MS71/ROS2Mower/README.md

# ROS2Mower
autonomous ROS2 lawn mower

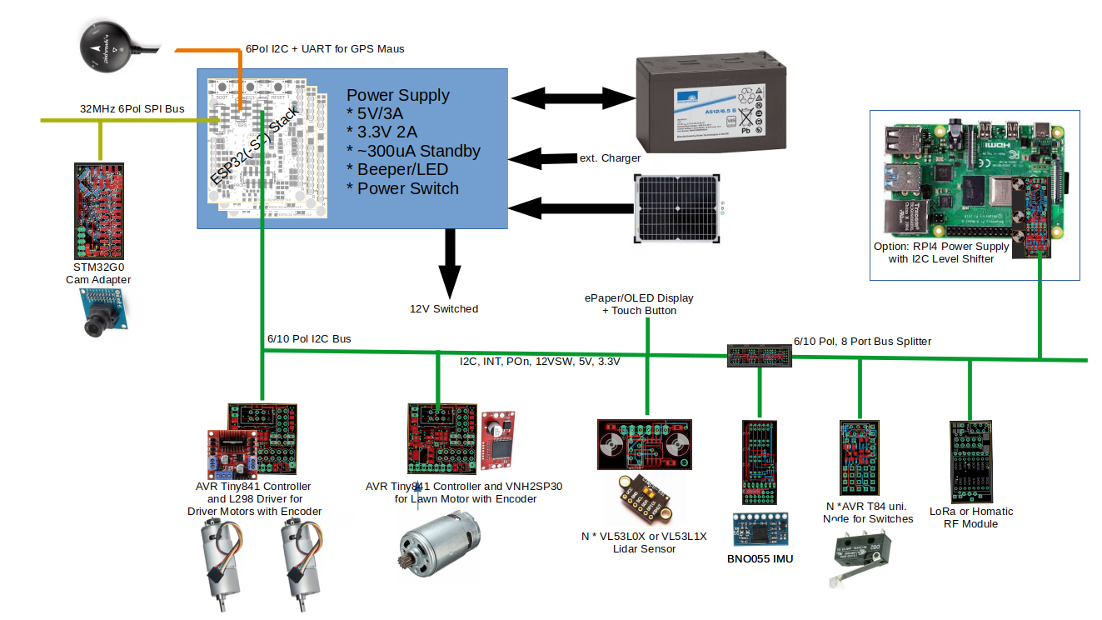
[picture p1: images/architecture_01.png]


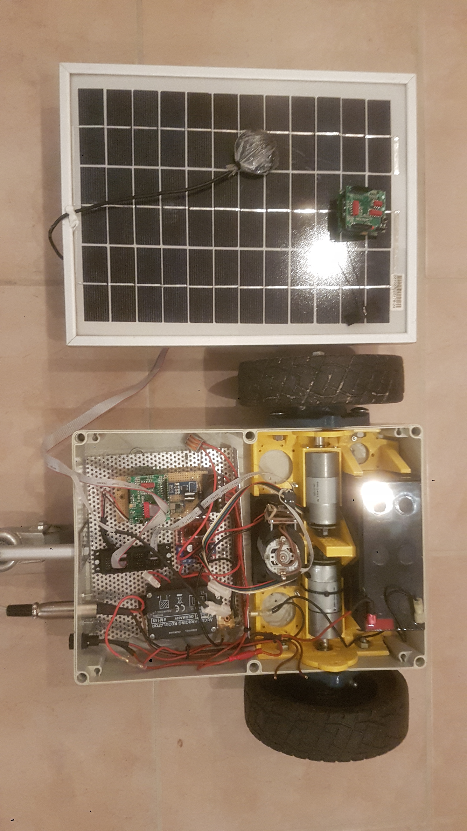
[picture p2: images/ros2mower_01.jpg]
