MS71/ROS2Mower/images/architecture_01.odp

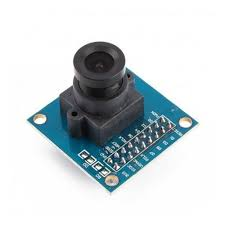
[picture p3: figure]
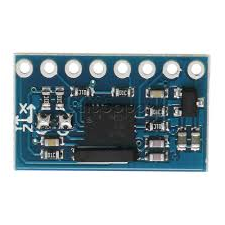
[picture p4: figure]
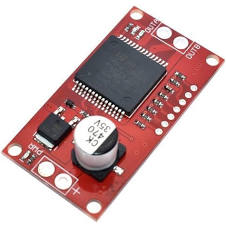
[picture p5: figure]

ESP32(-S2) Stack

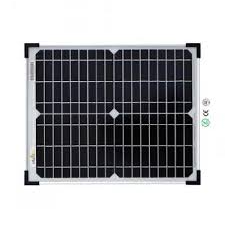
[picture p6: figure]
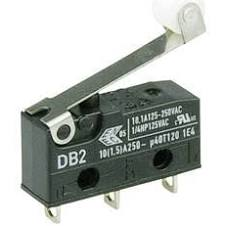
[picture p7: figure]
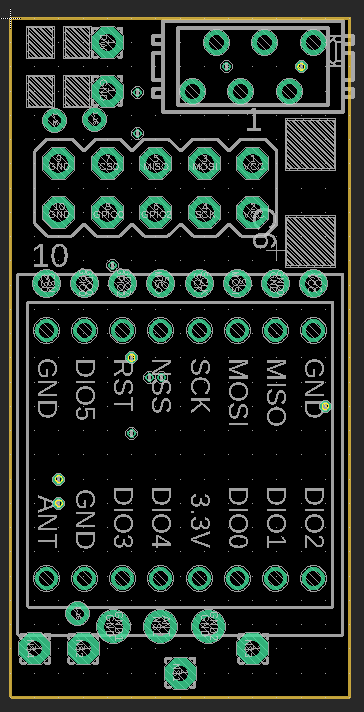
[picture p8: figure]
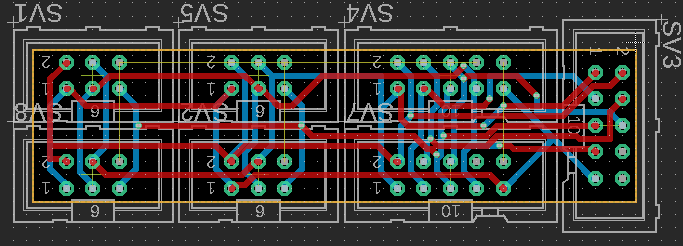
[picture p9: figure]
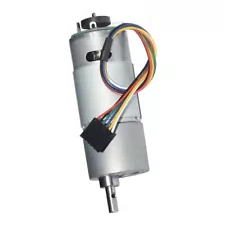
[picture p10: figure]
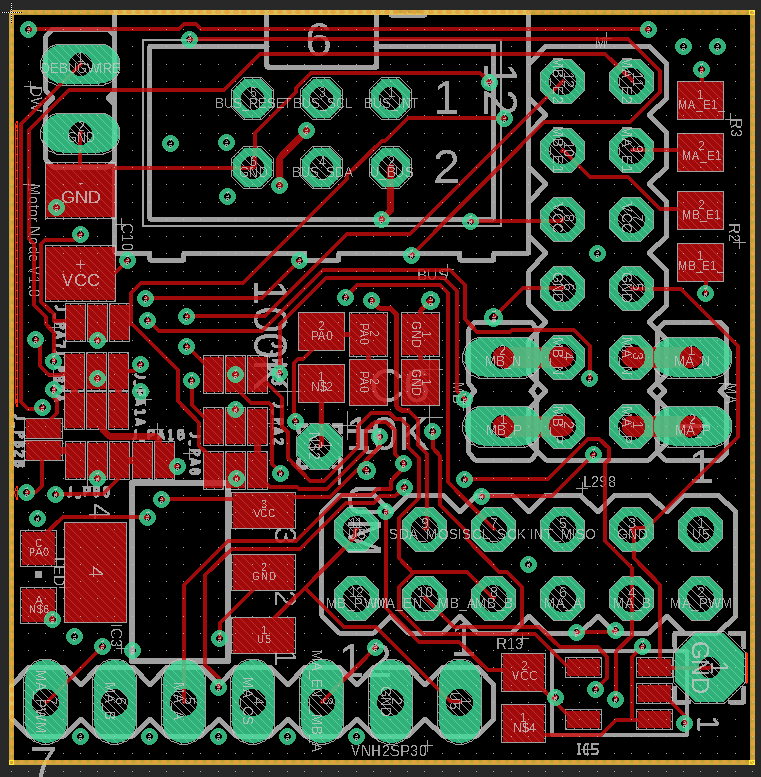
[picture p11: figure]
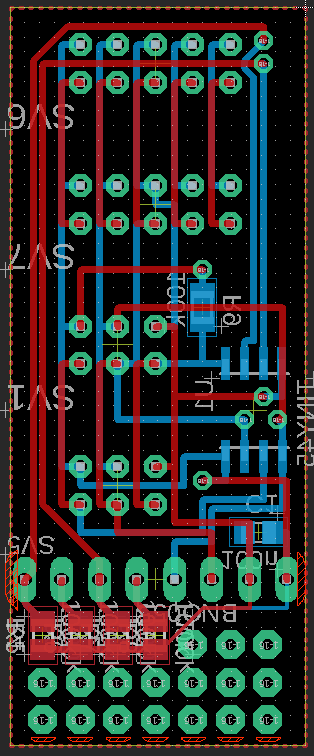
[picture p12: figure]
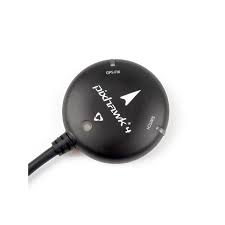
[picture p13: figure]
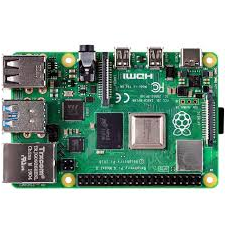
[picture p14: figure]

32MHz 6Pol SPI Bus

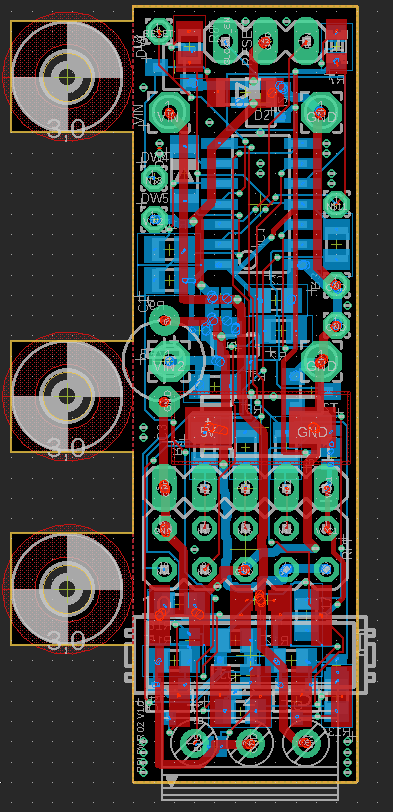
[picture p15: figure]

6Pol I2C + UART for GPS Maus

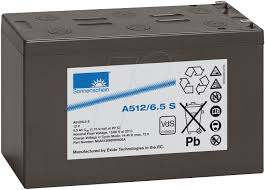
[picture p16: figure]
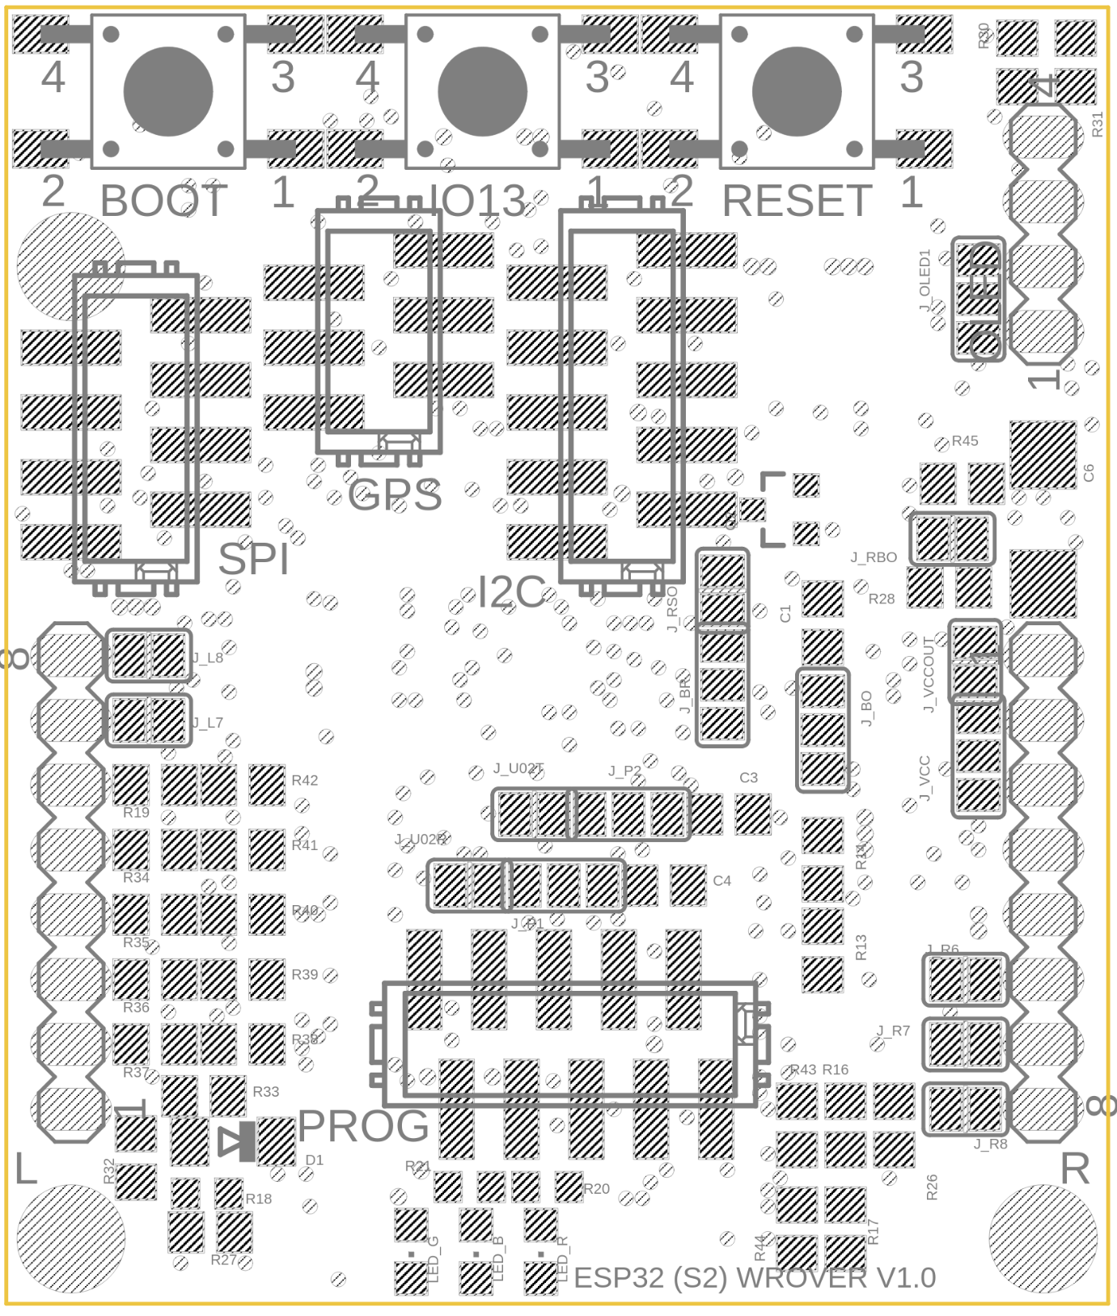
[picture p17: figure]

Power Supply

* 5V/3A

* 3.3V 2A

* ~300uA Standby

* Beeper/LED

* Power Switch

Option: RPI4 Power Supply

with I2C Level Shifter

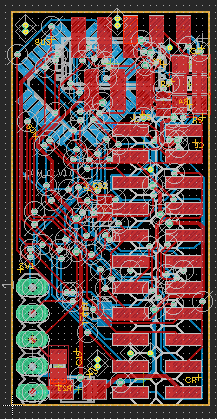
[picture p18: figure]

STM32G0

Cam Adapter

ext. Charger

6/10 Pol I2C Bus

12V Switched

ePaper/OLED Display

+ Touch Button

6/10 Pol, 8 Port Bus Splitter

I2C, INT, POn, 12VSW, 5V, 3.3V

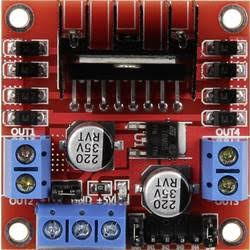
[picture p19: figure]
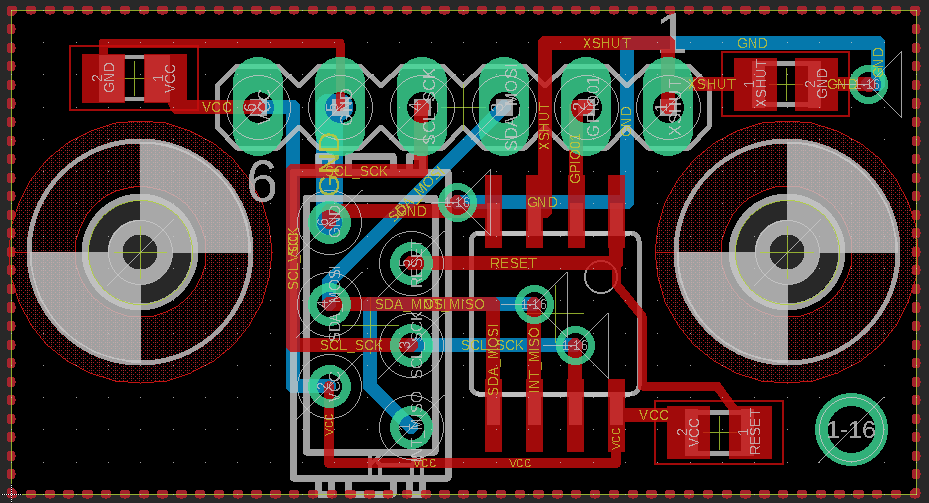
[picture p20: figure]
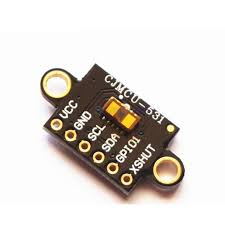
[picture p21: figure]

N * VL53L0X or VL53L1X

Lidar Sensor

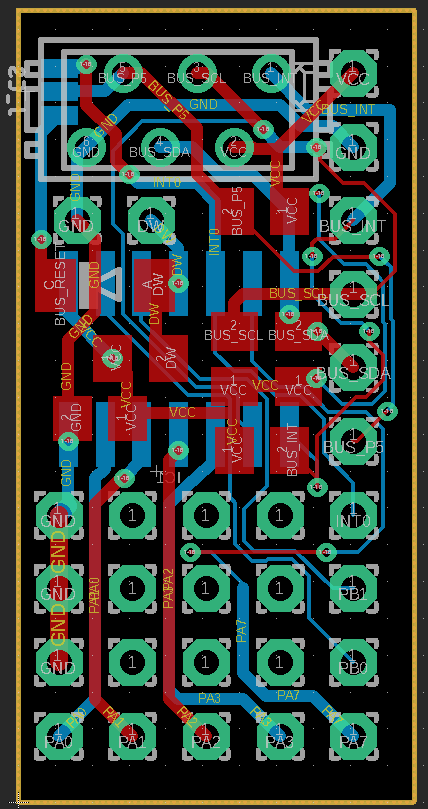
[picture p22: figure]

AVR Tiny841 Controller

and L298 Driver for

Driver Motors with Encoder

AVR Tiny841 Controller and VNH2SP30

for Lawn Motor with Encoder

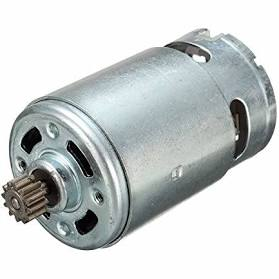
[picture p23: figure]

N *AVR T84 uni.

Node for Switches

LoRa or Homatic

RF Module

BNO055 IMU

BNO055 IMU
