MS71/ROS2Mower/3dparts/motorchassis_01.png

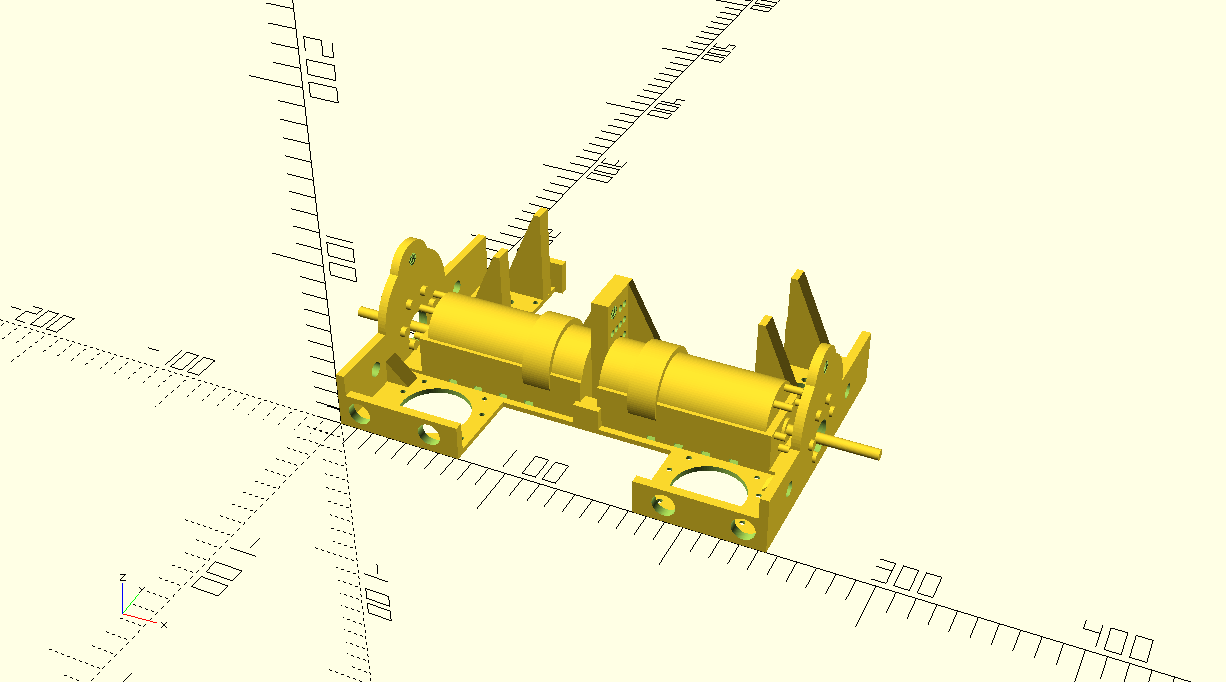
3dparts/motorchassis_01.png
