MS71/ROS2Mower/3dparts/nextgen_01.png

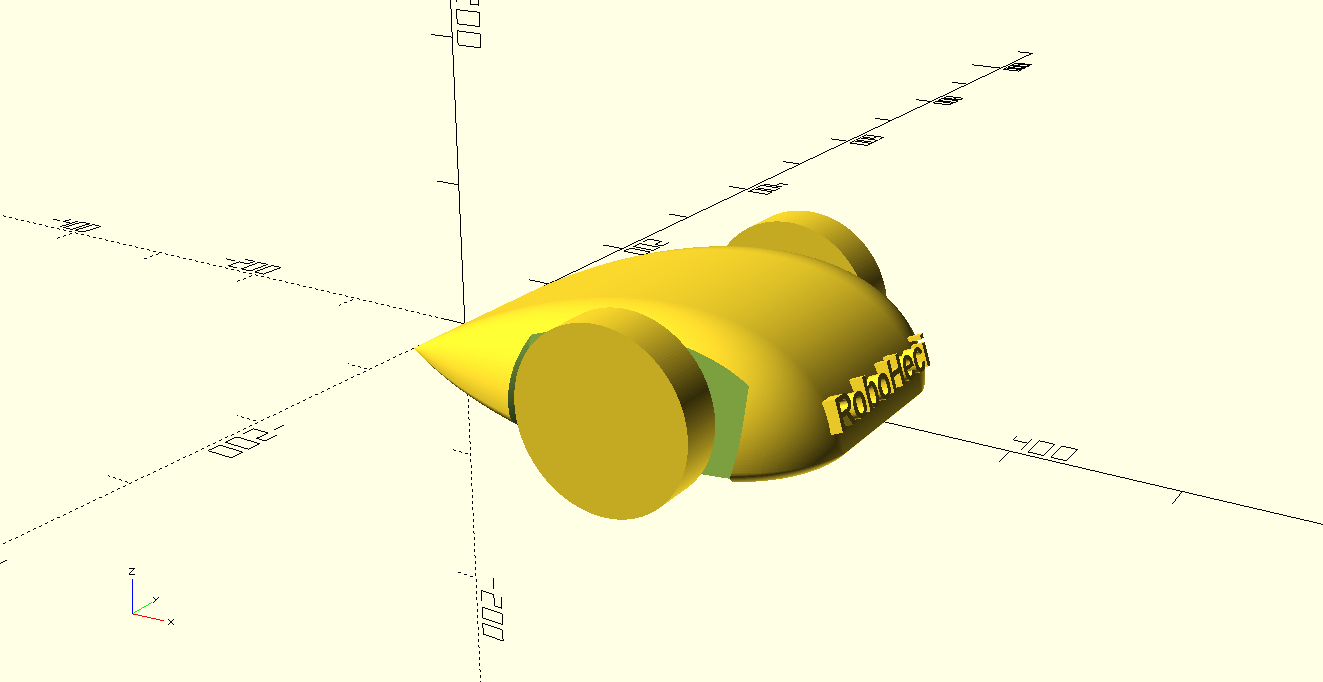
3dparts/nextgen_01.png
