MS71/ROS2Mower/3dparts/nextgen_01_unten.png

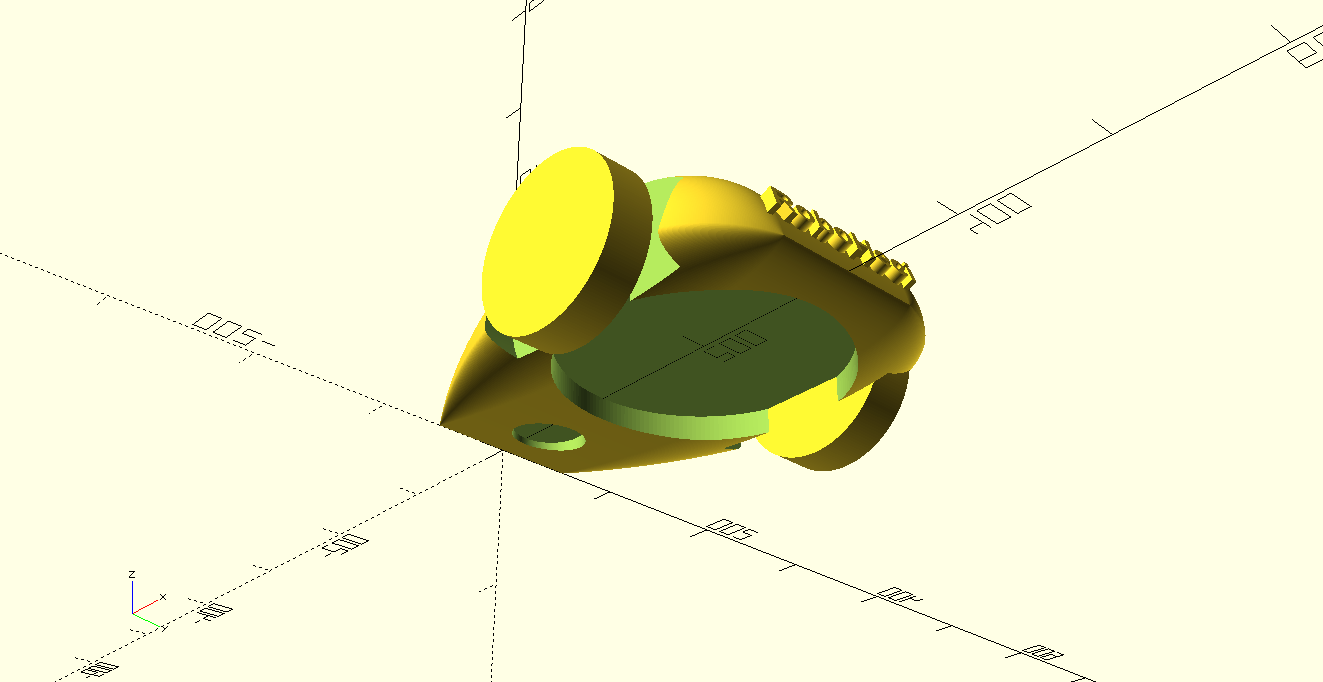
3dparts/nextgen_01_unten.png
