MS71/ROS2Mower/3dparts/busmux.stl

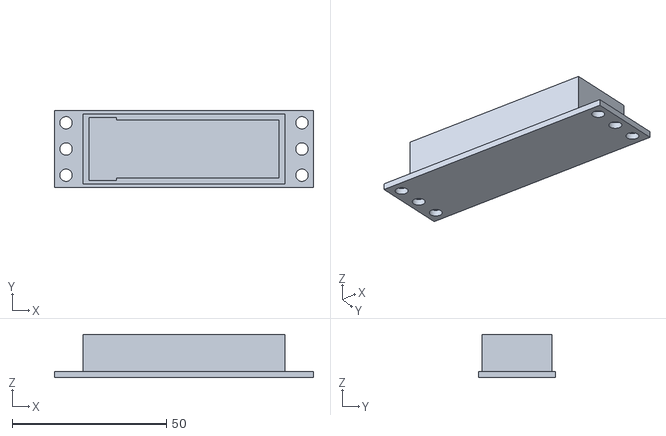
[picture p27: CAD file, 2021-01-19]
3dparts/busmux.stl
84.0 x 25.0 x 14.0
