MS71/ROS2Mower/(list of files, cad)

Other CAD files:
3dparts/motorchassis_02.scad
