MS71/ROS2Mower/hw/spi_node.pdf

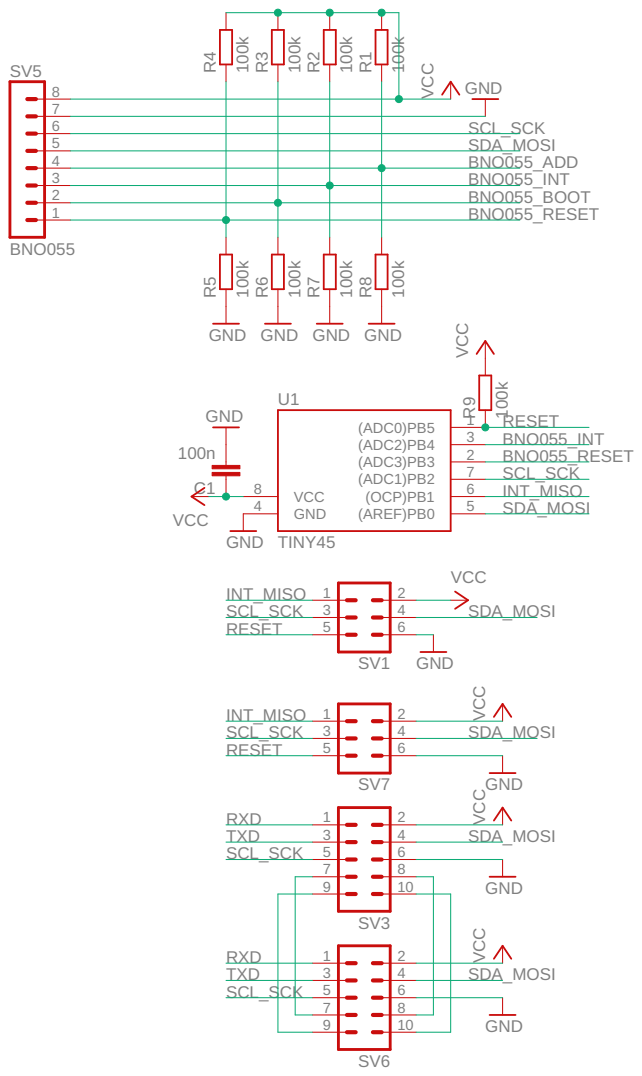
[picture p28: page 1]

GND GND

Document Number: | REV:

Date: 7/7/20 6:42 PM | Sheet: 1/1
