MS71/ROS2Mower/hw/motor_node_bot.pdf

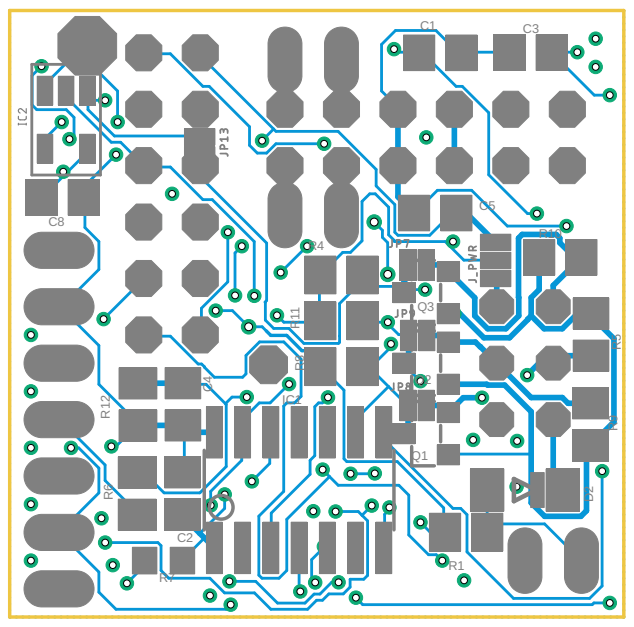
[picture p29: page 1]
