MS71/ROS2Mower/hw/motor_node_top.pdf

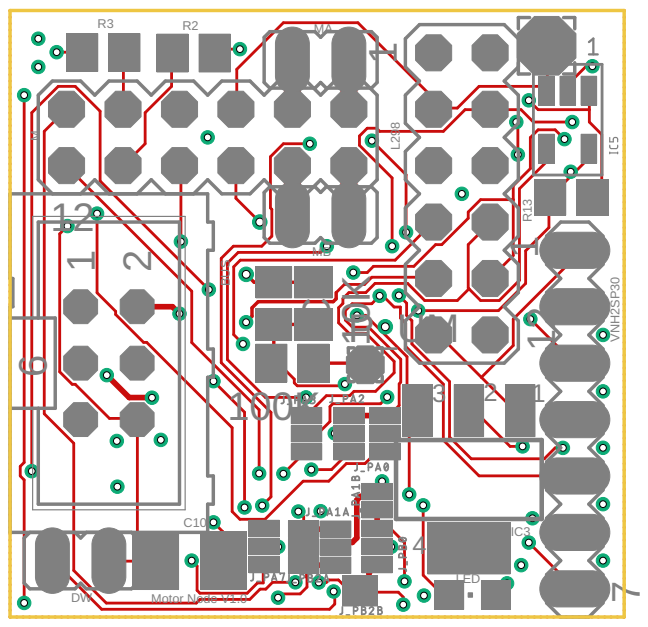
[picture p30: page 1]
