MS71/ROS2Mower/hw/lidar_node.pdf

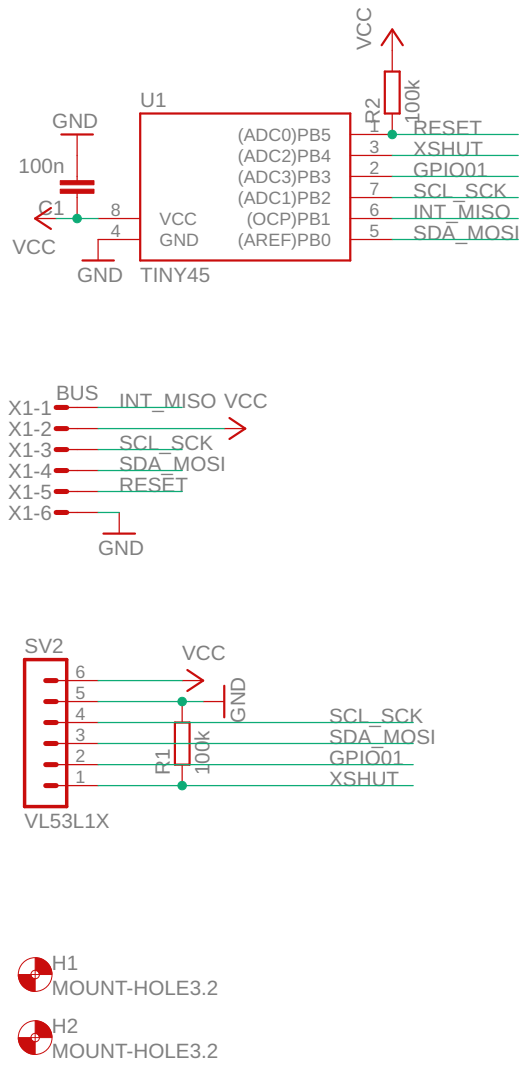
[picture p31: page 1]

Document Number: | REV:

Date: 6/22/20 8:21 PM | Sheet: 1/1
