MS71/ROS2Mower/hw/lidar_node_bot.pdf

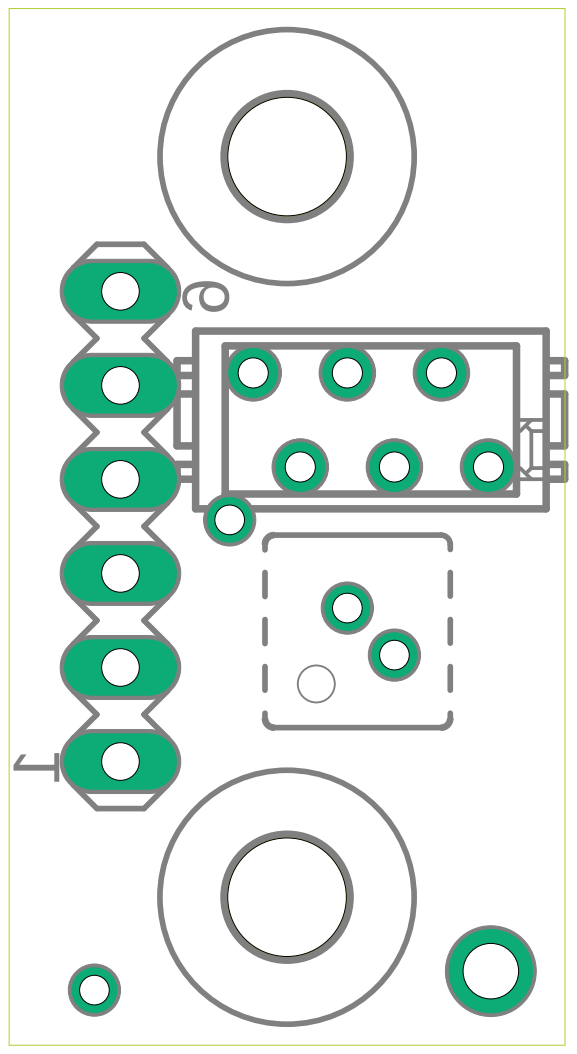
[picture p32: page 1]
