MS71/ROS2Mower/hw/lidar_node_top.pdf

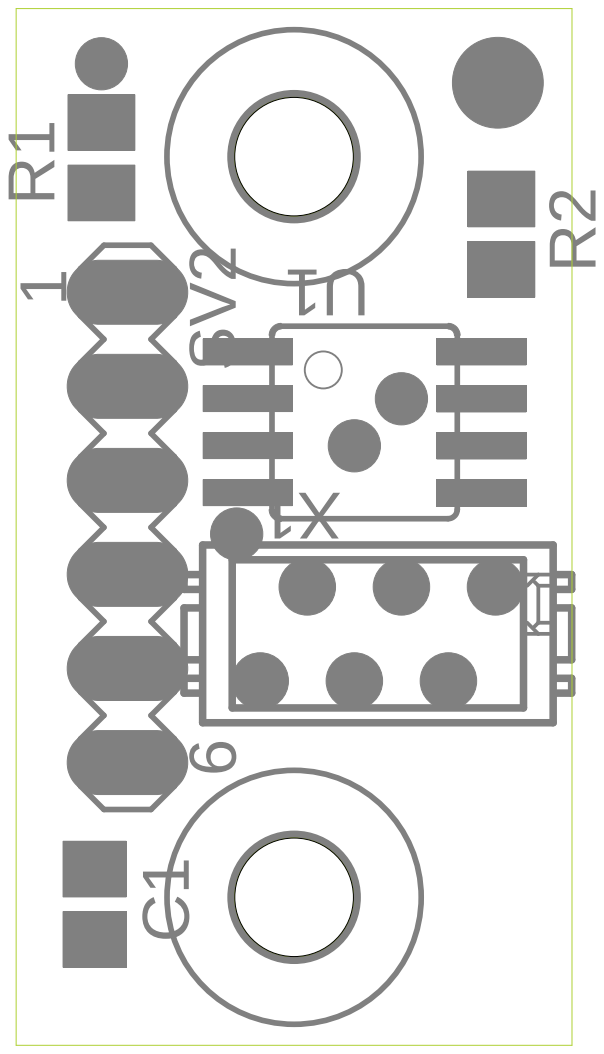
[picture p33: page 1]
