MS71/ROS2Mower/hw/spi_node_bot.pdf

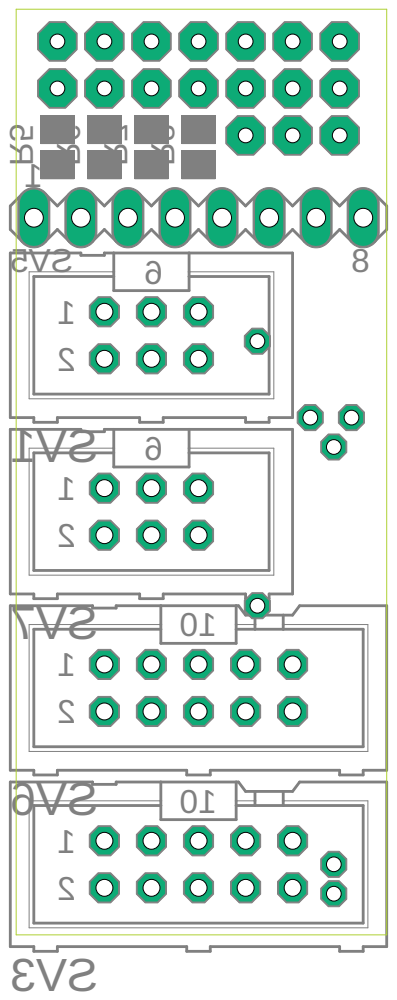
[picture p34: page 1]
