MS71/ROS2Mower/hw/spi_node_top.pdf

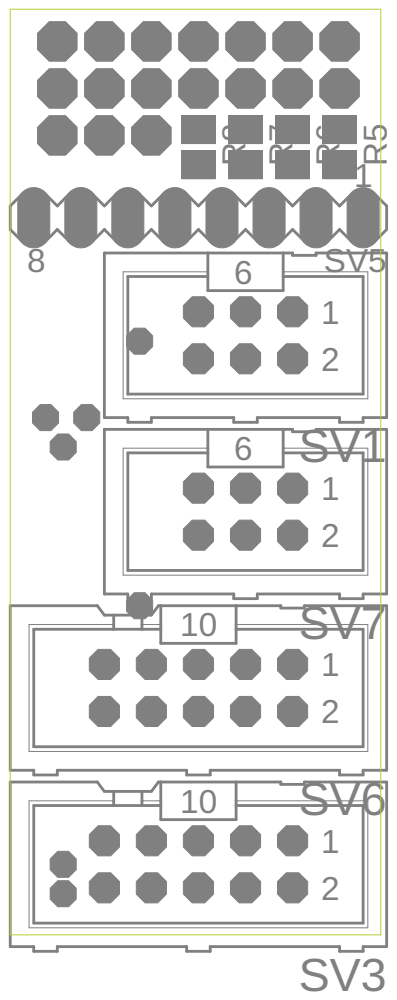
[picture p35: page 1]
