MS71/ROS2Mower/hw/uni_node.pdf

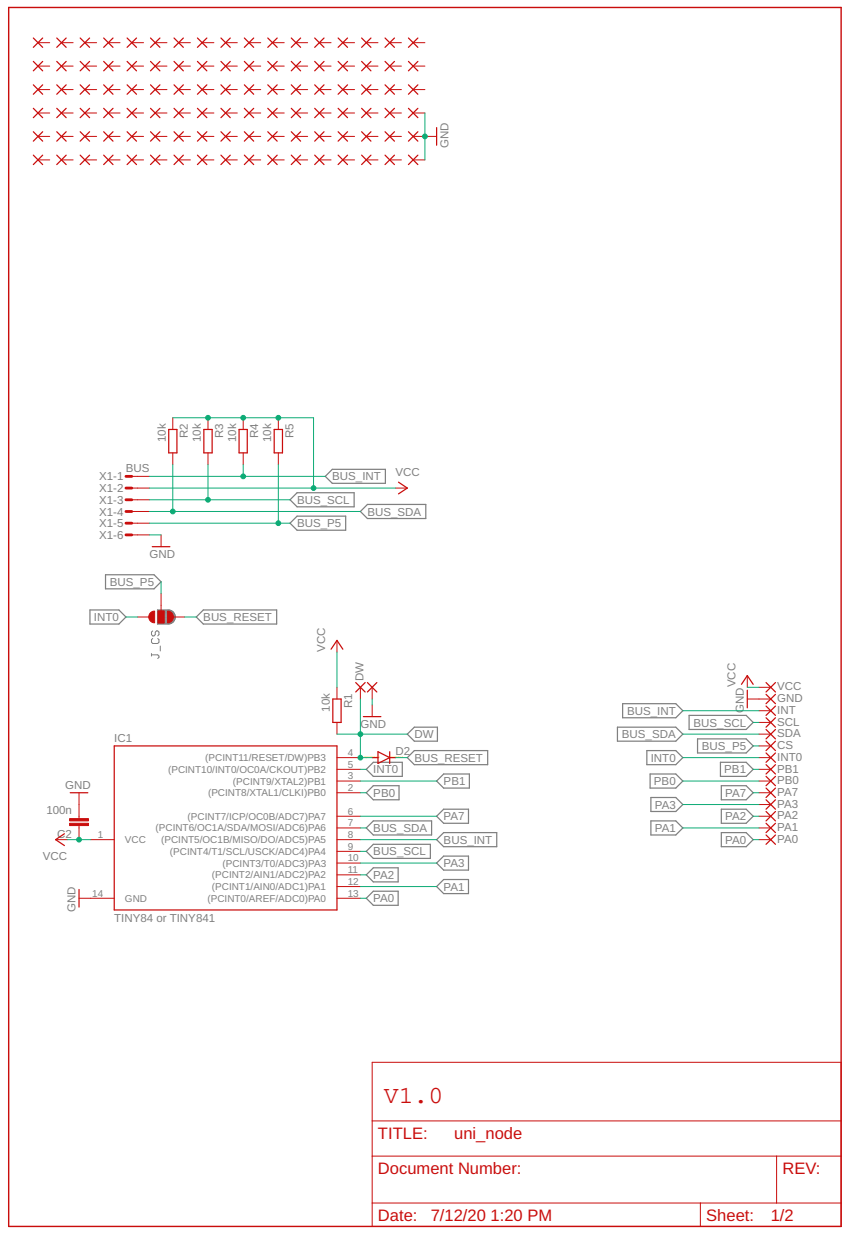
[picture p36: page 1]

Document Number: | REV:

Date: 7/12/20 1:20 PM | Sheet: 1/2
