MS71/ROS2Mower/hw/relais_node_01.pdf

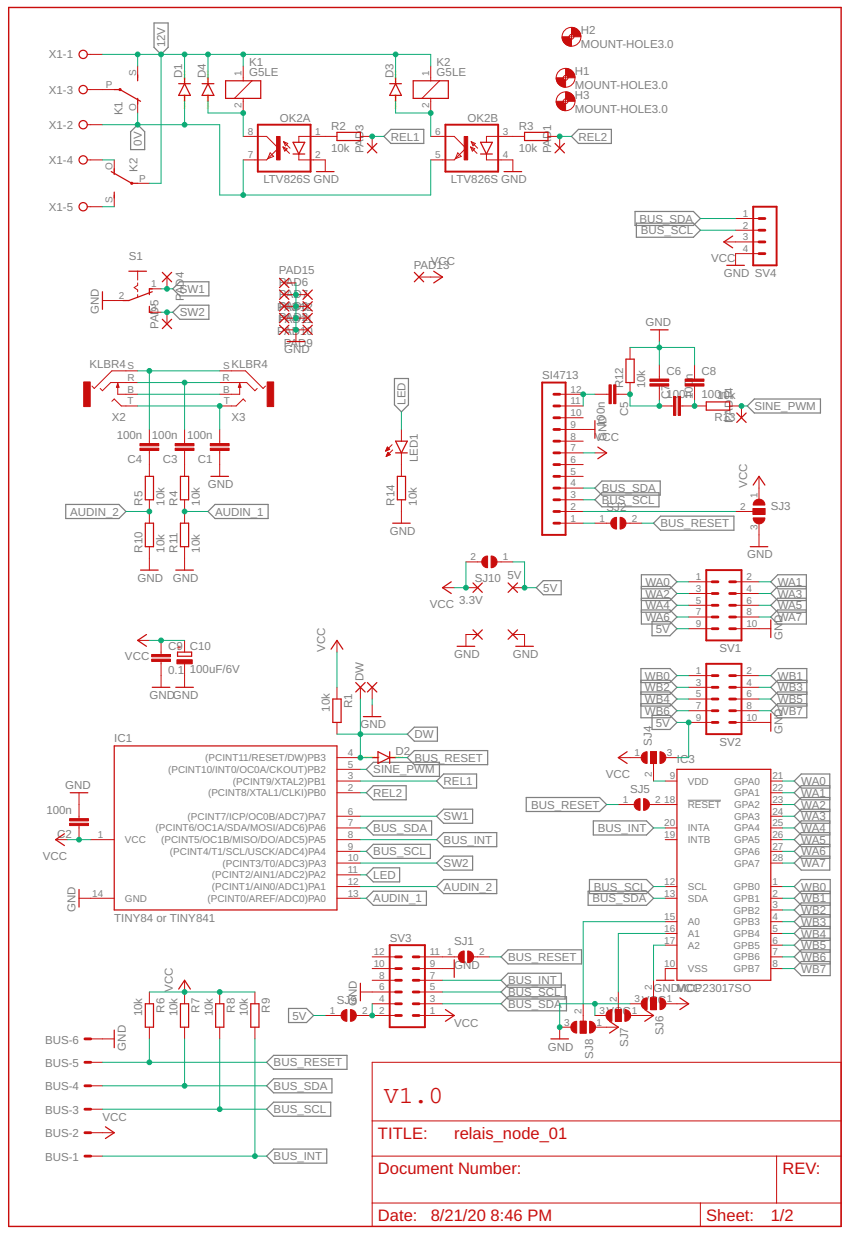
[picture p37: page 1]

Document Number: | REV:

Date: 8/21/20 8:46 PM | Sheet: 1/2
