MS71/ROS2Mower/hw/relais_node_01_bot.pdf

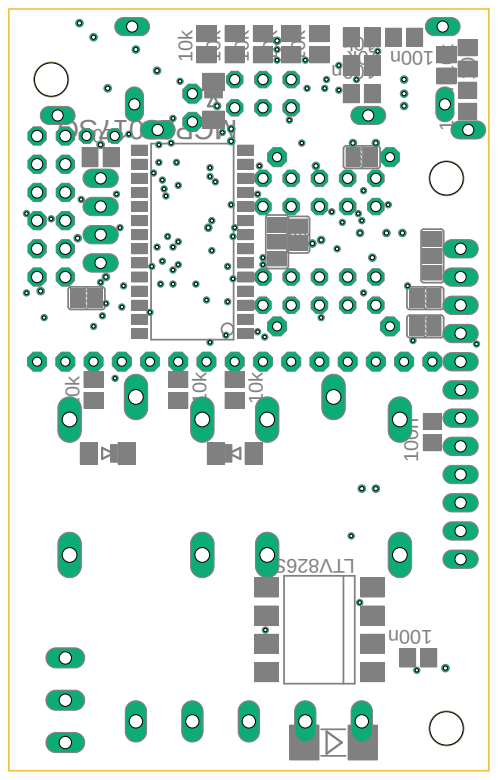
[picture p38: page 1]
