MS71/ROS2Mower/hw/relais_node_01_top.pdf

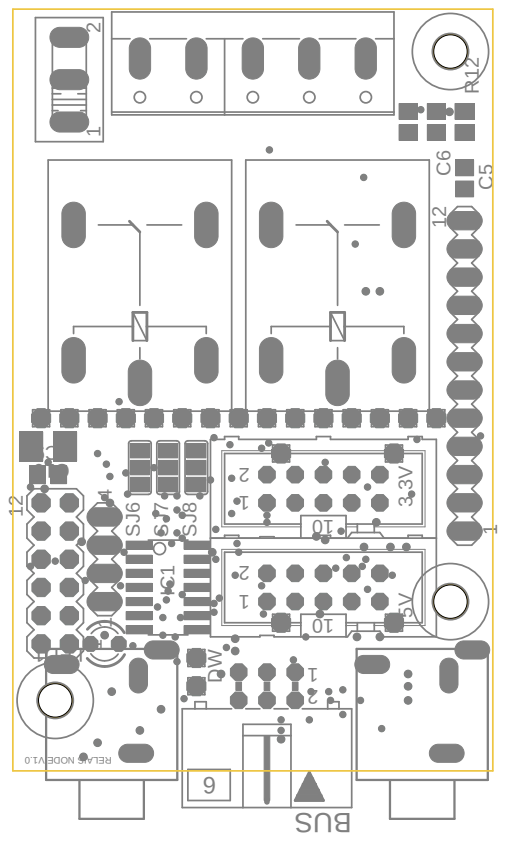
[picture p39: page 1]
