MS71/ROS2Mower/hw/rf_node.pdf

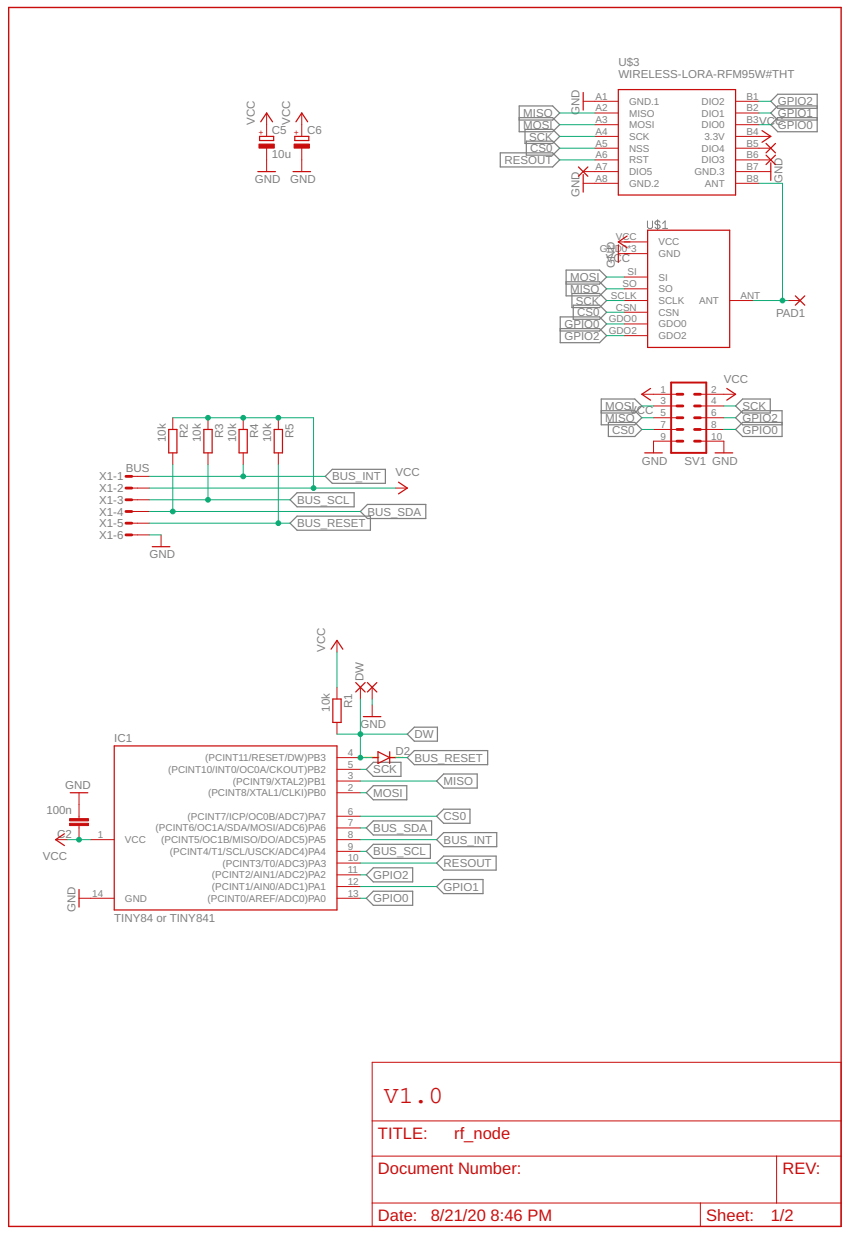
[picture p40: page 1]

Document Number: | REV:

Date: 8/21/20 8:46 PM | Sheet: 1/2
