MS71/ROS2Mower/hw/rf_node_bot.pdf

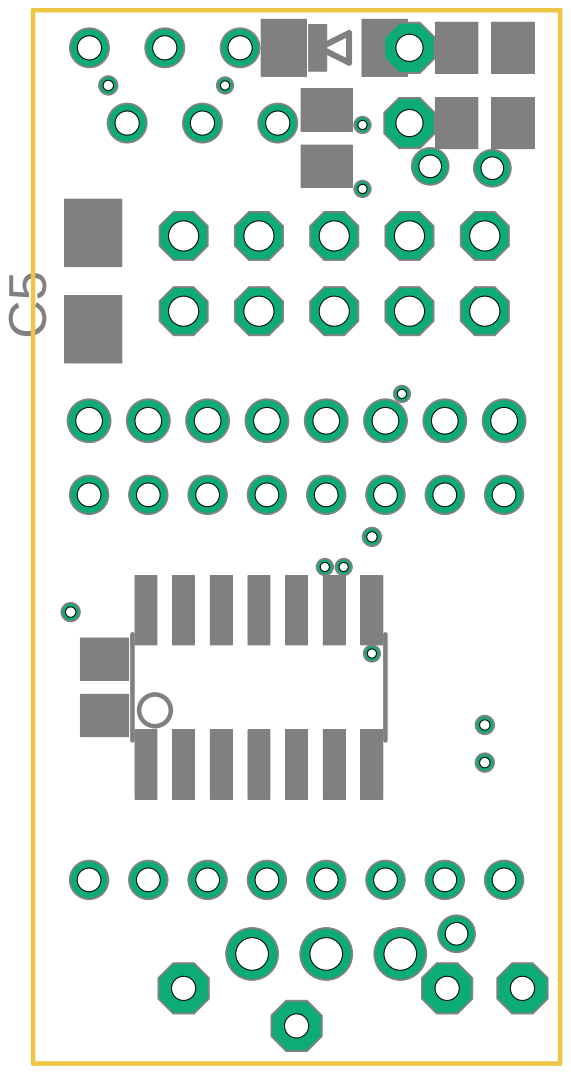
[picture p41: page 1]
