MS71/ROS2Mower/hw/rf_node_top.pdf

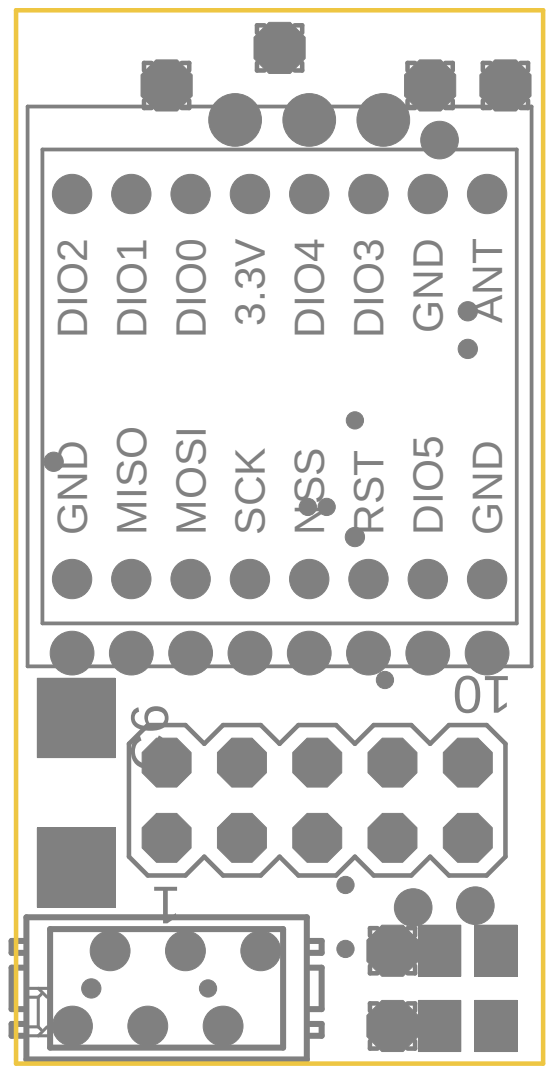
[picture p42: page 1]
