MS71/ROS2Mower/hw/stm32g071_pcb.pdf

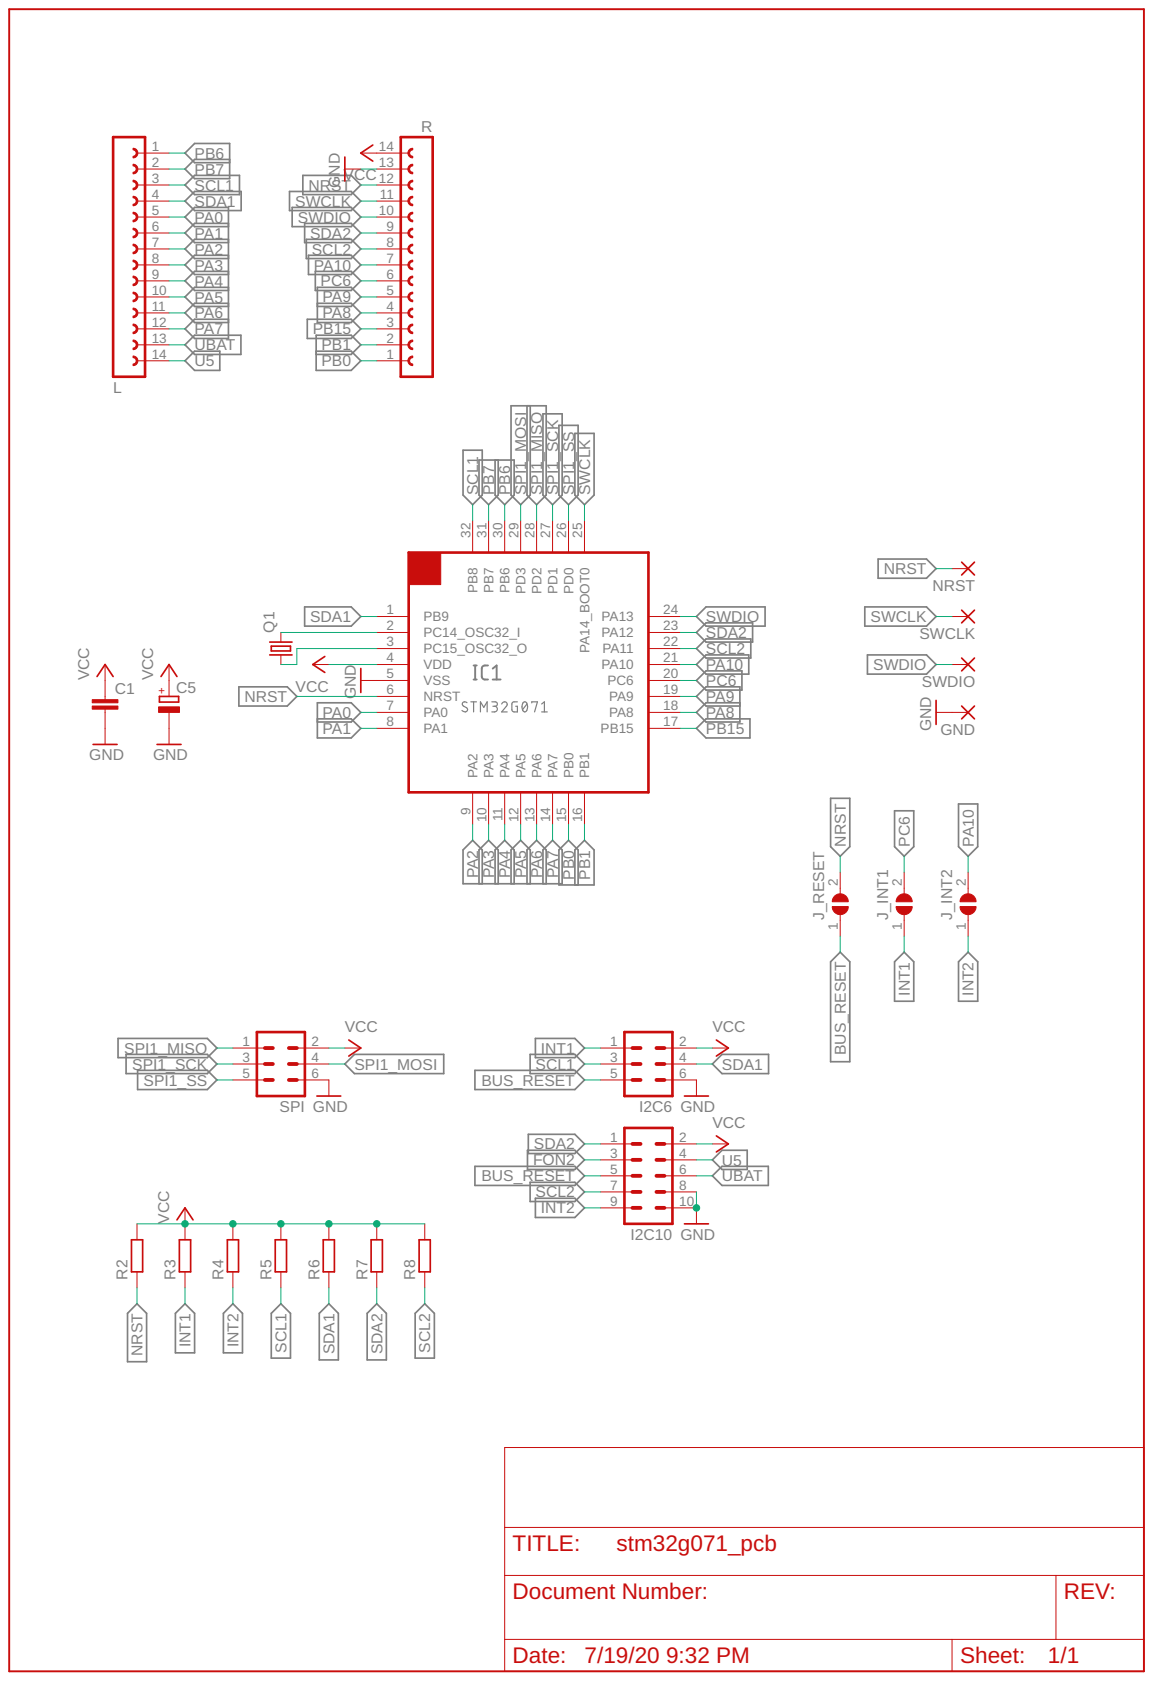
[picture p43: page 1]

Document Number: | REV:

Date: 7/19/20 9:32 PM | Sheet: 1/1
