MS71/ROS2Mower/hw/stm32g071_pcb_bot.pdf

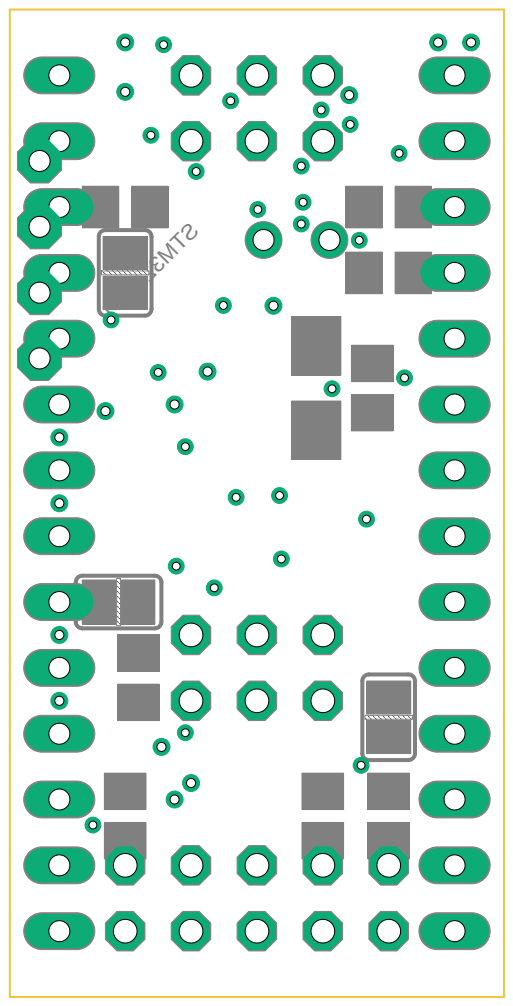
[picture p44: page 1]
