MS71/ROS2Mower/hw/stm32g071_pcb_top.pdf

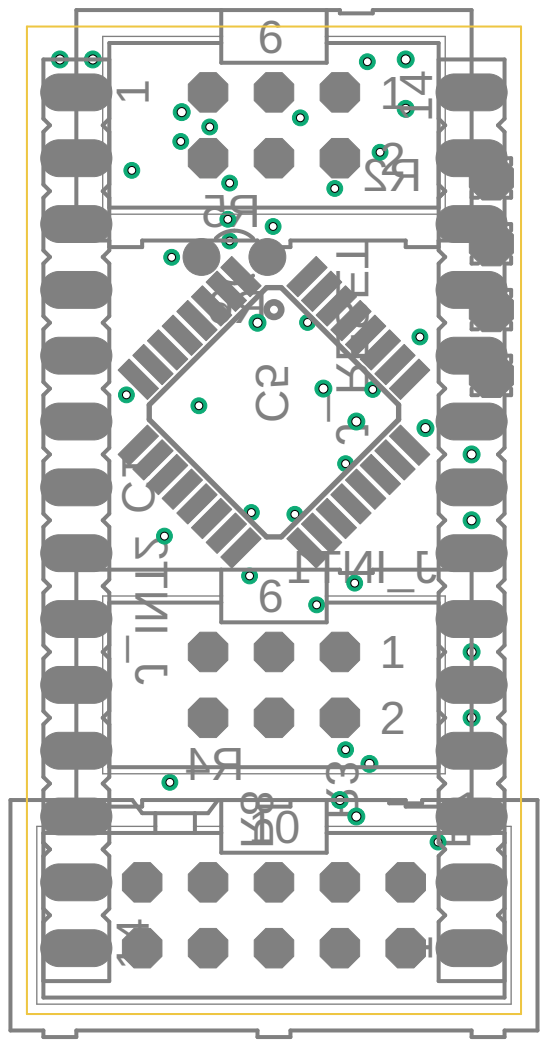
[picture p45: page 1]
