MS71/ROS2Mower/hw/uni_node_02.pdf

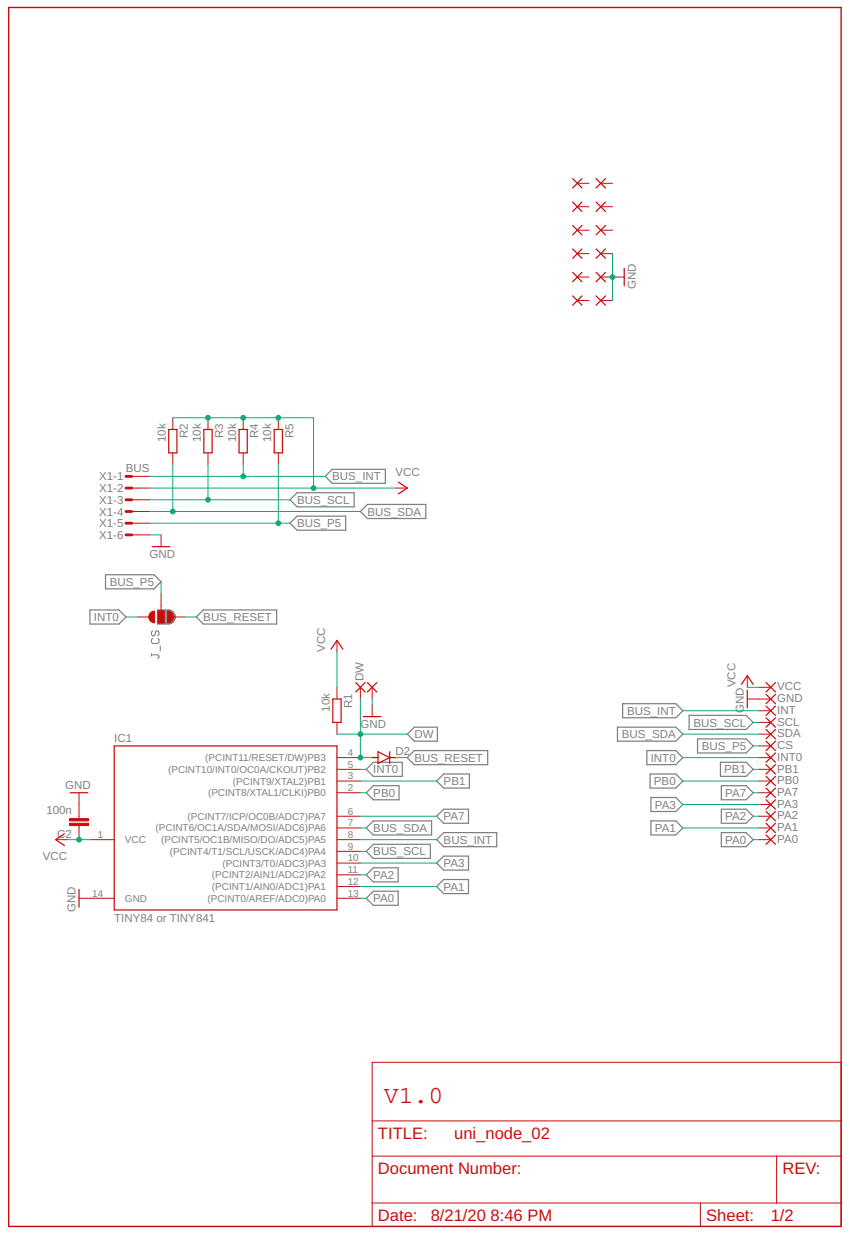
[picture p46: page 1]

Document Number: | REV:

Date: 8/21/20 8:46 PM | Sheet: 1/2
