MS71/ROS2Mower/hw/uni_node_02_bot.pdf

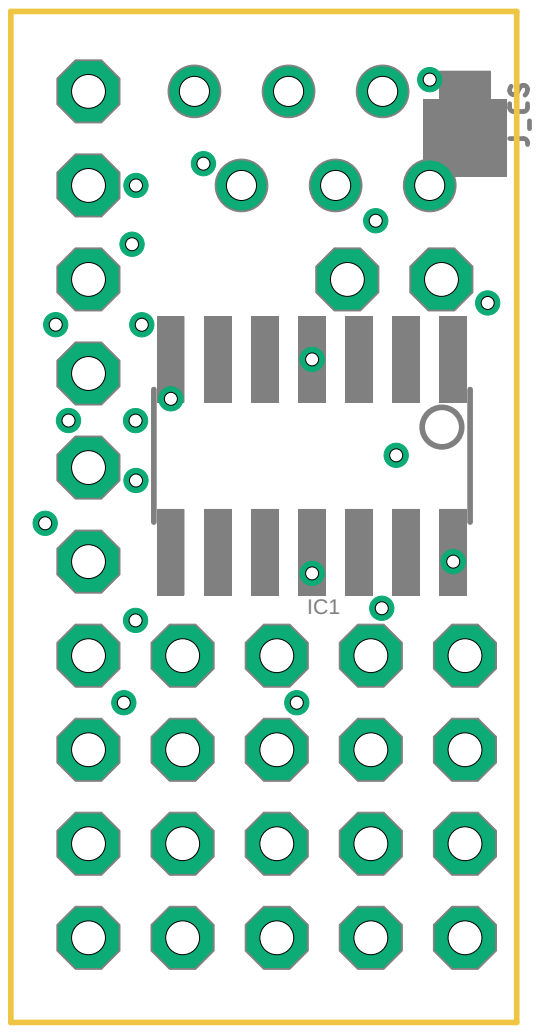
[picture p47: page 1]
