MS71/ROS2Mower/hw/uni_node_02_top.pdf

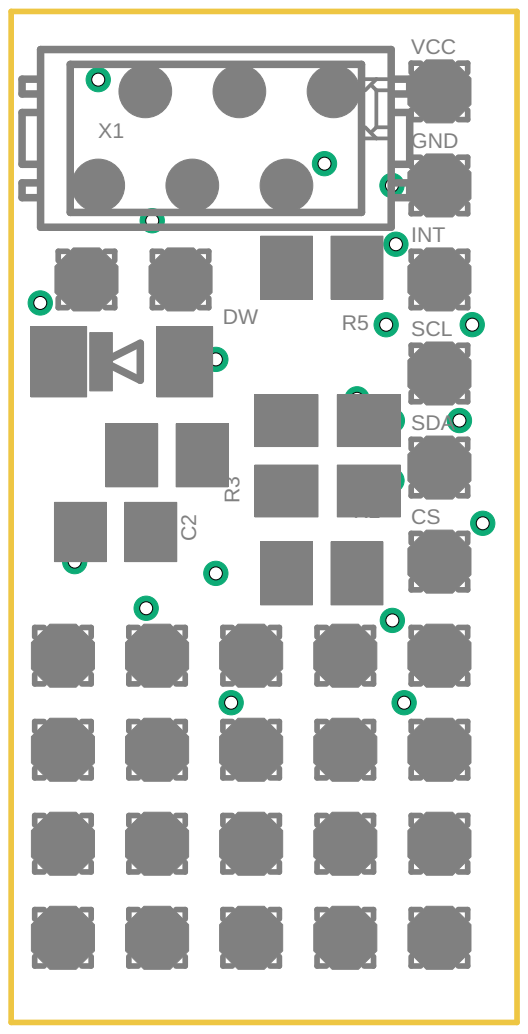
[picture p48: page 1]
