MS71/ROS2Mower/hw/uni_node_bot.pdf

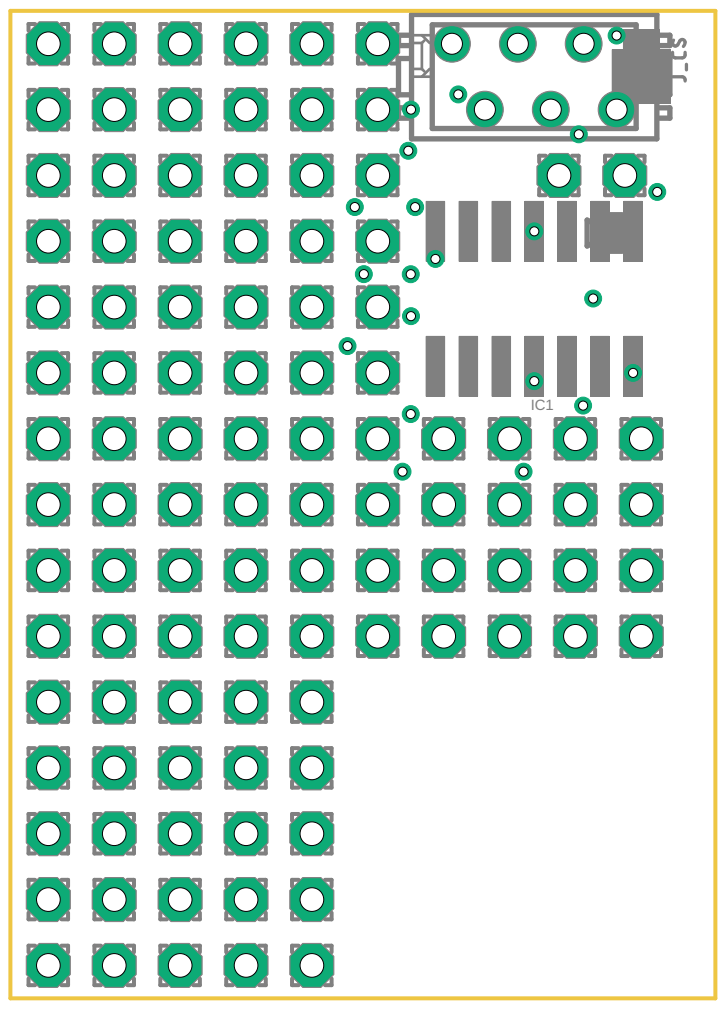
[picture p49: page 1]
