MS71/ROS2Mower/hw/uni_node_top.pdf

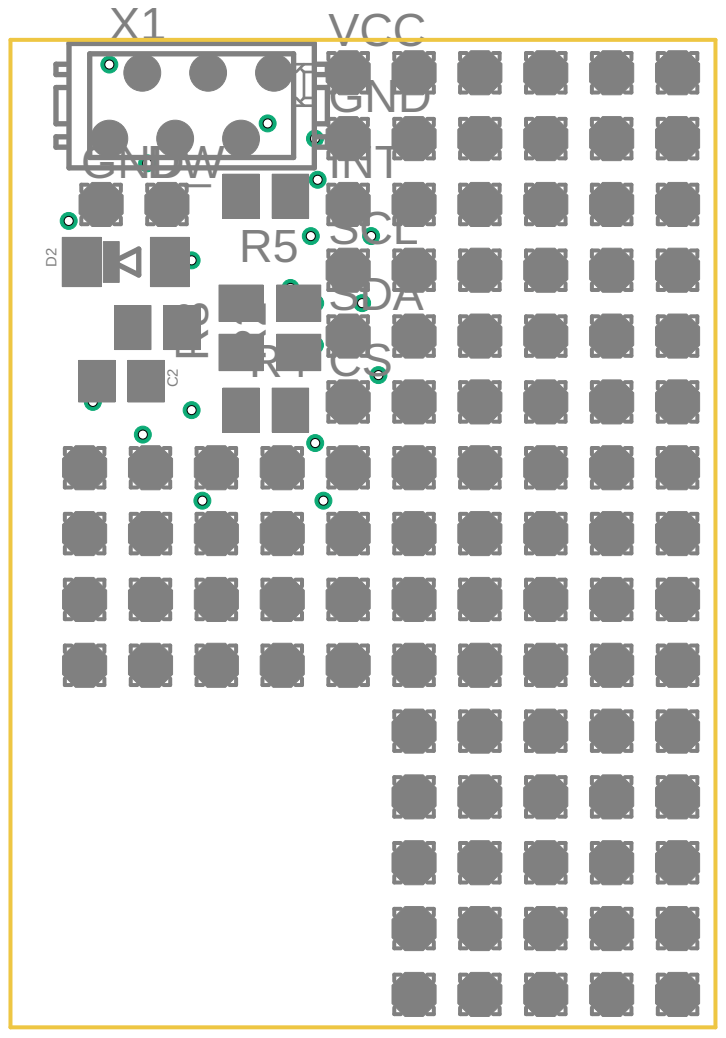
[picture p50: page 1]
