MS71/ROS2Mower/hw/esp32_module.pdf

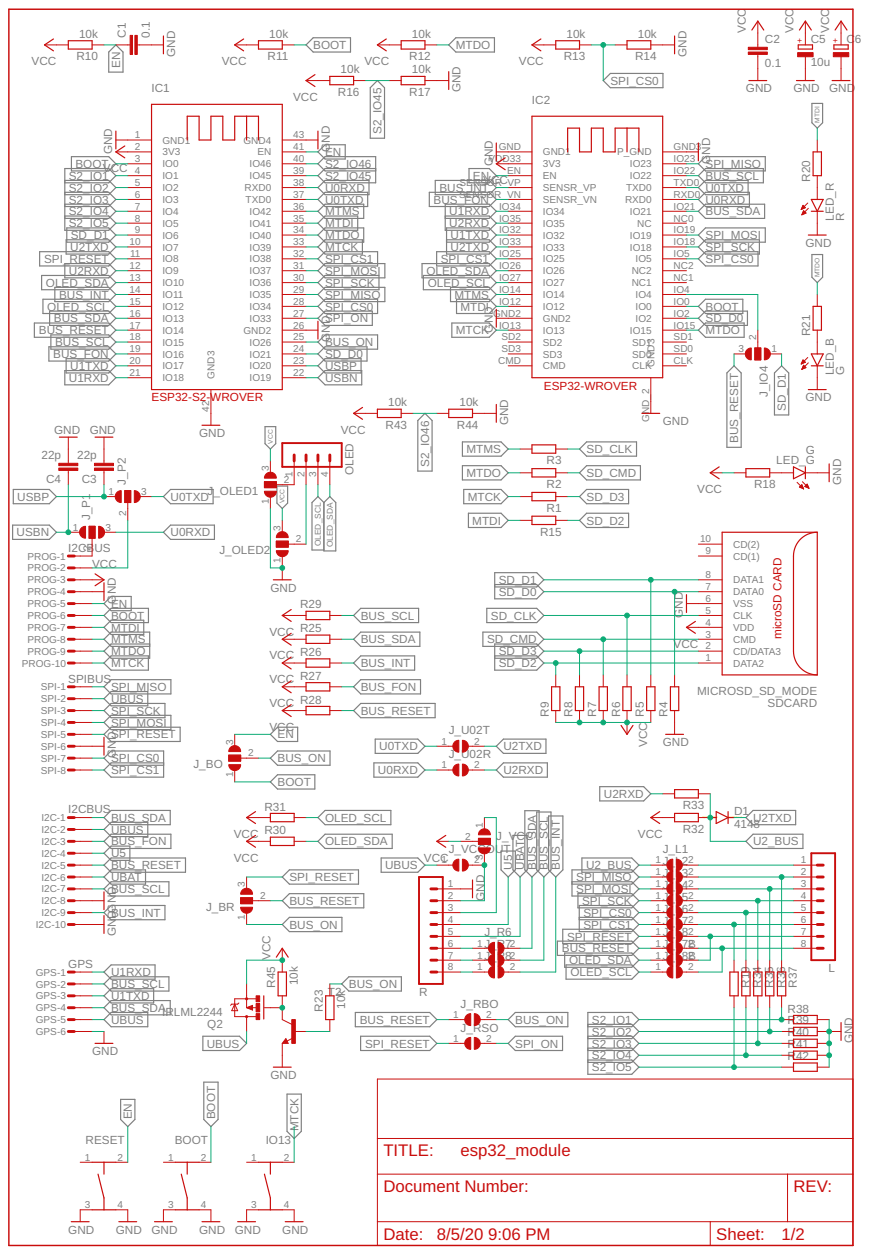
[picture p51: page 1]

Document Number: | REV:

Date: 8/5/20 9:06 PM | Sheet: 1/2
