MS71/ROS2Mower/hw/esp32_module_bot.pdf

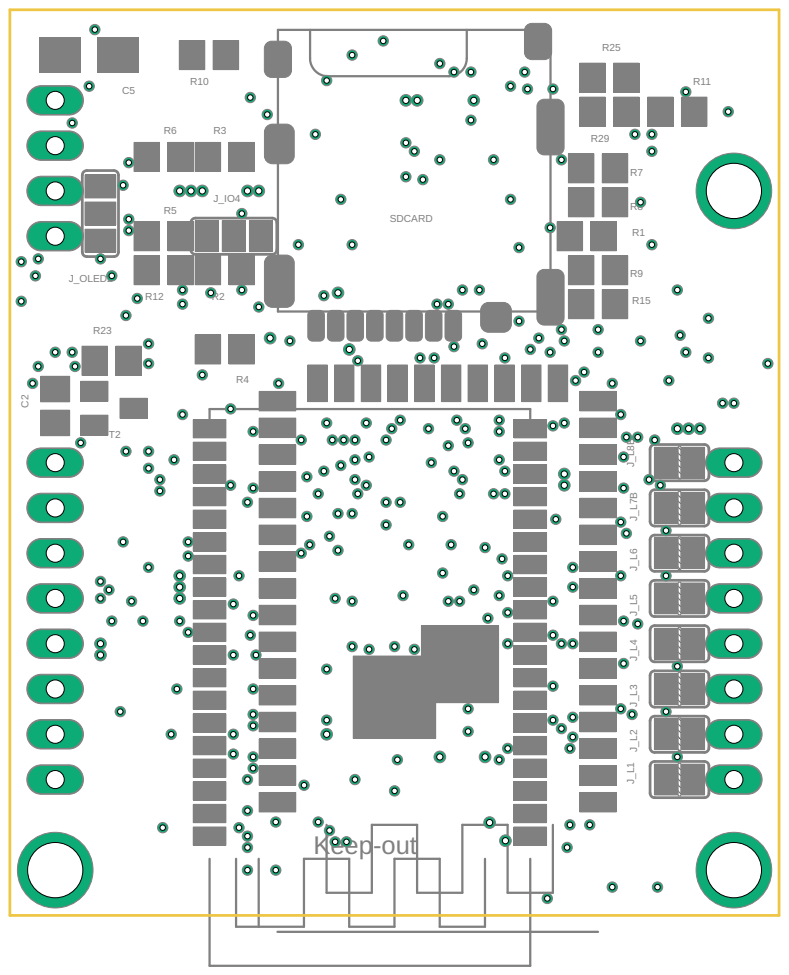
[picture p52: page 1]
