MS71/ROS2Mower/hw/esp32_module_top.pdf

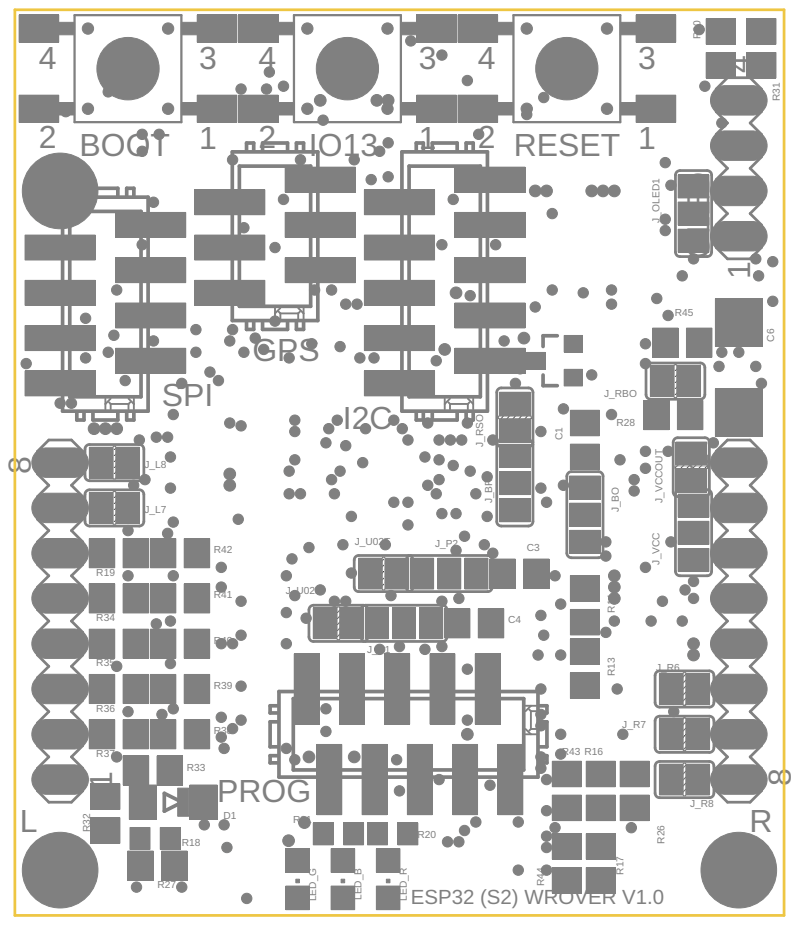
[picture p53: page 1]
