MS71/ROS2Mower/hw/motor_bot.pdf

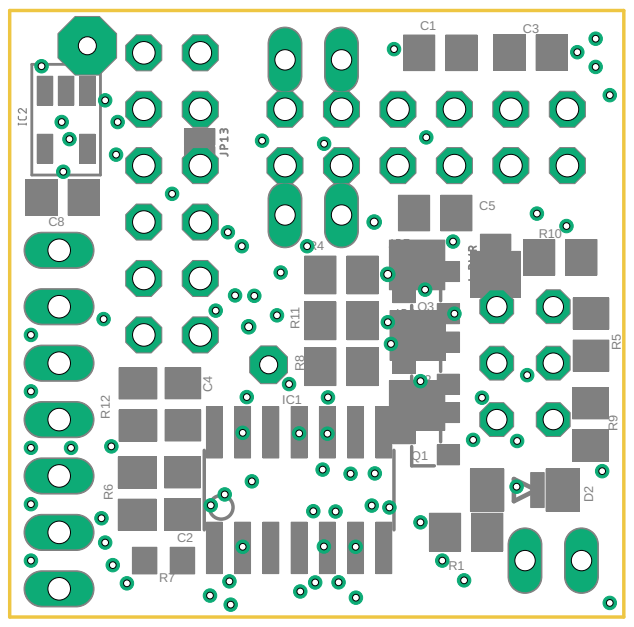
[picture p54: page 1]
