MS71/ROS2Mower/hw/motor_node.pdf

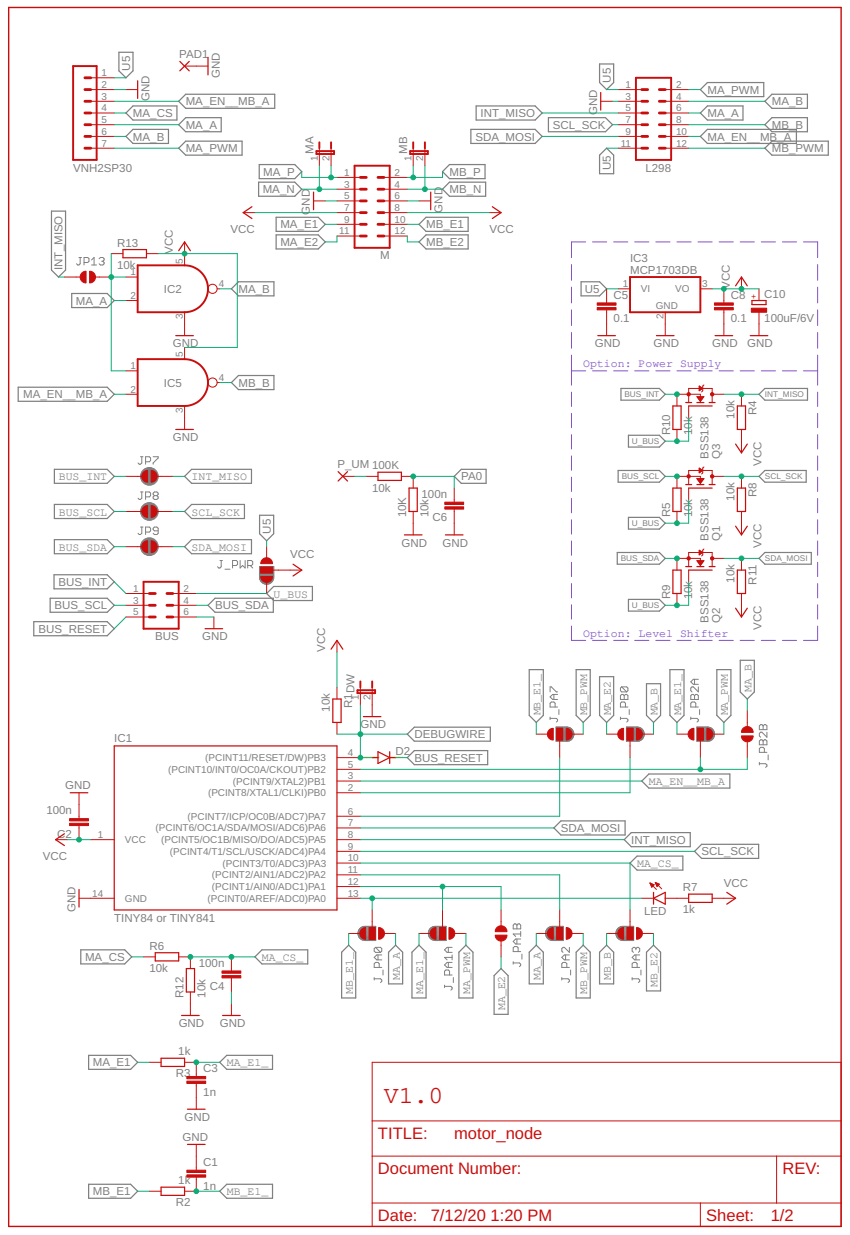
[picture p55: page 1]

Document Number: | REV:

Date: 7/12/20 1:20 PM | Sheet: 1/2
