MS71/ROS2Mower/hw/esp32_module.brd

## EAGLE design hw/esp32_module.brd (2021-11-24)

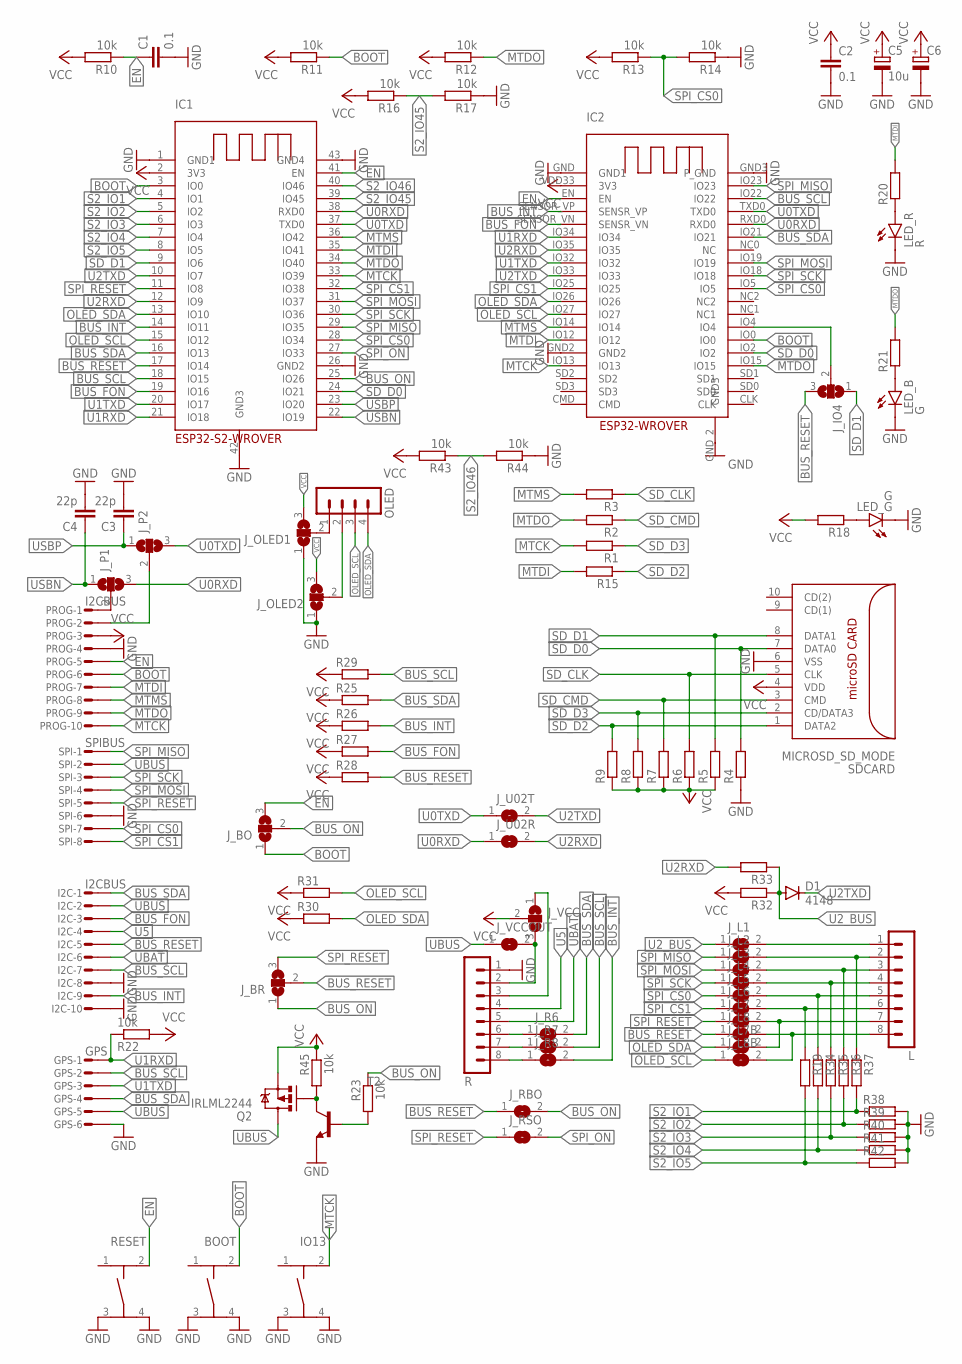
[picture p56: schematic esp32_module.sch, sheet 1]

Parts:
BOOT: TASTER-9314_SMD
C1, C2: 0.1; C0805
C3, C4: 22p; C0805
C5: 10u; B/3528-21W
C6: CPOL-EUC/6032-28R; C/6032-28R
D1: 4148; MINIMELF
GPS: GPS; MICROMATCH-6SMD
I2C: I2CBUS; MICROMATCH-10SMD
IC1: ESP32-S2_WROVER; ESP32-S2-WROVER
IC2: ESP32-WROVER
IO13: TASTER-9314_SMD
J_BO: SJ2W; SJ_2
J_BR: SJ2W; SJ_2
J_IO4: SJ2W; SJ_2
J_L1, J_L2, J_L3, J_L4, J_L5, J_L6, J_L7, J_L7B, J_L8, J_L8B: SJ
J_OLED1, J_OLED2: SJ2W; SJ_2
J_P1, J_P2: SJ2W; SJ_2
J_R6, J_R7, J_R8: SJ
J_RBO: SJ
J_RSO: SJ
J_U02R, J_U02T: SJ
J_VCC: SJ2W; SJ_2
J_VCCOUT: SJ
L: MA08-1
LED_B: G; CHIPLED_0805
LED_G: G; CHIPLED_0805
LED_R: R; CHIPLED_0805
OLED: MA04-1
PROG: I2CBUS; MICROMATCH-10SMD
Q2: IRLML2244; SOT23-3
R: MA08-1
R1, R2, R3, R4, R5, R6, R7, R8, R9, R15, R19, R25, R26, R27, R28, R29, R30, R31, R32, R33, R34, R35, R36, R37, R38, R39, R40, R41, R42: R-EU_R0805; R0805
R10, R11, R12, R13, R14, R16, R17, R22, R23, R43, R44, R45: 10k; R0805
R18, R20, R21: R-EU_R0603; R0603
RESET: TASTER-9314_SMD
SDCARD: MICROSD_SD_MODE; MICRO_SD_CONNECTOR
SPI: SPIBUS; MICROMATCH-8-SMD
T2: BC817-16-NPN-SOT23-BEC; SOT23-BEC

Connections:
BOOT: BOOT.2, IC1.3 (IO0), IC2.IO0, J_BO.1, PROG.6, R11.1
BUS_FON: I2C.3, IC1.19 (IO16), IC2.SENSOR_VN (SENSR_VN), R27.2
BUS_INT: I2C.9, IC1.14 (IO11), IC2.SENSOR_VP (SENSR_VP), J_R8.2, R26.2
BUS_ON: IC1.25 (IO26), J_BO.2, J_BR.1, J_RBO.2, R23.1
BUS_RESET: I2C.5, IC1.17 (IO14), J_BR.2, J_IO4.3, J_L8.1, J_RBO.1, R28.2
BUS_SCL: GPS.2, I2C.7, IC1.18 (IO15), IC2.IO22, J_R7.2, R29.2
BUS_SDA: GPS.4, I2C.1, IC1.16 (IO13), IC2.IO21, J_R6.2, R25.2
EN: C1.1, IC1.41 (EN), IC2.EN, J_BO.3, PROG.5, R10.1, RESET.2
GND: BOOT.3, BOOT.4, C1.2, C2.2, C3.2, C4.2, C5.-, C6.-, GPS.6, I2C.8, I2C.10, IC1.1 (GND1), IC1.26 (GND2), IC1.42 (GND3), IC1.43 (GND4), IC2.GND (GND1), IC2.GND2, IC2.GND3 (P_GND), IC2.GND_2 (GND3), IO13.3, IO13.4, J_OLED1.1, J_OLED2.1, LED_B.C, LED_G.C, LED_R.C, PROG.4, R.1, R4.1, R14.1, R17.1, R38.2, R39.2, R40.2, R41.2, R42.2, R44.1, RESET.3, RESET.4, SDCARD.6 (VSS), SPI.6, T2.E
LCD_1: J_OLED1.2, OLED.1
LCD_2: J_OLED2.2, OLED.2
MTCK: IC1.33 (IO39), IC2.IO13, IO13.2, PROG.10, R1.2
MTDI: IC1.35 (IO41), IC2.IO12, PROG.7, R15.2, R20.2
MTDO: IC1.34 (IO40), IC2.IO15, PROG.9, R2.2, R12.1, R21.2
MTMS: IC1.36 (IO42), IC2.IO14, PROG.8, R3.2
unnamed: IC2.IO4, J_IO4.2
unnamed: Q2.1 (G), R45.2, T2.C
unnamed: J_R6.1, R.6
unnamed: LED_G.A, R18.1
unnamed: J_R7.1, R.7
unnamed: J_P1.2, PROG.1
unnamed: J_R8.1, R.8
unnamed: R23.2, T2.B
unnamed: LED_R.A, R20.1
unnamed: LED_B.A, R21.1
unnamed: J_L7.2, J_L7B.2, L.7
unnamed: J_L6.2, L.6, R19.1
unnamed: J_L8.2, J_L8B.2, L.8
unnamed: J_L5.2, L.5, R34.1
unnamed: J_L4.2, L.4, R35.1
unnamed: J_L2.2, L.2, R37.1
unnamed: J_L3.2, L.3, R36.1
unnamed: J_L1.2, L.1
unnamed: J_P2.2, PROG.2
OLED_SCL: IC1.15 (IO12), IC2.IO27, J_L8B.1, OLED.3, R31.2
OLED_SDA: IC1.13 (IO10), IC2.IO26, J_L7B.1, OLED.4, R30.2
S2_IO1: IC1.4 (IO1), R37.2, R38.1
S2_IO2: IC1.5 (IO2), R36.2, R39.1
S2_IO3: IC1.6 (IO3), R35.2, R40.1
S2_IO4: IC1.7 (IO4), R34.2, R41.1
S2_IO5: IC1.8 (IO5), R19.2, R42.1
S2_IO45: IC1.39 (IO45), R16.1, R17.2
S2_IO46: IC1.40 (IO46), R43.1, R44.2
SD_CLK: R3.1, R6.2, SDCARD.5 (CLK)
SD_CMD: R2.1, R7.2, SDCARD.3 (CMD)
SD_D0: IC1.24 (IO21), IC2.IO2, R4.2, SDCARD.7 (DATA0)
SD_D1: IC1.9 (IO6), J_IO4.1, R5.2, SDCARD.8 (DATA1)
SD_D2: R9.2, R15.1, SDCARD.1 (DATA2)
SD_D3: R1.1, R8.2, SDCARD.2 (CD/DATA3)
SPI_CS0: IC1.28 (IO34), IC2.IO5, J_L5.1, R13.1, R14.2, SPI.7
SPI_CS1: IC1.32 (IO38), IC2.IO25, J_L6.1, SPI.8
SPI_MISO: IC1.29 (IO35), IC2.IO23, J_L2.1, SPI.1
SPI_MOSI: IC1.31 (IO37), IC2.IO19, J_L3.1, SPI.4
SPI_ON: IC1.27 (IO33), J_RSO.2
SPI_RESET: IC1.11 (IO8), J_BR.3, J_L7.1, J_RSO.1, SPI.5
SPI_SCK: IC1.30 (IO36), IC2.IO18, J_L4.1, SPI.3
U0RXD: IC1.38 (RXD0), IC2.RXD0, J_P1.3, J_U02R.1
U0TXD: IC1.37 (TXD0), IC2.TXD0, J_P2.3, J_U02T.1
U1RXD: GPS.1, IC1.21 (IO18), IC2.IO34, R22.1
U1TXD: GPS.3, IC1.20 (IO17), IC2.IO32
U2RXD: IC1.12 (IO9), IC2.IO35, J_U02R.2, R33.2
U2TXD: D1.C, IC1.10 (IO7), IC2.IO33, J_U02T.2
U2_BUS: D1.A, J_L1.1, R32.1, R33.1
U5: I2C.4, R.4
U33A: J_VCC.3, J_VCCOUT.2, R.2
U33B: J_VCC.1, R.3
UBAT: I2C.6, R.5
UBUS: GPS.5, I2C.2, J_VCCOUT.1, Q2.3 (D), SPI.2
USBN: C4.1, IC1.22 (IO19), J_P1.1
USBP: C3.1, IC1.23 (IO20), J_P2.1
VCC: C2.1, C5.+, C6.+, IC1.2 (3V3), IC2.VDD33 (3V3), J_OLED1.3, J_OLED2.3, J_VCC.2, PROG.3, Q2.2 (S), R5.1, R6.1, R7.1, R8.1, R9.1, R10.2, R11.2, R12.2, R13.2, R16.2, R18.2, R22.2, R25.1, R26.1, R27.1, R28.1, R29.1, R30.1, R31.1, R32.2, R43.2, R45.1, SDCARD.4 (VDD)

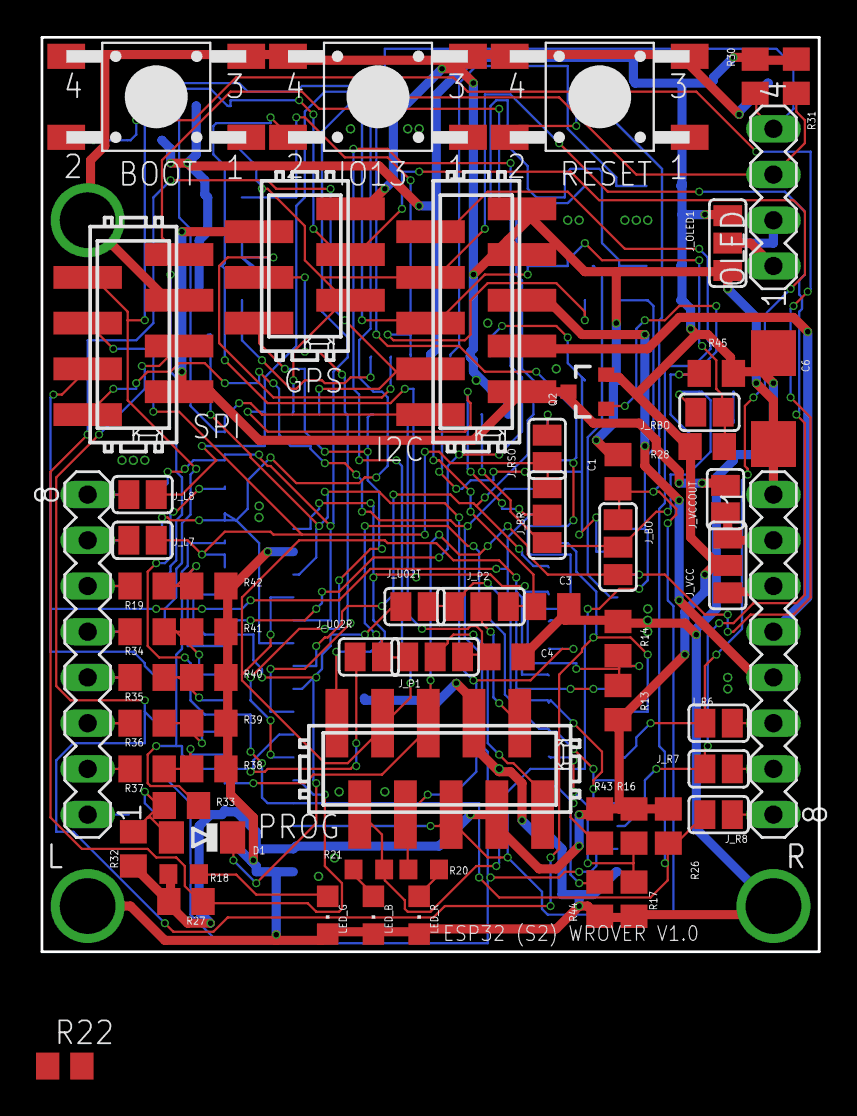
[picture p57: board esp32_module.brd from above]

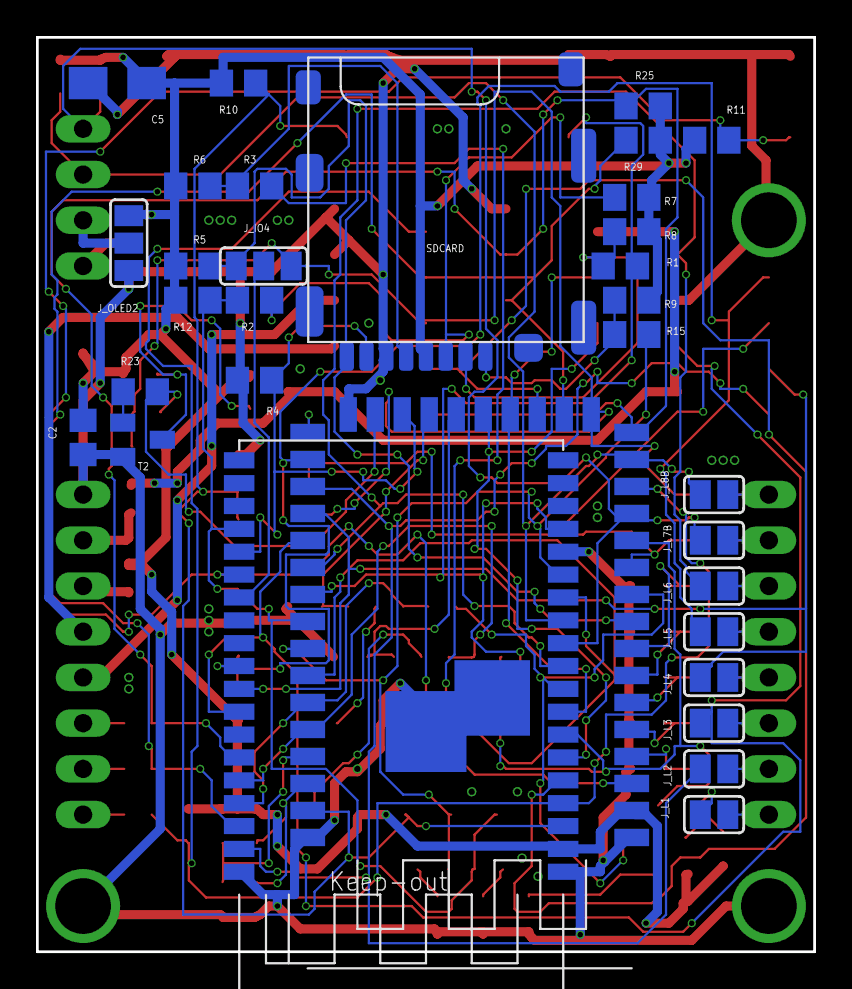
[picture p58: board esp32_module.brd from below]

Board: 2 copper layers, 43.2 x 50.8 mm, 95 parts (32 on the bottom side), 71 nets.
