MS71/ROS2Mower/hw/rpi_pwrspl.brd

## EAGLE design hw/rpi_pwrspl.brd (2021-02-19)

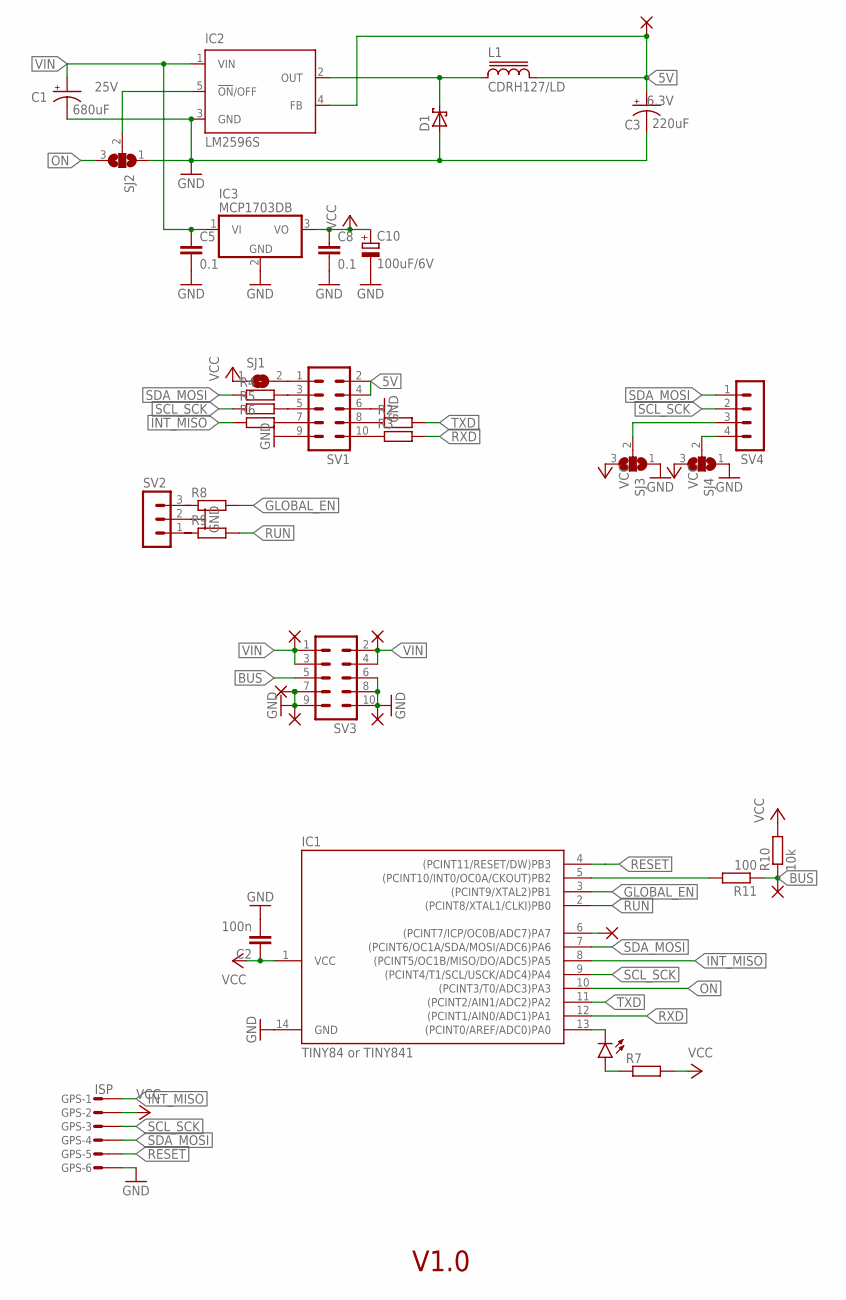
[picture p59: schematic rpi_pwrspl.sch, sheet 1]

Parts:
C1: 680uF; E5-10,5; VOLTAGE 25V
C2: 100n; C0805
C3: 220uF; UD-6,3X5,8_NICHICON; VOLTAGE 6.3V
C5, C8: 0.1; C0805
C10: 100uF/6V; B/3528-21R
D1: SCHOTTKY-DIODESMD; SMB
GPS: ISP; MICROMATCH-6SMD
IC1: TINY84 or TINY841; SOIC14
IC2: LM2596S; TO263-5
IC3: MCP1703DB; SOT223
L1: CDRH127/LD
LED: LEDCHIPLED_0805; CHIPLED_0805
PAD1, PAD2, PAD3, PAD6, PAD7: 1,6/0,9
PAD4, PAD5, PAD8: 2,54/1,1
R2, R3, R4, R5, R6, R8, R9: R-EU_M0805; M0805
R7: 100; R0603
R10: 10k; M0805
R11: 100; M0805
SJ1: SJ
SJ2, SJ3, SJ4: SJ2W; SJ_2
SV1, SV3: MA05-2
SV2: MA03-1
SV4: MA04-1

Connections:
5V: C3.+, IC2.4 (FB), L1.2, PAD6.1, SV1.2, SV1.4
BUS: PAD5.1, R10.1, R11.1, SV3.5
GLOBAL_EN: IC1.3 ((PCINT9/XTAL2)PB1), R8.2
GND: C1.-, C2.2, C3.-, C5.2, C8.2, C10.-, D1.A, GPS.6, IC1.14 (GND), IC2.3 (GND), IC3.2 (GND), PAD2.1, PAD3.1, PAD8.1, SJ2.1, SJ3.1, SJ4.1, SV1.6, SV1.9, SV2.2, SV3.6, SV3.7, SV3.8, SV3.9, SV3.10
INT_MISO: GPS.1, IC1.8 ((PCINT5/OC1B/MISO/DO/ADC5)PA5), R6.1
unnamed: SJ1.2, SV1.1
unnamed: R2.1, SV1.8
unnamed: R3.1, SV1.10
unnamed: R4.2, SV1.3
unnamed: LED.A, R7.1
unnamed: R5.2, SV1.5
unnamed: R6.2, SV1.7
unnamed: IC2.5 (!ON!/OFF), SJ2.2
unnamed: SJ4.2, SV4.4
unnamed: SJ3.2, SV4.3
unnamed: IC1.6 ((PCINT7/ICP/OC0B/ADC7)PA7), PAD7.1
unnamed: IC1.5 ((PCINT10/INT0/OC0A/CKOUT)PB2), R11.2
ON: IC1.10 ((PCINT3/T0/ADC3)PA3), SJ2.3
OUT: D1.C, IC2.2 (OUT), L1.1
PA0: IC1.13 ((PCINT0/AREF/ADC0)PA0), LED.C
RESET: GPS.5, IC1.4 ((PCINT11/RESET/DW)PB3)
RUN: IC1.2 ((PCINT8/XTAL1/CLKI)PB0), R9.2
RXD: IC1.12 ((PCINT1/AIN0/ADC1)PA1), R3.2
SCL_SCK: GPS.3, IC1.9 ((PCINT4/T1/SCL/USCK/ADC4)PA4), R5.1, SV4.2
SDA_MOSI: GPS.4, IC1.7 ((PCINT6/OC1A/SDA/MOSI/ADC6)PA6), R4.1, SV4.1
TXD: IC1.11 ((PCINT2/AIN1/ADC2)PA2), R2.2
VCC: C2.1, C8.1, C10.+, GPS.2, IC1.1 (VCC), IC3.3 (VO), R7.2, R10.2, SJ1.1, SJ3.3, SJ4.3
VIN: C1.+, C5.1, IC2.1 (VIN), IC3.1 (VI), PAD1.1, PAD4.1, SV3.1, SV3.2, SV3.3, SV3.4

Notes on the sheet:
V1.0

Board: 2 copper layers, 39 parts (5 on the bottom side), 28 nets, no tracks yet.
