MS71/ROS2Mower/hw/rpi_pwrspl_02.brd

## EAGLE design hw/rpi_pwrspl_02.brd (2021-02-19)

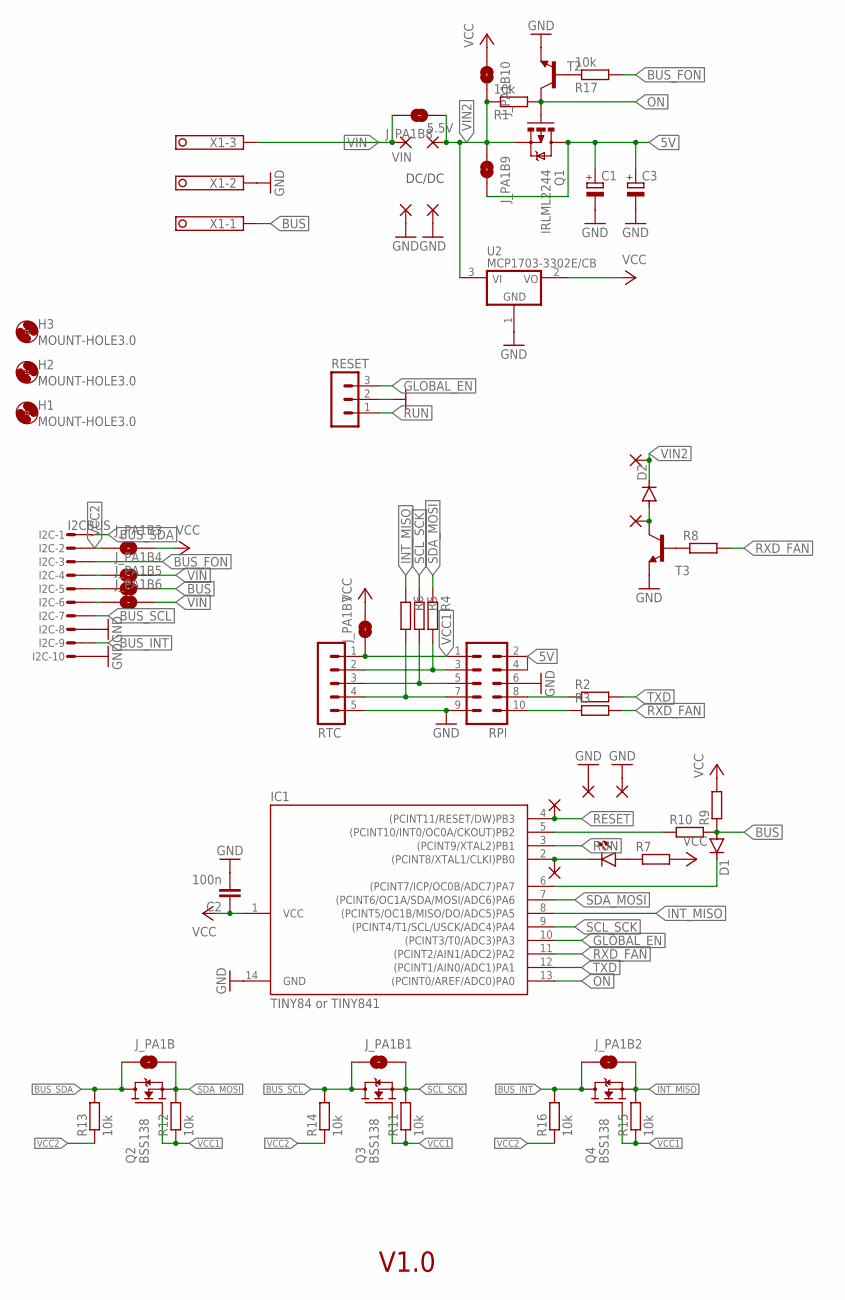
[picture p60: schematic rpi_pwrspl_02.sch, sheet 1]

Parts:
5.5V: 2,54/1,0
C1: CPOL-EUE5-5; E5-5
C2: 100n; C0805
C3: CPOL-EU085CS-1AR; 085CS_1AR
D1, D2: DIODE-MINIMELF; MINIMELF
DW, DW1, DW2, DW3, DW4, DW5: 1,6/0,9
H1, H2, H3: MOUNT-HOLE3.0; 3,0
I2C: I2CBUS; MICROMATCH-10SMD
IC1: TINY84 or TINY841; SOIC14
J_PA1B, J_PA1B1, J_PA1B2, J_PA1B3, J_PA1B4, J_PA1B5, J_PA1B6, J_PA1B7, J_PA1B8, J_PA1B9, J_PA1B10: JUMPER-SMT_2_NO_NO-SILK; SMT-JUMPER_2_NO_NO-SILK
LED: LEDCHIPLED_0805; CHIPLED_0805
PAD1, PAD2: 2,54/1,0
Q1: IRLML2244; SOT23-3
Q2, Q3, Q4: BSS138; SOT23
R1, R11, R12, R13, R14, R15, R16, R17: 10k; R0805
R2, R3, R4, R5, R6, R8, R9, R10: R-EU_M0805; M0805
R7: 100; R0603
RESET: MA03-1
RPI: MA05-2
RTC: MA05-1
T2, T3: BC817-16-NPN-SOT23-BEC; SOT23-BEC
U2: MCP1703-3302E/CB; SOT23A_MICROCHIP_CB
VIN: 2,54/1,0
X1: 1751251

Connections:
5V: C1.+, C3.+, J_PA1B9.2, Q1.3 (D), RPI.2, RPI.4
BUS: D1.A, J_PA1B5.2, R9.1, R10.2, X1.1
BUS_FON: I2C.3, R17.2
BUS_INT: I2C.9, J_PA1B2.1, Q4.3 (D), R16.2
BUS_SCL: I2C.7, J_PA1B1.1, Q3.3 (D), R14.2
BUS_SDA: I2C.1, J_PA1B.1, Q2.3 (D), R13.2
GLOBAL_EN: IC1.10 ((PCINT3/T0/ADC3)PA3), RESET.3
GND: C1.-, C2.2, C3.-, DW2.1, DW3.1, I2C.8, I2C.10, IC1.14 (GND), PAD1.1, PAD2.1, RESET.2, RPI.6, RPI.9, RTC.5, T2.E, T3.E, U2.1 (GND), X1.2
INT_MISO: IC1.8 ((PCINT5/OC1B/MISO/DO/ADC5)PA5), J_PA1B2.2, Q4.2 (S), R6.1, R15.2
unnamed: I2C.4, J_PA1B4.1
unnamed: R4.2, RPI.3, RTC.2
unnamed: R2.1, RPI.8
unnamed: R3.1, RPI.10
unnamed: R5.2, RPI.5, RTC.3
unnamed: LED.A, R7.1
unnamed: R6.2, RPI.7, RTC.4
unnamed: D2.A, DW4.1, T3.C
unnamed: IC1.5 ((PCINT10/INT0/OC0A/CKOUT)PB2), R10.1
unnamed: D1.C, IC1.6 ((PCINT7/ICP/OC0B/ADC7)PA7)
unnamed: DW1.1, IC1.2 ((PCINT8/XTAL1/CLKI)PB0), LED.C
unnamed: R8.1, T3.B
unnamed: R17.1, T2.B
unnamed: I2C.6, J_PA1B6.1
unnamed: I2C.5, J_PA1B5.1
ON: IC1.13 ((PCINT0/AREF/ADC0)PA0), Q1.1 (G), R1.2, T2.C
RESET: DW.1, IC1.4 ((PCINT11/RESET/DW)PB3)
RUN: IC1.3 ((PCINT9/XTAL2)PB1), RESET.1
RXD_FAN: IC1.11 ((PCINT2/AIN1/ADC2)PA2), R3.2, R8.2
SCL_SCK: IC1.9 ((PCINT4/T1/SCL/USCK/ADC4)PA4), J_PA1B1.2, Q3.2 (S), R5.1, R11.2
SDA_MOSI: IC1.7 ((PCINT6/OC1A/SDA/MOSI/ADC6)PA6), J_PA1B.2, Q2.2 (S), R4.1, R12.2
TXD: IC1.12 ((PCINT1/AIN0/ADC1)PA1), R2.2
VCC: C2.1, IC1.1 (VCC), J_PA1B3.2, J_PA1B7.2, J_PA1B10.1, R7.2, R9.2, U2.2 (VO)
VCC1: J_PA1B7.1, Q2.1 (G), Q3.1 (G), Q4.1 (G), R11.1, R12.1, R15.1, RPI.1, RTC.1
VCC2: I2C.2, J_PA1B3.1, R13.1, R14.1, R16.1
VIN: J_PA1B4.2, J_PA1B6.2, J_PA1B8.2, VIN.1, X1.3
VIN2: 5.5V.1, D2.C, DW5.1, J_PA1B8.1, J_PA1B9.1, J_PA1B10.2, Q1.2 (S), R1.1, U2.3 (VI)

Notes on the sheet:
V1.0
DC/DC

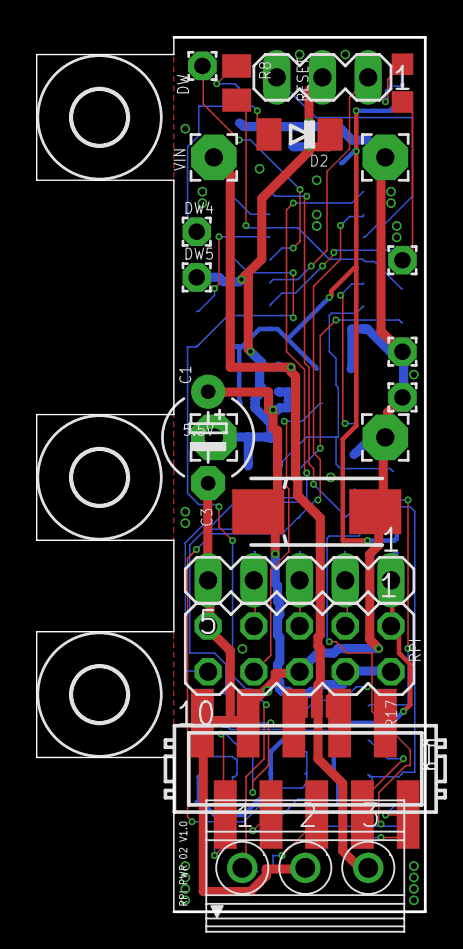
[picture p61: board rpi_pwrspl_02.brd from above]

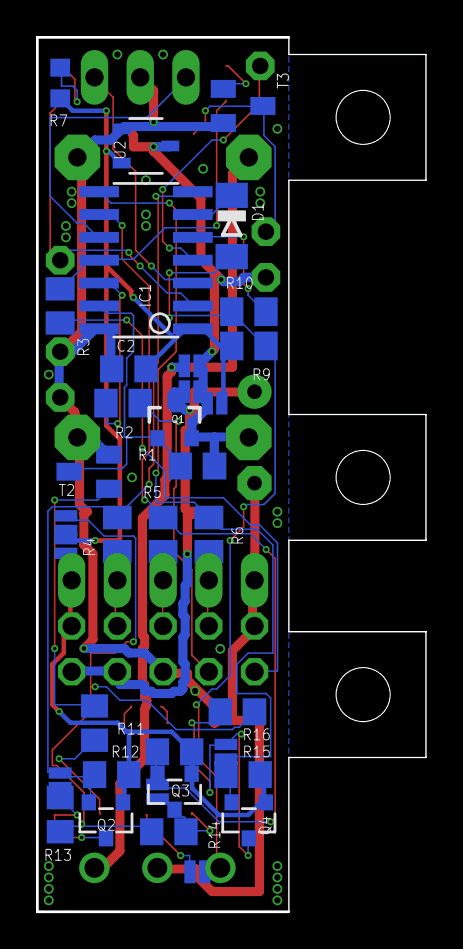
[picture p62: board rpi_pwrspl_02.brd from below]

Board: 2 copper layers, 21.6 x 48.6 mm, 60 parts (35 on the bottom side), 36 nets.
