MS71/ROS2Mower/hw/motor_node.brd

## EAGLE design hw/motor_node.brd (2020-08-27)

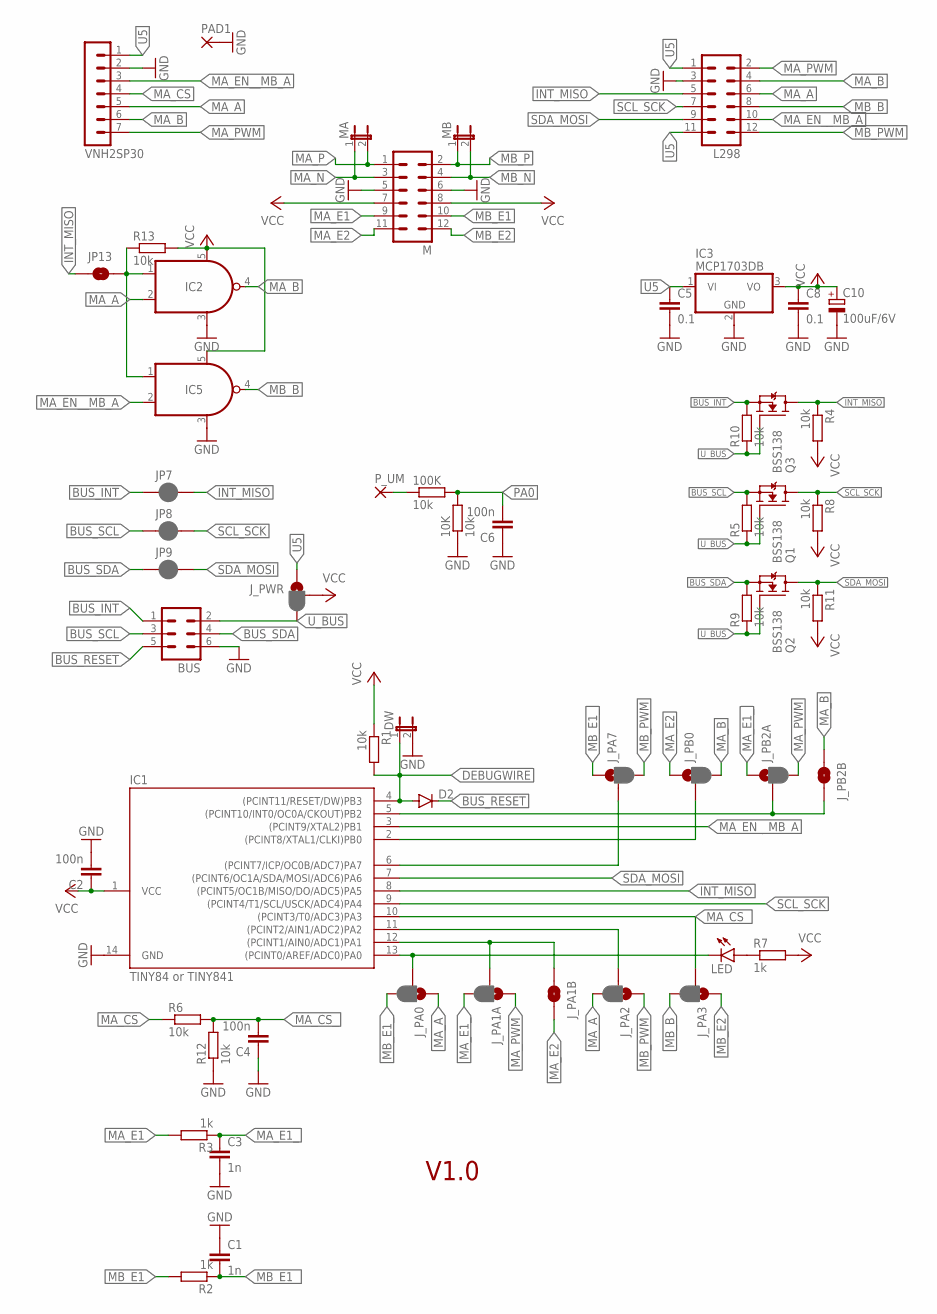
[picture p63: schematic motor_node.sch, sheet 1]

Parts:
10K, 100K: 10k; M0805
BUS: ML6
C1, C3: 1n; C0805
C2, C4, C6: 100n; C0805
C5, C8: 0.1; C0805
C10: 100uF/6V; B/3528-21R
D2: DIODE-MINIMELF; MINIMELF
DW: JP1E; JP1
IC1: TINY84 or TINY841; SOIC14
IC2, IC5: AHC00-DB; SOT-23/5
IC3: MCP1703DB; SOT223
JP7, JP8, JP9: JUMPER-SMT_2_NC_PASTE_NO-SILK; SMT-JUMPER_2_NC_PASTE_NO-SILK
JP13: JUMPER-SMT_2_NO_NO-SILK; SMT-JUMPER_2_NO_NO-SILK
J_PA0, J_PA1A, J_PA2, J_PA3, J_PA7: JUMPER-SMT_3_1-NC_PASTE_NO-SILK; SMT-JUMPER_3_1-NC_PASTE_NO-SILK
J_PA1B: JUMPER-SMT_2_NO_NO-SILK; SMT-JUMPER_2_NO_NO-SILK
J_PB0, J_PB2A: JUMPER-SMT_3_1-NC_PASTE_NO-SILK; SMT-JUMPER_3_1-NC_PASTE_NO-SILK
J_PB2B: JUMPER-SMT_2_NO_NO-SILK; SMT-JUMPER_2_NO_NO-SILK
J_PWR: JUMPER-SMT_3_1-NC_PASTE_NO-SILK; SMT-JUMPER_3_1-NC_PASTE_NO-SILK
L298: MA06-2
LED: LEDCHIPLED_0805; CHIPLED_0805
M: MA06-2
MA: JP1E; JP1
MB: JP1E; JP1
PAD1: 2,54/0,8
P_UM: 1,6/0,8
Q1, Q2, Q3: BSS138; SOT23
R1, R4, R6, R8, R11, R12: 10k; M0805
R2, R3: 1k; M0805
R5, R9, R10, R13: 10k; R0805
R7: 1k; R0603
VNH2SP30: MA07-1

Connections:
BUS_INT: BUS.1, JP7.1, Q3.2 (S), R10.2
BUS_RESET: BUS.5, D2.C
BUS_SCL: BUS.3, JP8.1, Q1.2 (S), R5.2
BUS_SDA: BUS.4, JP9.1, Q2.2 (S), R9.2
DEBUGWIRE: D2.A, DW.1, IC1.4 ((PCINT11/RESET/DW)PB3), R1.2
GND: 10K.1, BUS.6, C1.1, C2.2, C3.2, C4.1, C5.2, C6.1, C8.2, C10.-, DW.2, IC1.14 (GND), IC2.3 (GND), IC3.2 (GND), IC5.3 (GND), L298.3, M.5, M.6, PAD1.1, R12.1, VNH2SP30.2
INT_MISO: IC1.8 ((PCINT5/OC1B/MISO/DO/ADC5)PA5), JP7.2, JP13.1, L298.5, Q3.3 (D), R4.1
MA_A: IC2.2 (I1), J_PA0.1, J_PA2.3, L298.6, VNH2SP30.5
MA_B: IC2.4 (O), J_PB0.3, J_PB2B.1, L298.4, VNH2SP30.6
MA_CS: R6.1, VNH2SP30.4
MA_CS_: C4.2, IC1.10 ((PCINT3/T0/ADC3)PA3), J_PA3.2, R6.2, R12.2
MA_E1: M.9, R3.2
MA_E1_: C3.1, J_PA1A.3, J_PB2A.1, R3.1
MA_E2: J_PA1B.2, J_PB0.1, M.11
MA_EN__MB_A: IC1.3 ((PCINT9/XTAL2)PB1), IC5.2 (I1), L298.10, VNH2SP30.3
MA_N: M.3, MA.1
MA_P: M.1, MA.2
MA_PWM: J_PA1A.1, J_PB2A.3, L298.2, VNH2SP30.7
MB_B: IC5.4 (O), J_PA3.3, L298.8
MB_E1: M.10, R2.2
MB_E1_: C1.2, J_PA0.3, J_PA7.1, R2.1
MB_E2: J_PA3.1, M.12
MB_N: M.4, MB.2
MB_P: M.2, MB.1
MB_PWM: J_PA2.1, J_PA7.3, L298.12
unnamed: 100K.1, P_UM.1
unnamed: IC2.1 (I0), IC5.1 (I0), JP13.2, R13.1
unnamed: LED.A, R7.1
PA0: 10K.2, 100K.2, C6.2, IC1.13 ((PCINT0/AREF/ADC0)PA0), J_PA0.2, LED.C
PA1: IC1.12 ((PCINT1/AIN0/ADC1)PA1), J_PA1A.2, J_PA1B.1
PA2: IC1.11 ((PCINT2/AIN1/ADC2)PA2), J_PA2.2
PA7: IC1.6 ((PCINT7/ICP/OC0B/ADC7)PA7), J_PA7.2
PB0: IC1.2 ((PCINT8/XTAL1/CLKI)PB0), J_PB0.2
PB2: IC1.5 ((PCINT10/INT0/OC0A/CKOUT)PB2), J_PB2A.2, J_PB2B.2
SCL_SCK: IC1.9 ((PCINT4/T1/SCL/USCK/ADC4)PA4), JP8.2, L298.7, Q1.3 (D), R8.1
SDA_MOSI: IC1.7 ((PCINT6/OC1A/SDA/MOSI/ADC6)PA6), JP9.2, L298.9, Q2.3 (D), R11.1
U5: C5.1, IC3.1 (VI), J_PWR.1, L298.1, L298.11, VNH2SP30.1
U_BUS: BUS.2, J_PWR.3, Q1.1 (G), Q2.1 (G), Q3.1 (G), R5.1, R9.1, R10.1
VCC: C2.1, C8.1, C10.+, IC1.1 (VCC), IC2.5 (VDD), IC3.3 (VO), IC5.5 (VDD), J_PWR.2, M.7, M.8, R1.1, R4.2, R7.2, R8.2, R11.2, R13.2

Notes on the sheet:
V1.0

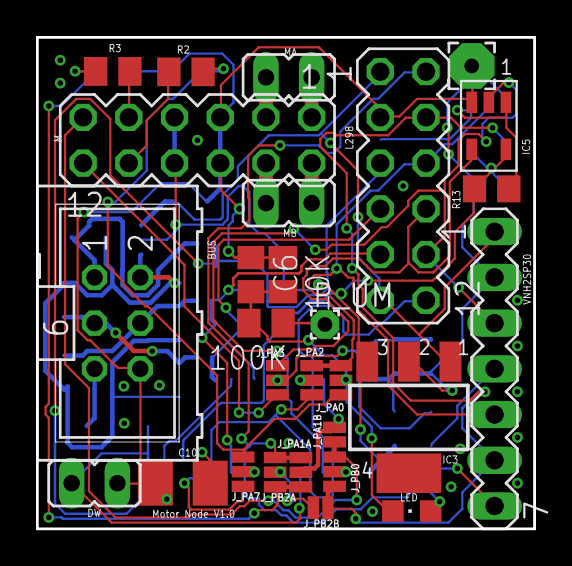
[picture p64: board motor_node.brd from above]

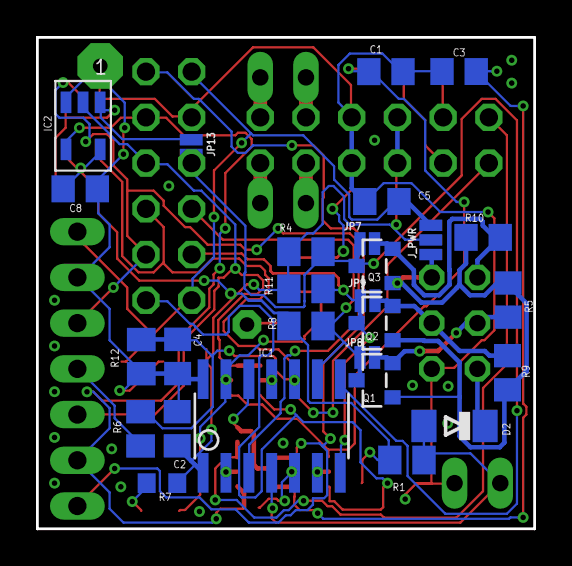
[picture p65: board motor_node.brd from below]

Board: 2 copper layers, 27.6 x 27.3 mm, 55 parts (27 on the bottom side), 39 nets.
