MS71/ROS2Mower/hw/rf_node.brd

## EAGLE design hw/rf_node.brd (2020-08-21)

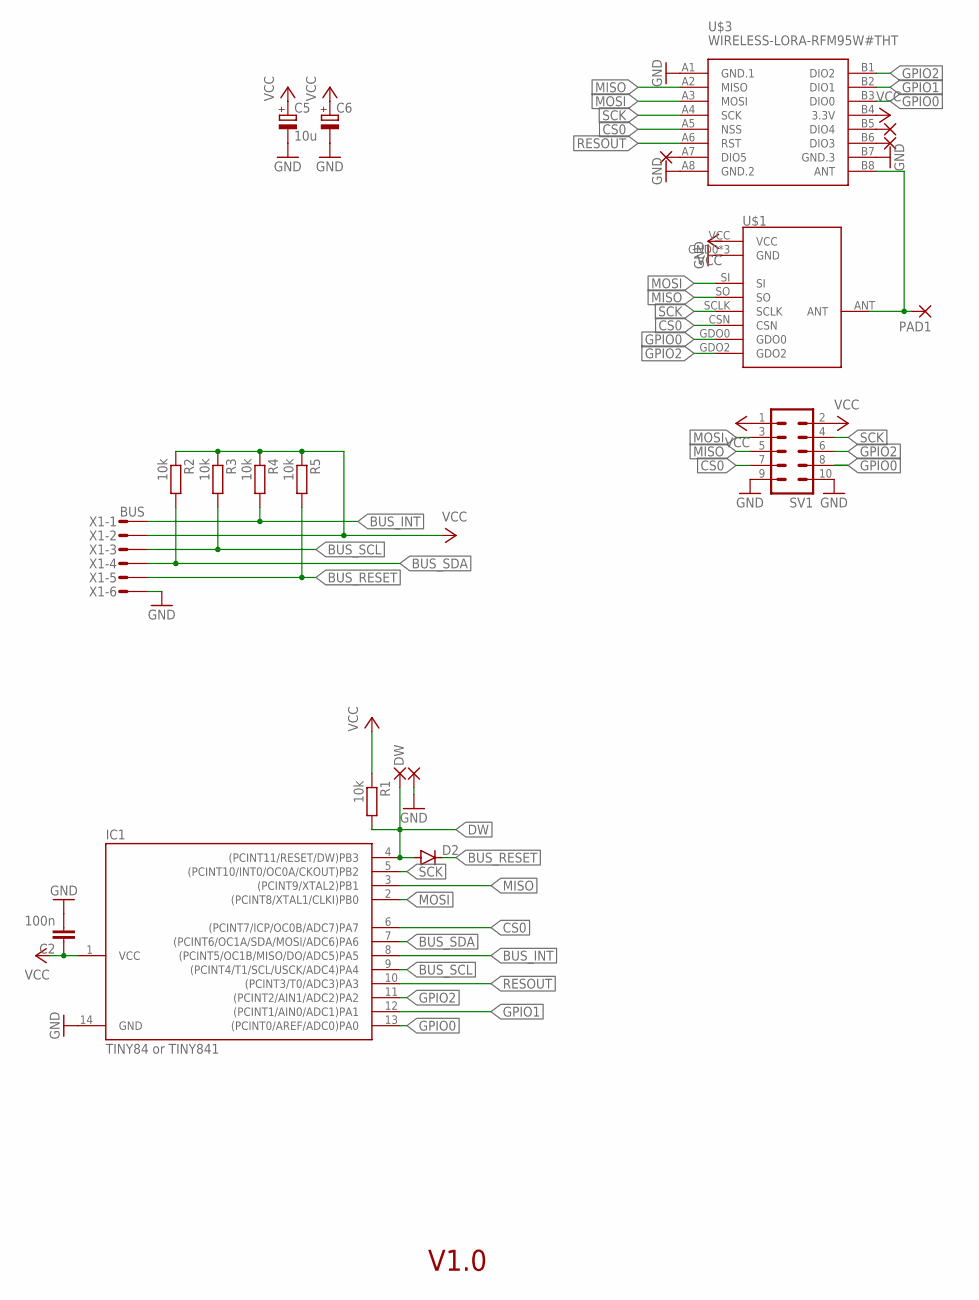
[picture p66: schematic rf_node.sch, sheet 1]

Parts:
C2: 100n; C0805
C5: 10u; B/3528-21W
C6: CPOL-EUC/6032-28R; C/6032-28R
D2: DIODE-MINIMELF; MINIMELF
DW: 1,6/0,9
GND_: 1,6/0,9
IC1: TINY84 or TINY841; SOIC14
PAD1, PAD2, PAD3, PAD4: 1,6/0,8
R1, R2, R3, R4, R5: 10k; M0805
SV1: MA05-2
U$1: CC1101
U$3: WIRELESS-LORA-RFM95W#THT
X1: BUS; MICROMATCH-6

Connections:
BUS_INT: IC1.8 ((PCINT5/OC1B/MISO/DO/ADC5)PA5), R4.2, X1.1
BUS_RESET: D2.C, R5.2, X1.5
BUS_SCL: IC1.9 ((PCINT4/T1/SCL/USCK/ADC4)PA4), R3.2, X1.3
BUS_SDA: IC1.7 ((PCINT6/OC1A/SDA/MOSI/ADC6)PA6), R2.2, X1.4
CS0: IC1.6 ((PCINT7/ICP/OC0B/ADC7)PA7), SV1.7, U$1.CSN, U$3.A5 (NSS)
DW: D2.A, DW.1, IC1.4 ((PCINT11/RESET/DW)PB3), R1.2
GND: C2.2, C5.-, C6.-, GND_.1, IC1.14 (GND), SV1.9, SV1.10, U$1.GND0 (GND), U$1.GND1 (GND), U$1.GND2 (GND), U$3.A1 (GND.1), U$3.A8 (GND.2), U$3.B7 (GND.3), X1.6
GPIO0: IC1.13 ((PCINT0/AREF/ADC0)PA0), SV1.8, U$1.GDO0, U$3.B3 (DIO0)
GPIO1: IC1.12 ((PCINT1/AIN0/ADC1)PA1), U$3.B2 (DIO1)
GPIO2: IC1.11 ((PCINT2/AIN1/ADC2)PA2), SV1.6, U$1.GDO2, U$3.B1 (DIO2)
MISO: IC1.3 ((PCINT9/XTAL2)PB1), SV1.5, U$1.SO, U$3.A2 (MISO)
MOSI: IC1.2 ((PCINT8/XTAL1/CLKI)PB0), SV1.3, U$1.SI, U$3.A3 (MOSI)
unnamed: PAD1.1, U$1.ANT, U$3.B8 (ANT)
unnamed: PAD2.1, U$3.B6 (DIO3)
unnamed: PAD3.1, U$3.B5 (DIO4)
unnamed: PAD4.1, U$3.A7 (DIO5)
RESOUT: IC1.10 ((PCINT3/T0/ADC3)PA3), U$3.A6 (RST)
SCK: IC1.5 ((PCINT10/INT0/OC0A/CKOUT)PB2), SV1.4, U$1.SCLK, U$3.A4 (SCK)
VCC: C2.1, C5.+, C6.+, IC1.1 (VCC), R1.1, R2.1, R3.1, R4.1, R5.1, SV1.1, SV1.2, U$1.VCC, U$3.B4 (3.3V), X1.2

Notes on the sheet:
V1.0

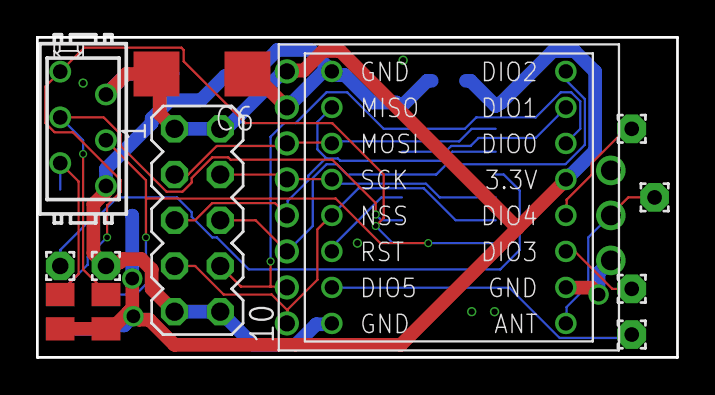
[picture p67: board rf_node.brd from above]

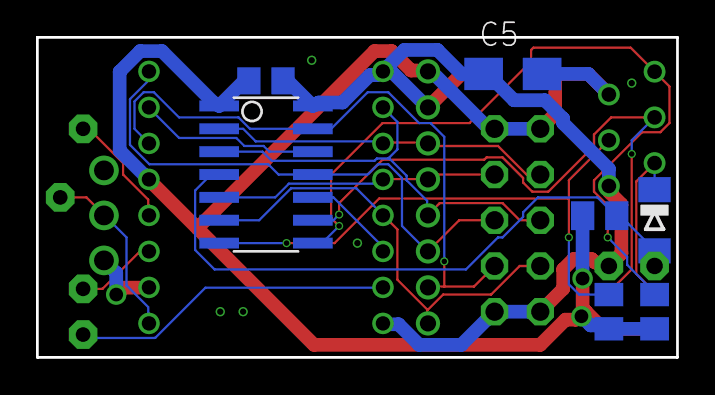
[picture p68: board rf_node.brd from below]

Board: 2 copper layers, 35.6 x 17.8 mm, 20 parts (7 on the bottom side), 19 nets.
