MS71/ROS2Mower/hw/uni_node.brd

## EAGLE design hw/uni_node.brd (2020-08-21)

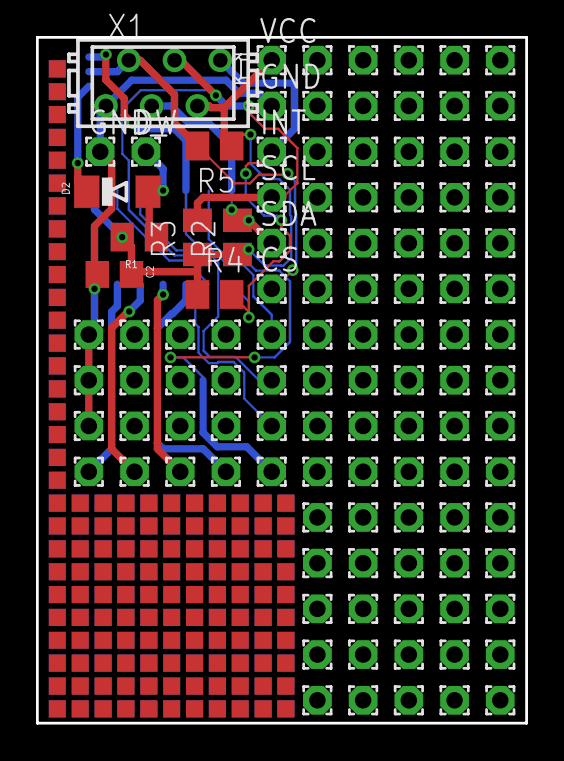
[picture p69: board uni_node.brd from above]

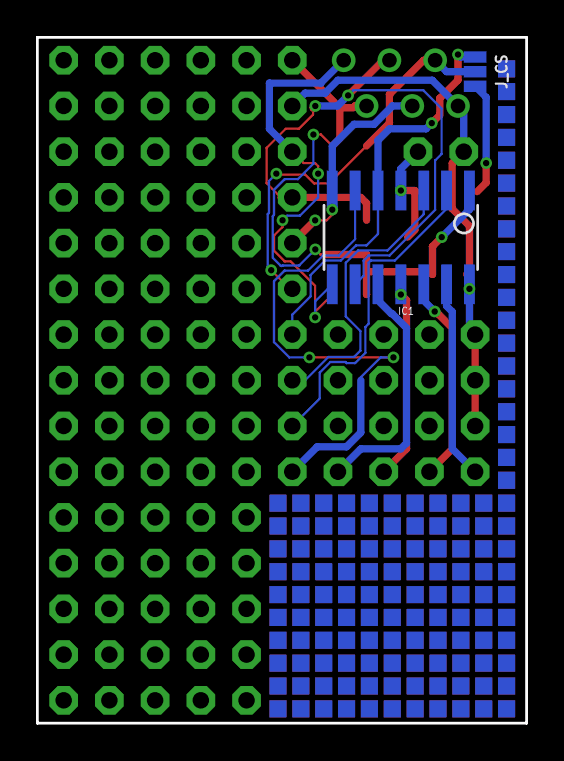
[picture p70: board uni_node.brd from below]

Board: 2 copper layers, 27.2 x 38.1 mm, 113 parts (2 on the bottom side), 16 nets.

Parts:
C2: 100n; C0805
CS: 1,6/0,9
D2: MINIMELF
DW: 1,6/0,9
GND: 1,6/0,9
GND_: 1,6/0,9
IC1: TINY84 or TINY841; SOIC14
INT, INT0: 1,6/0,9
J_CS: SMT-JUMPER_3_1-NC_PASTE_NO-SILK
PA0, PA1, PA2, PA3, PA7: 1,6/0,9
PAD1, PAD2, PAD3, PAD4, PAD5, PAD7, PAD8, PAD10, PAD11, PAD12, PAD13, PAD14, PAD15, PAD16, PAD18, PAD19, PAD20, PAD21, PAD22, PAD24, PAD25, PAD26, PAD28, PAD29, PAD30, PAD31, PAD33, PAD34, PAD35, PAD36, PAD37, PAD38, PAD39, PAD40, PAD43, PAD44, PAD45, PAD46, PAD47, PAD48, PAD49, PAD50, PAD51, PAD52, PAD53, PAD54, PAD55, PAD56, PAD57, PAD59, PAD60, PAD61, PAD62, PAD65, PAD66, PAD67, PAD68, PAD69, PAD70, PAD71, PAD72, PAD74, PAD75, PAD76, PAD78, PAD79, PAD80, PAD81, PAD82, PAD83, PAD84, PAD85, PAD86, PAD87, PAD89, PAD90, PAD91, PAD93, PAD94, PAD95, PAD96, PAD97, PAD98, PAD99, PAD100, PAD101, PAD102: 1,6/0,9
PB0, PB1: 1,6/0,9
R1, R2, R3, R4, R5: 10k; M0805
SCL: 1,6/0,9
SDA: 1,6/0,9
VCC: 1,6/0,9
X1: BUS; MICROMATCH-6

Connections:
BUS_INT: IC1.8, INT.1, R4.2, X1.1
BUS_P5: CS.1, J_CS.2, R5.2, X1.5
BUS_RESET: D2.C, J_CS.3
BUS_SCL: IC1.9, R3.2, SCL.1, X1.3
BUS_SDA: IC1.7, R2.2, SDA.1, X1.4
DW: D2.A, DW.1, IC1.4, R1.2
GND: C2.2, GND.1, GND_.1, IC1.14, PAD100.1, PAD101.1, PAD102.1, X1.6
INT0: IC1.5, INT0.1, J_CS.1
PA0: IC1.13, PA0.1
PA1: IC1.12, PA1.1
PA2: IC1.11, PA2.1
PA3: IC1.10, PA3.1
PA7: IC1.6, PA7.1
PB0: IC1.2, PB0.1
PB1: IC1.3, PB1.1
VCC: C2.1, IC1.1, R1.1, R2.1, R3.1, R4.1, R5.1, VCC.1, X1.2
