MS71/ROS2Mower/hw/nutzen_03.brd

## EAGLE design hw/nutzen_03.brd (2020-08-21)

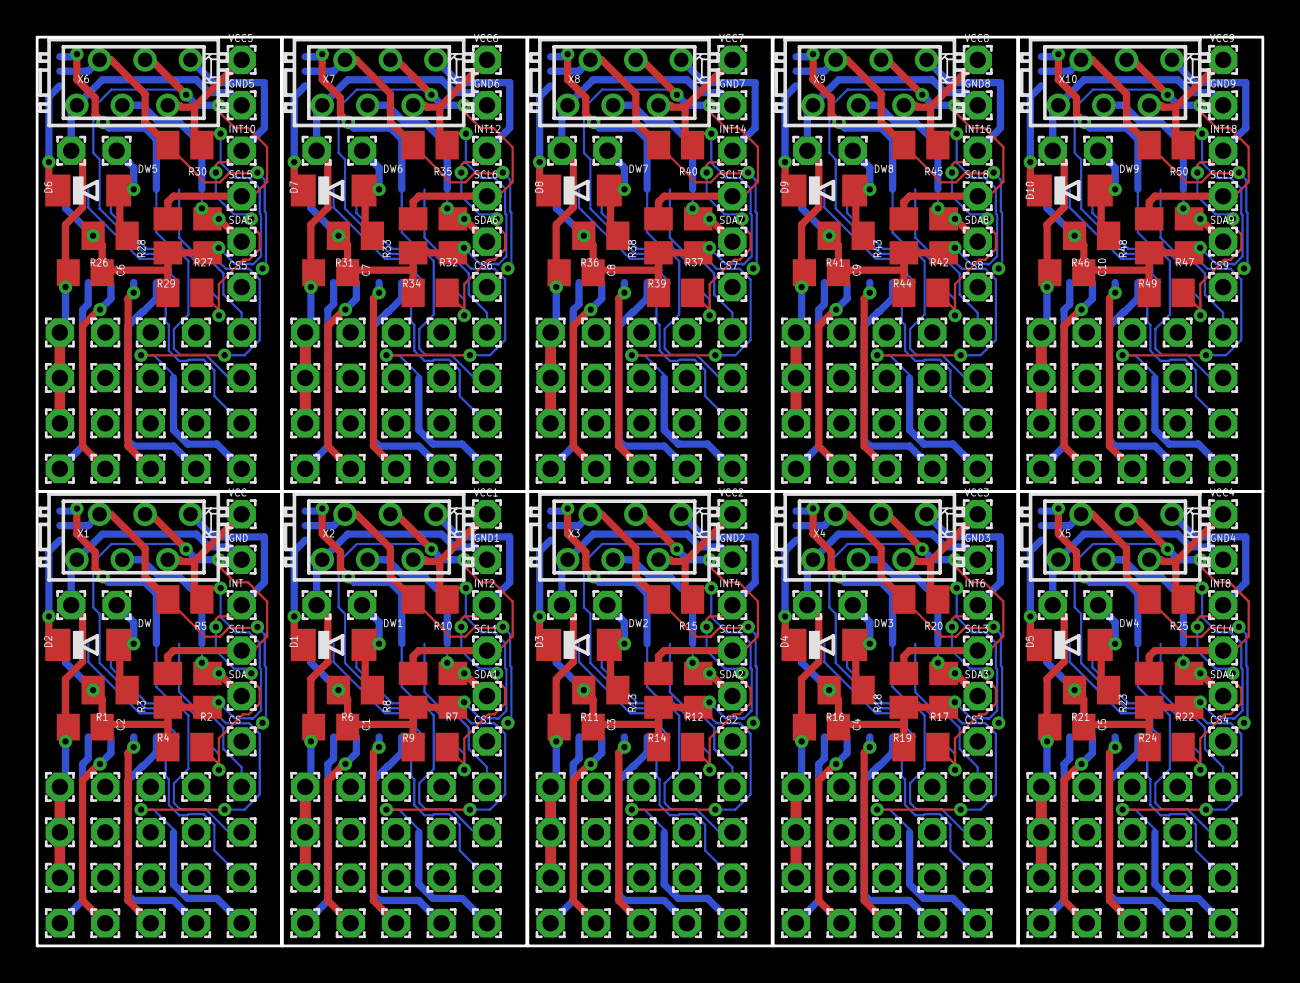
[picture p71: board nutzen_03.brd from above]

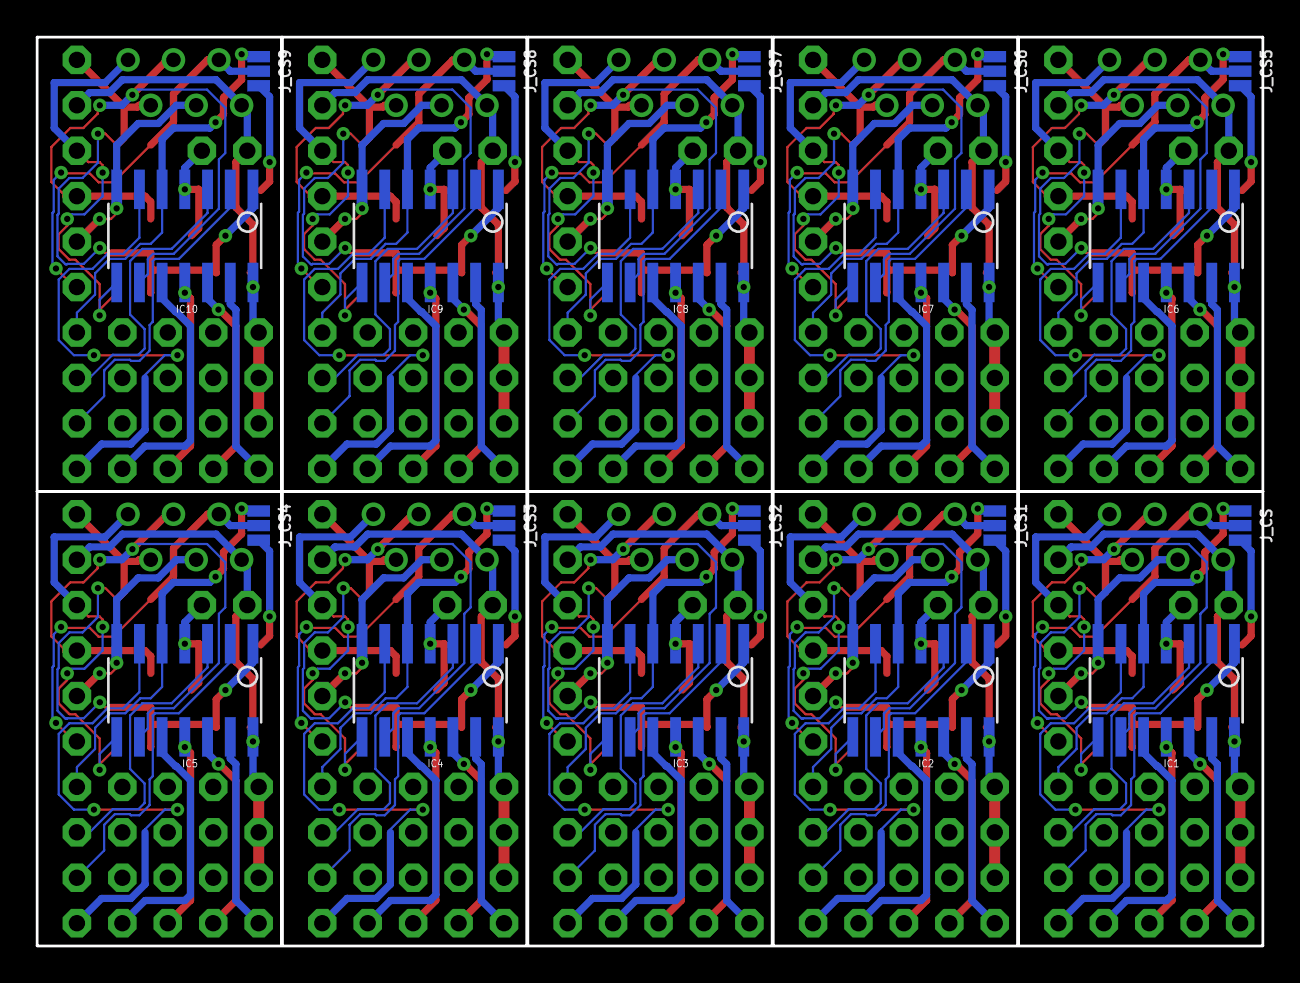
[picture p72: board nutzen_03.brd from below]

Board: 2 copper layers, 68.5 x 50.8 mm, 380 parts (20 on the bottom side), 160 nets.

Parts:
C1, C2, C3, C4, C5, C6, C7, C8, C9, C10: 100n; C0805
CS, CS1, CS2, CS3, CS4, CS5, CS6, CS7, CS8, CS9: 1,6/0,9
D1, D2, D3, D4, D5, D6, D7, D8, D9, D10: MINIMELF
DW, DW1, DW2, DW3, DW4, DW5, DW6, DW7, DW8, DW9: 1,6/0,9
GND, GND1, GND2, GND3, GND4, GND5, GND6, GND7, GND8, GND9: 1,6/0,9
GND_, GND_1, GND_2, GND_3, GND_4, GND_5, GND_6, GND_7, GND_8, GND_9: 1,6/0,9
IC1, IC2, IC3, IC4, IC5, IC6, IC7, IC8, IC9, IC10: TINY84 or TINY841; SOIC14
INT, INT0, INT1, INT2, INT3, INT4, INT5, INT6, INT7, INT8, INT9, INT10, INT11, INT12, INT13, INT14, INT15, INT16, INT17, INT18: 1,6/0,9
J_CS, J_CS1, J_CS2, J_CS3, J_CS4, J_CS5, J_CS6, J_CS7, J_CS8, J_CS9: SMT-JUMPER_3_1-NC_PASTE_NO-SILK
PA0, PA1, PA2, PA3, PA4, PA5, PA6, PA7, PA8, PA9, PA10, PA11, PA12, PA13, PA14, PA15, PA16, PA17, PA18, PA19, PA20, PA21, PA22, PA23, PA24, PA25, PA26, PA27, PA28, PA29, PA30, PA31, PA32, PA33, PA34, PA35, PA36, PA37, PA38, PA39, PA40, PA41, PA42, PA43, PA44, PA45, PA46, PA47, PA48, PA49: 1,6/0,9
PAD1, PAD2, PAD3, PAD4, PAD5, PAD6, PAD7, PAD8, PAD9, PAD10, PAD11, PAD12, PAD13, PAD14, PAD15, PAD16, PAD17, PAD18, PAD19, PAD20, PAD21, PAD22, PAD23, PAD24, PAD25, PAD26, PAD27, PAD28, PAD29, PAD30, PAD31, PAD32, PAD33, PAD34, PAD35, PAD36, PAD37, PAD38, PAD39, PAD40, PAD41, PAD42, PAD43, PAD44, PAD45, PAD46, PAD47, PAD48, PAD49, PAD50, PAD51, PAD52, PAD53, PAD54, PAD55, PAD56, PAD57, PAD58, PAD59, PAD60, PAD61, PAD62, PAD63, PAD64, PAD65, PAD66, PAD67, PAD68, PAD69, PAD70, PAD71, PAD72, PAD73, PAD74, PAD75, PAD76, PAD77, PAD78, PAD79, PAD80, PAD81, PAD82, PAD83, PAD84, PAD85, PAD86, PAD87, PAD88, PAD89, PAD90, PAD91, PAD92, PAD93, PAD94, PAD95, PAD96, PAD97, PAD98, PAD99, PAD100, PAD101, PAD102, PAD103, PAD104, PAD105, PAD106, PAD107, PAD108, PAD109, PAD110, PAD111, PAD112, PAD113, PAD114, PAD115, PAD116, PAD117, PAD118, PAD119, PAD120: 1,6/0,9
PB0, PB1, PB2, PB3, PB4, PB5, PB6, PB7, PB8, PB9, PB10, PB11, PB12, PB13, PB14, PB15, PB16, PB17, PB18, PB19: 1,6/0,9
R1, R2, R3, R4, R5, R6, R7, R8, R9, R10, R11, R12, R13, R14, R15, R16, R17, R18, R19, R20, R21, R22, R23, R24, R25, R26, R27, R28, R29, R30, R31, R32, R33, R34, R35, R36, R37, R38, R39, R40, R41, R42, R43, R44, R45, R46, R47, R48, R49, R50: 10k; M0805
SCL, SCL1, SCL2, SCL3, SCL4, SCL5, SCL6, SCL7, SCL8, SCL9: 1,6/0,9
SDA, SDA1, SDA2, SDA3, SDA4, SDA5, SDA6, SDA7, SDA8, SDA9: 1,6/0,9
VCC, VCC1, VCC2, VCC3, VCC4, VCC5, VCC6, VCC7, VCC8, VCC9: 1,6/0,9
X1, X2, X3, X4, X5, X6, X7, X8, X9, X10: BUS; MICROMATCH-6

Connections:
BUS_INT: IC1.8, INT.1, R4.2, X1.1
BUS_INT1: IC2.8, INT2.1, R9.2, X2.1
BUS_INT2: IC3.8, INT4.1, R14.2, X3.1
BUS_INT3: IC4.8, INT6.1, R19.2, X4.1
BUS_INT4: IC5.8, INT8.1, R24.2, X5.1
BUS_INT5: IC6.8, INT10.1, R29.2, X6.1
BUS_INT6: IC7.8, INT12.1, R34.2, X7.1
BUS_INT7: IC8.8, INT14.1, R39.2, X8.1
BUS_INT8: IC9.8, INT16.1, R44.2, X9.1
BUS_INT9: IC10.8, INT18.1, R49.2, X10.1
BUS_P1: CS1.1, J_CS1.2, R10.2, X2.5
BUS_P2: CS2.1, J_CS2.2, R15.2, X3.5
BUS_P3: CS3.1, J_CS3.2, R20.2, X4.5
BUS_P4: CS4.1, J_CS4.2, R25.2, X5.5
BUS_P5: CS.1, J_CS.2, R5.2, X1.5
BUS_P6: CS5.1, J_CS5.2, R30.2, X6.5
BUS_P7: CS6.1, J_CS6.2, R35.2, X7.5
BUS_P8: CS7.1, J_CS7.2, R40.2, X8.5
BUS_P9: CS8.1, J_CS8.2, R45.2, X9.5
BUS_P10: CS9.1, J_CS9.2, R50.2, X10.5
BUS_RESET: D2.C, J_CS.3
BUS_RESET1: D1.C, J_CS1.3
BUS_RESET2: D3.C, J_CS2.3
BUS_RESET3: D4.C, J_CS3.3
BUS_RESET4: D5.C, J_CS4.3
BUS_RESET5: D6.C, J_CS5.3
BUS_RESET6: D7.C, J_CS6.3
BUS_RESET7: D8.C, J_CS7.3
BUS_RESET8: D9.C, J_CS8.3
BUS_RESET9: D10.C, J_CS9.3
BUS_SCL: IC1.9, R3.2, SCL.1, X1.3
BUS_SCL1: IC2.9, R8.2, SCL1.1, X2.3
BUS_SCL2: IC3.9, R13.2, SCL2.1, X3.3
BUS_SCL3: IC4.9, R18.2, SCL3.1, X4.3
BUS_SCL4: IC5.9, R23.2, SCL4.1, X5.3
BUS_SCL5: IC6.9, R28.2, SCL5.1, X6.3
BUS_SCL6: IC7.9, R33.2, SCL6.1, X7.3
BUS_SCL7: IC8.9, R38.2, SCL7.1, X8.3
BUS_SCL8: IC9.9, R43.2, SCL8.1, X9.3
BUS_SCL9: IC10.9, R48.2, SCL9.1, X10.3
BUS_SDA: IC1.7, R2.2, SDA.1, X1.4
BUS_SDA1: IC2.7, R7.2, SDA1.1, X2.4
BUS_SDA2: IC3.7, R12.2, SDA2.1, X3.4
BUS_SDA3: IC4.7, R17.2, SDA3.1, X4.4
BUS_SDA4: IC5.7, R22.2, SDA4.1, X5.4
BUS_SDA5: IC6.7, R27.2, SDA5.1, X6.4
BUS_SDA6: IC7.7, R32.2, SDA6.1, X7.4
BUS_SDA7: IC8.7, R37.2, SDA7.1, X8.4
BUS_SDA8: IC9.7, R42.2, SDA8.1, X9.4
BUS_SDA9: IC10.7, R47.2, SDA9.1, X10.4
DW: D2.A, DW.1, IC1.4, R1.2
DW1: D1.A, DW1.1, IC2.4, R6.2
DW2: D3.A, DW2.1, IC3.4, R11.2
DW3: D4.A, DW3.1, IC4.4, R16.2
DW4: D5.A, DW4.1, IC5.4, R21.2
DW5: D6.A, DW5.1, IC6.4, R26.2
DW6: D7.A, DW6.1, IC7.4, R31.2
DW7: D8.A, DW7.1, IC8.4, R36.2
DW8: D9.A, DW8.1, IC9.4, R41.2
DW9: D10.A, DW9.1, IC10.4, R46.2
GND: C2.2, GND.1, GND_.1, IC1.14, PAD100.1, PAD101.1, PAD102.1, X1.6
GND1: C1.2, GND1.1, GND_1.1, IC2.14, PAD10.1, PAD11.1, PAD12.1, X2.6
GND2: C3.2, GND2.1, GND_2.1, IC3.14, PAD22.1, PAD23.1, PAD24.1, X3.6
GND3: C4.2, GND3.1, GND_3.1, IC4.14, PAD34.1, PAD35.1, PAD36.1, X4.6
GND4: C5.2, GND4.1, GND_4.1, IC5.14, PAD46.1, PAD47.1, PAD48.1, X5.6
GND5: C6.2, GND5.1, GND_5.1, IC6.14, PAD58.1, PAD59.1, PAD60.1, X6.6
GND6: C7.2, GND6.1, GND_6.1, IC7.14, PAD70.1, PAD71.1, PAD72.1, X7.6
GND7: C8.2, GND7.1, GND_7.1, IC8.14, PAD82.1, PAD83.1, PAD84.1, X8.6
GND8: C9.2, GND8.1, GND_8.1, IC9.14, PAD106.1, PAD107.1, PAD108.1, X9.6
GND9: C10.2, GND9.1, GND_9.1, IC10.14, PAD118.1, PAD119.1, PAD120.1, X10.6
INT0: IC1.5, INT0.1, J_CS.1
INT1: IC2.5, INT1.1, J_CS1.1
INT2: IC3.5, INT3.1, J_CS2.1
INT3: IC4.5, INT5.1, J_CS3.1
INT4: IC5.5, INT7.1, J_CS4.1
INT5: IC6.5, INT9.1, J_CS5.1
INT6: IC7.5, INT11.1, J_CS6.1
INT7: IC8.5, INT13.1, J_CS7.1
INT8: IC9.5, INT15.1, J_CS8.1
INT9: IC10.5, INT17.1, J_CS9.1
PA0: IC1.13, PA0.1
PA1: IC1.12, PA1.1
PA2: IC1.11, PA2.1
PA3: IC1.10, PA3.1
PA4: IC2.13, PA4.1
PA5: IC2.6, PA9.1
PA6: IC2.10, PA8.1
PA7: IC1.6, PA7.1
PA8: IC2.11, PA6.1
PA9: IC2.12, PA5.1
PA10: IC3.13, PA10.1
PA11: IC3.6, PA14.1
PA12: IC3.10, PA13.1
PA13: IC3.11, PA12.1
PA14: IC3.12, PA11.1
PA15: IC4.13, PA15.1
PA16: IC4.6, PA19.1
PA17: IC4.10, PA18.1
PA18: IC4.11, PA17.1
PA19: IC4.12, PA16.1
PA20: IC5.13, PA20.1
PA21: IC5.6, PA24.1
PA22: IC5.10, PA23.1
PA23: IC5.11, PA22.1
PA24: IC5.12, PA21.1
PA25: IC6.13, PA25.1
PA26: IC6.6, PA29.1
PA27: IC6.10, PA28.1
PA28: IC6.11, PA27.1
PA29: IC6.12, PA26.1
PA30: IC7.13, PA30.1
PA31: IC7.6, PA34.1
PA32: IC7.10, PA33.1
PA33: IC7.11, PA32.1
PA34: IC7.12, PA31.1
PA35: IC8.13, PA35.1
PA36: IC8.6, PA39.1
PA37: IC8.10, PA38.1
PA38: IC8.11, PA37.1
PA39: IC8.12, PA36.1
PA40: IC9.13, PA40.1
PA41: IC9.6, PA44.1
PA42: IC9.10, PA43.1
PA43: IC9.11, PA42.1
PA44: IC9.12, PA41.1
PA45: IC10.13, PA45.1
PA46: IC10.6, PA49.1
PA47: IC10.10, PA48.1
PA48: IC10.11, PA47.1
PA49: IC10.12, PA46.1
PB0: IC1.2, PB0.1
PB1: IC1.3, PB1.1
PB2: IC2.3, PB3.1
PB3: IC2.2, PB2.1
PB4: IC3.3, PB5.1
PB5: IC3.2, PB4.1
PB6: IC4.3, PB7.1
PB7: IC4.2, PB6.1
PB8: IC5.3, PB9.1
PB9: IC5.2, PB8.1
PB10: IC6.3, PB11.1
PB11: IC6.2, PB10.1
PB12: IC7.3, PB13.1
PB13: IC7.2, PB12.1
PB14: IC8.3, PB15.1
PB15: IC8.2, PB14.1
PB16: IC9.3, PB17.1
PB17: IC9.2, PB16.1
PB18: IC10.3, PB19.1
PB19: IC10.2, PB18.1
VCC: C2.1, IC1.1, R1.1, R2.1, R3.1, R4.1, R5.1, VCC.1, X1.2
VCC1: C1.1, IC2.1, R6.1, R7.1, R8.1, R9.1, R10.1, VCC1.1, X2.2
VCC2: C3.1, IC3.1, R11.1, R12.1, R13.1, R14.1, R15.1, VCC2.1, X3.2
VCC3: C4.1, IC4.1, R16.1, R17.1, R18.1, R19.1, R20.1, VCC3.1, X4.2
VCC4: C5.1, IC5.1, R21.1, R22.1, R23.1, R24.1, R25.1, VCC4.1, X5.2
VCC5: C6.1, IC6.1, R26.1, R27.1, R28.1, R29.1, R30.1, VCC5.1, X6.2
VCC6: C7.1, IC7.1, R31.1, R32.1, R33.1, R34.1, R35.1, VCC6.1, X7.2
VCC7: C8.1, IC8.1, R36.1, R37.1, R38.1, R39.1, R40.1, VCC7.1, X8.2
VCC8: C9.1, IC9.1, R41.1, R42.1, R43.1, R44.1, R45.1, VCC8.1, X9.2
VCC9: C10.1, IC10.1, R46.1, R47.1, R48.1, R49.1, R50.1, VCC9.1, X10.2
