MS71/ROS2Mower/hw/split_node_02.brd

## EAGLE design hw/split_node_02.brd (2020-08-21)

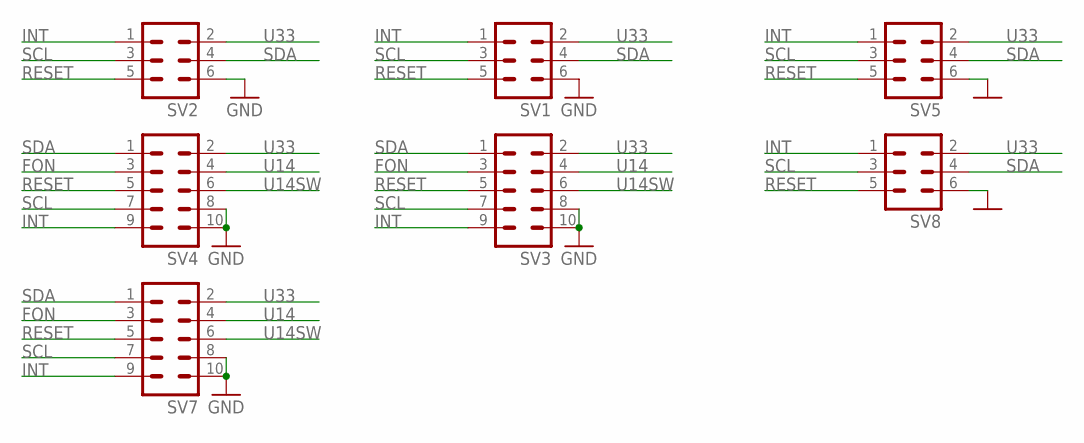
[picture p73: schematic split_node_02.sch]

Parts:
SV1, SV2, SV5, SV8: ML6
SV3, SV4, SV7: ML10

Connections:
FON: SV3.3, SV4.3, SV7.3
GND: SV1.6, SV2.6, SV3.8, SV3.10, SV4.8, SV4.10, SV5.6, SV7.8, SV7.10, SV8.6
INT: SV1.1, SV2.1, SV3.9, SV4.9, SV5.1, SV7.9, SV8.1
RESET: SV1.5, SV2.5, SV3.5, SV4.5, SV5.5, SV7.5, SV8.5
SCL: SV1.3, SV2.3, SV3.7, SV4.7, SV5.3, SV7.7, SV8.3
SDA: SV1.4, SV2.4, SV3.1, SV4.1, SV5.4, SV7.1, SV8.4
U14: SV3.4, SV4.4, SV7.4
U14SW: SV3.6, SV4.6, SV7.6
U33: SV1.2, SV2.2, SV3.2, SV4.2, SV5.2, SV7.2, SV8.2

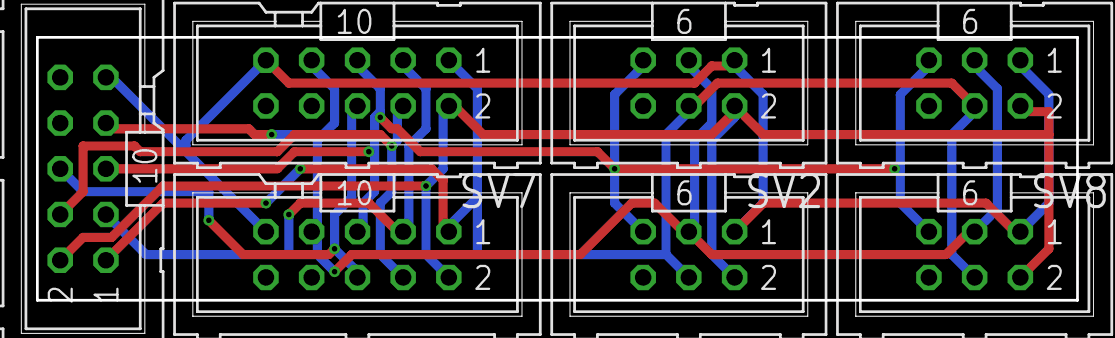
[picture p74: board split_node_02.brd from above]

Board: 2 copper layers, 57.8 x 14.6 mm, 7 parts (0 on the bottom side), 9 nets.
