MS71/ROS2Mower/hw/relais_node_01.brd

## EAGLE design hw/relais_node_01.brd (2020-08-21)

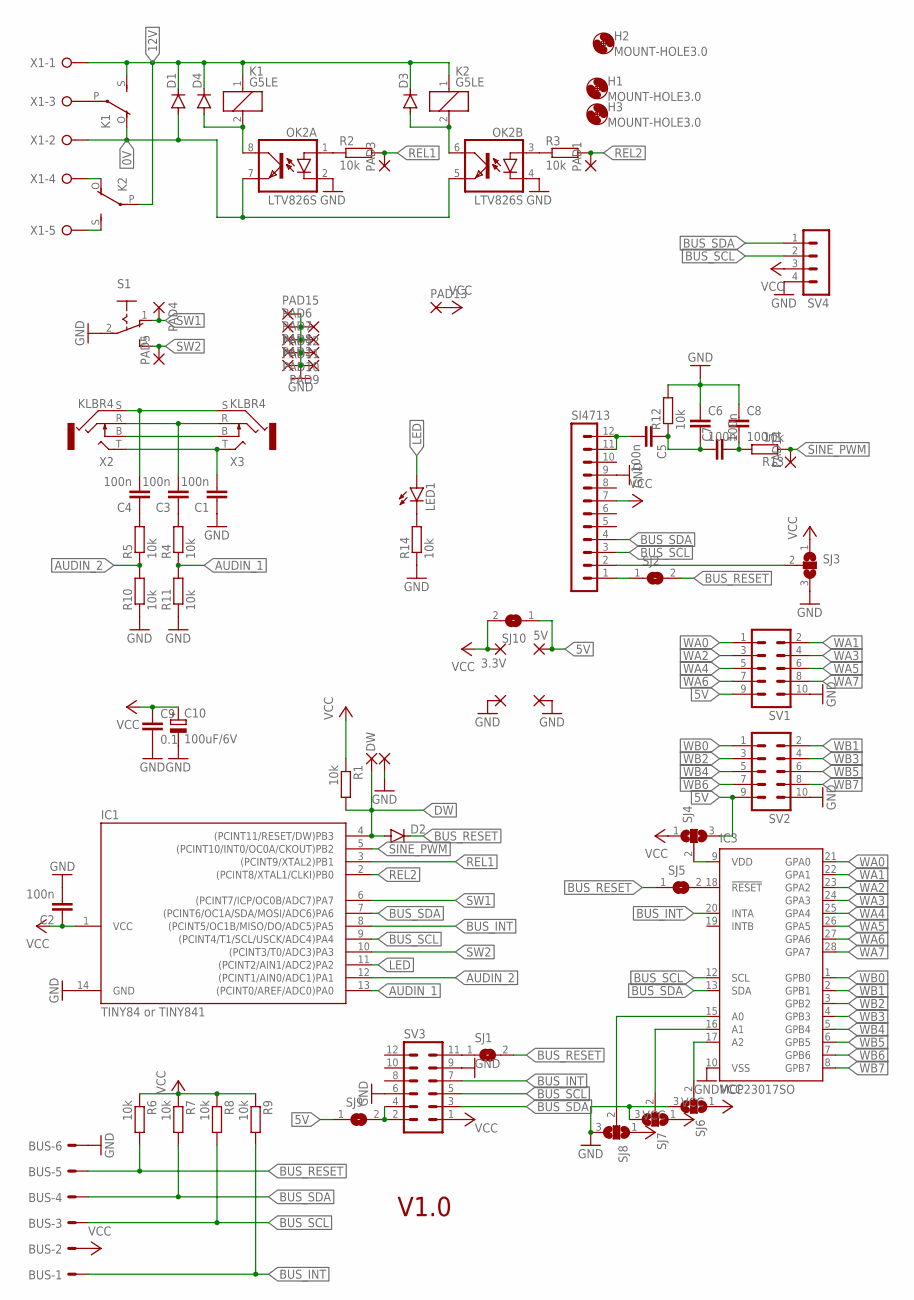
[picture p75: schematic relais_node_01.sch, sheet 1]

Parts:
3.3V, 5V: 1,6/0,8
BUS: ML6LE; ML6L
C1, C2, C3, C4, C5, C6, C7, C8: 100n; C0805
C9: 0.1; C0805
C10: 100uF/6V; B/3528-21R
D1: DIODE-MELF-MLL41; MELF-MLL41
D2, D3, D4: DIODE-MINIMELF; MINIMELF
DW: 1,6/0,9
GND_: 1,6/0,9
H1, H2, H3: MOUNT-HOLE3.0; 3,0
IC1: TINY84 or TINY841; SOIC14
IC3: MCP23017SO; SO28W
K1, K2: G5LE
LED1: LED3MM
OK2: LTV826S; DIL8-SMD
PAD1, PAD2, PAD3, PAD4, PAD5, PAD6, PAD7, PAD8, PAD9, PAD10, PAD11, PAD12, PAD13, PAD14, PAD15, PAD16, PAD17: 1,6/0,8
R1, R2, R3, R4, R5, R6, R7, R8, R9, R10, R11, R12, R13, R14: 10k; M0805
S1: 255SB
SI4713: MA12-1
SJ1, SJ2, SJ5, SJ9, SJ10: SJ
SJ3, SJ4, SJ6, SJ7, SJ8: SJ2W; SJ_2
SV1, SV2: ML10
SV3: MA06-2
SV4: MA04-1
X1: W237-05P; W237-5P
X2, X3: KLBR4

Connections:
0V: D1.A, K1.O, OK2.5 (EMIT), OK2.7 (EMIT), X1.2
5V: 5V.1, SJ4.3, SJ9.1, SJ10.1, SV1.9, SV2.9
5VRPI: SJ9.2, SV3.2, SV3.4
12V: D1.C, D3.C, D4.C, K1.1, K1.S, K2.1, K2.P, X1.1
AUDIN_1: IC1.13 ((PCINT0/AREF/ADC0)PA0), R4.1, R11.2
AUDIN_2: IC1.12 ((PCINT1/AIN0/ADC1)PA1), R5.1, R10.2
B: X2.B, X3.B
BUS_INT: BUS.1, IC1.8 ((PCINT5/OC1B/MISO/DO/ADC5)PA5), IC3.20 (INTA), R9.2, SV3.7
BUS_RESET: BUS.5, D2.C, R6.2, SJ1.2, SJ2.2, SJ5.1
BUS_SCL: BUS.3, IC1.9 ((PCINT4/T1/SCL/USCK/ADC4)PA4), IC3.12 (SCL), R8.2, SI4713.3, SV3.5, SV4.2
BUS_SDA: BUS.4, IC1.7 ((PCINT6/OC1A/SDA/MOSI/ADC6)PA6), IC3.13 (SDA), R7.2, SI4713.4, SV3.3, SV4.1
DW: D2.A, DW.1, IC1.4 ((PCINT11/RESET/DW)PB3), R1.2
GND: BUS.6, C1.1, C2.2, C6.1, C8.1, C9.2, C10.-, GND_.1, IC1.14 (GND), IC3.10 (VSS), OK2.2 (C), OK2.4 (C), PAD2.1, PAD6.1, PAD7.1, PAD8.1, PAD9.1, PAD10.1, PAD11.1, PAD12.1, PAD15.1, PAD16.1, PAD17.1, R10.1, R11.1, R12.2, R14.1, S1.2, SI4713.9, SJ3.3, SJ6.3, SJ7.3, SJ8.3, SV1.10, SV2.10, SV3.6, SV3.9, SV4.4
LED: IC1.11 ((PCINT2/AIN1/ADC2)PA2), LED1.A
unnamed: SJ1.1, SV3.11
unnamed: K1.P, X1.3
unnamed: D4.A, K1.2, OK2.8 (COL)
unnamed: D3.A, K2.2, OK2.6 (COL)
unnamed: K2.S, X1.5
unnamed: K2.O, X1.4
unnamed: OK2.1 (A), R2.1
unnamed: OK2.3 (A), R3.1
unnamed: C3.1, R4.2
unnamed: C4.1, R5.2
unnamed: SI4713.1, SJ2.1
unnamed: SI4713.2, SJ3.2
unnamed: LED1.K (C), R14.2
unnamed: IC3.9 (VDD), SJ4.2
unnamed: IC3.18 (!RESET), SJ5.2
unnamed: C5.2, SI4713.11, SI4713.12
unnamed: C5.1, C6.2, C7.1, R12.1
unnamed: C7.2, C8.2, R13.2
unnamed: IC3.17 (A2), SJ6.2
unnamed: IC3.16 (A1), SJ7.2
unnamed: IC3.15 (A0), SJ8.2
R: C3.2, X2.R, X3.R
REL1: IC1.3 ((PCINT9/XTAL2)PB1), PAD3.1, R2.2
REL2: IC1.2 ((PCINT8/XTAL1/CLKI)PB0), PAD1.1, R3.2
S: C4.2, X2.S, X3.S
SINE_PWM: IC1.5 ((PCINT10/INT0/OC0A/CKOUT)PB2), PAD14.1, R13.1
SW1: IC1.6 ((PCINT7/ICP/OC0B/ADC7)PA7), PAD4.1, S1.1 (O)
SW2: IC1.10 ((PCINT3/T0/ADC3)PA3), PAD5.1, S1.3 (S)
T: C1.2, X2.T, X3.T
VCC: 3.3V.1, BUS.2, C2.1, C9.1, C10.+, IC1.1 (VCC), PAD13.1, R1.1, R6.1, R7.1, R8.1, R9.1, SI4713.7, SJ3.1, SJ4.1, SJ6.1, SJ7.1, SJ8.1, SJ10.2, SV3.1, SV4.3
WA0: IC3.21 (GPA0), SV1.1
WA1: IC3.22 (GPA1), SV1.2
WA2: IC3.23 (GPA2), SV1.3
WA3: IC3.24 (GPA3), SV1.4
WA4: IC3.25 (GPA4), SV1.5
WA5: IC3.26 (GPA5), SV1.6
WA6: IC3.27 (GPA6), SV1.7
WA7: IC3.28 (GPA7), SV1.8
WB0: IC3.1 (GPB0), SV2.1
WB1: IC3.2 (GPB1), SV2.2
WB2: IC3.3 (GPB2), SV2.3
WB3: IC3.4 (GPB3), SV2.4
WB4: IC3.5 (GPB4), SV2.5
WB5: IC3.6 (GPB5), SV2.6
WB6: IC3.7 (GPB6), SV2.7
WB7: IC3.8 (GPB7), SV2.8

Notes on the sheet:
V1.0

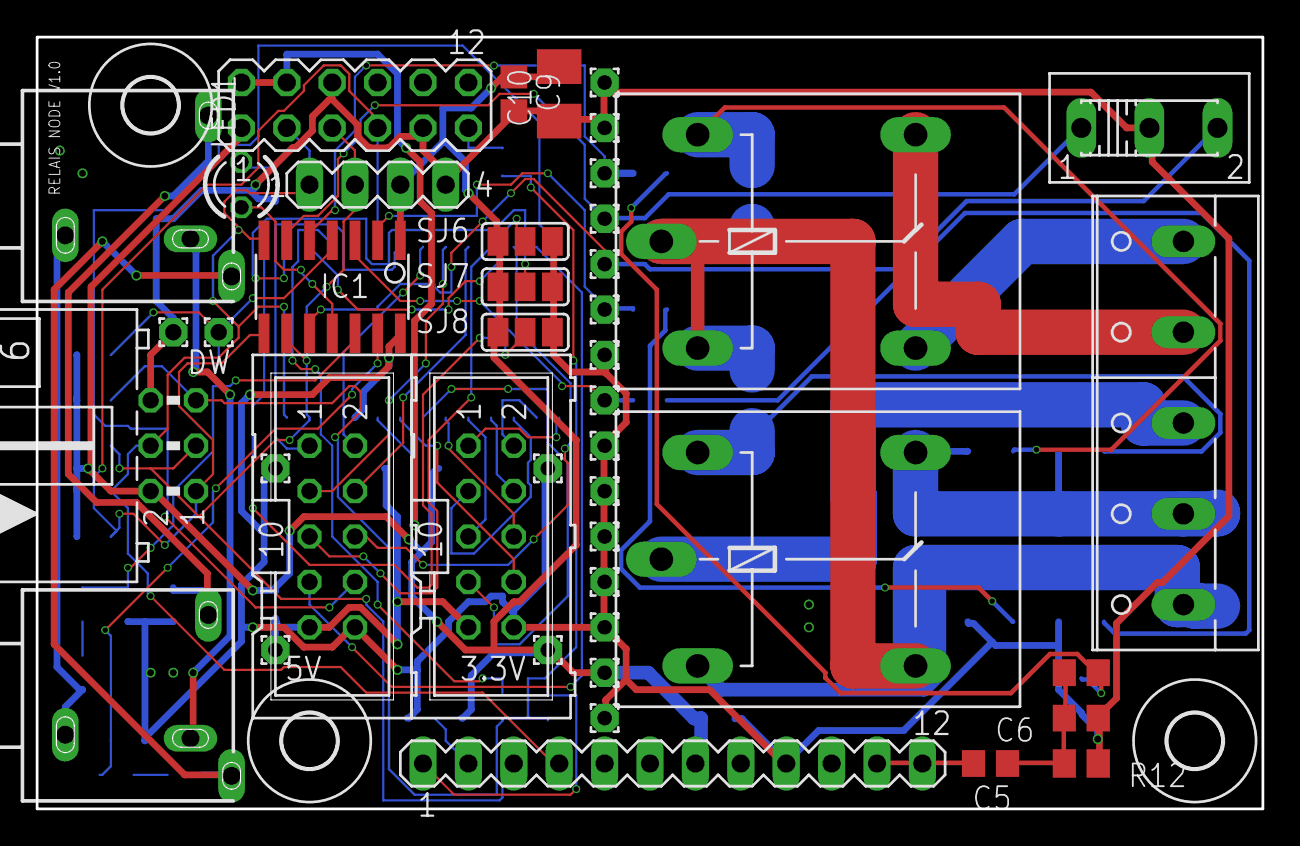
[picture p76: board relais_node_01.brd from above]

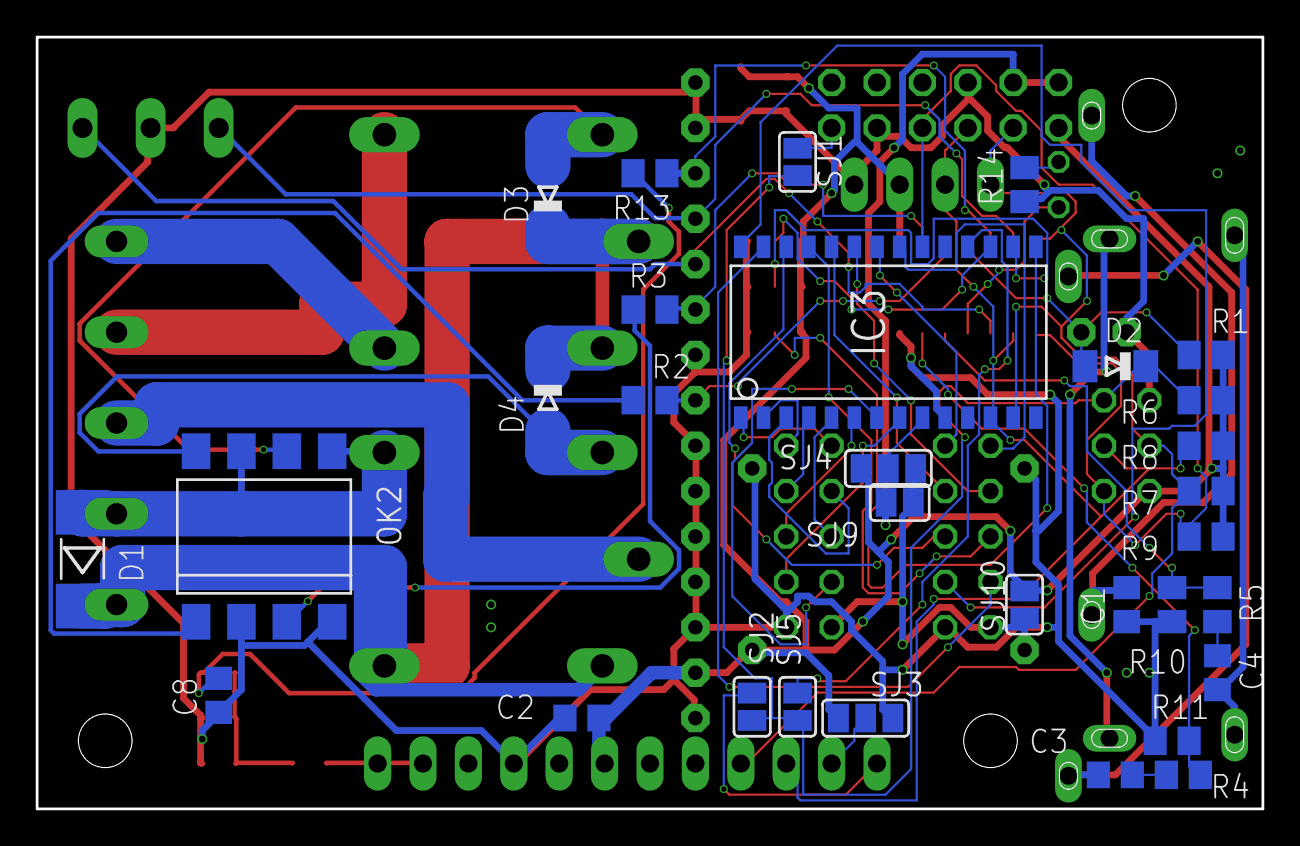
[picture p77: board relais_node_01.brd from below]

Board: 2 copper layers, 68.6 x 43.2 mm, 78 parts (31 on the bottom side), 60 nets.
