MS71/ROS2Mower/hw/main_node.brd

## EAGLE design hw/main_node.brd (2020-08-21)

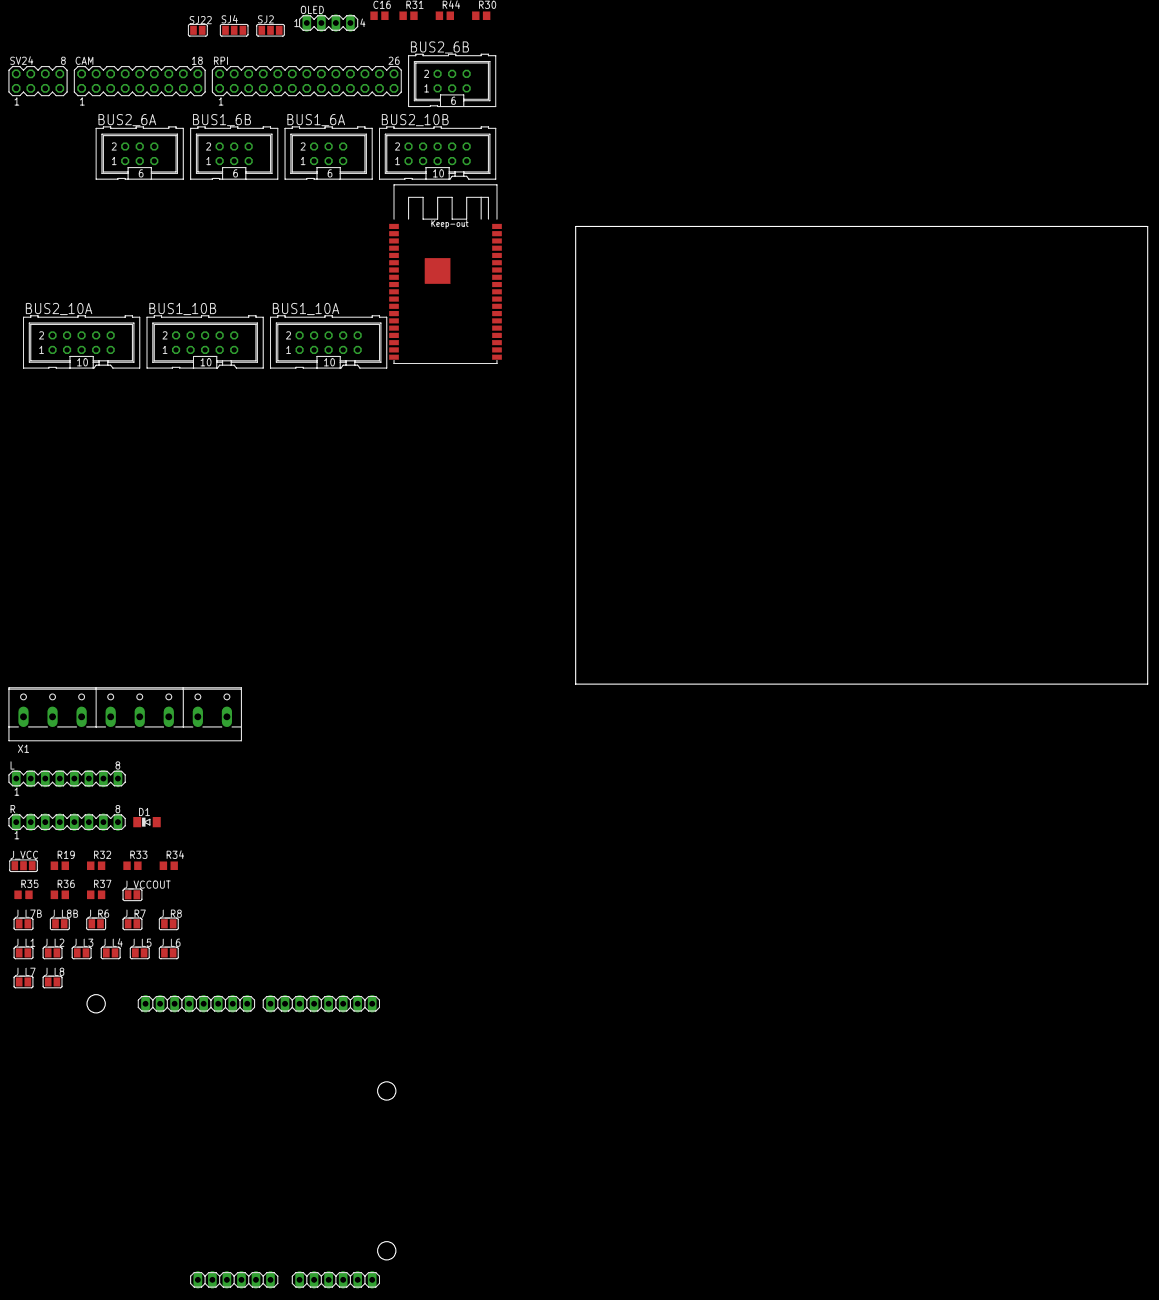
[picture p78: board main_node.brd from above]

Board: 2 copper layers, 100.0 x 80.0 mm, 47 parts (0 on the bottom side), 61 nets, no tracks yet.

Parts:
BUS1_6A, BUS1_6B, BUS2_6A, BUS2_6B: ML6
BUS1_10A, BUS1_10B, BUS2_10A, BUS2_10B: ML10
C16: 0.1; C0805
CAM: MA09-2
D1: 4148; MINIMELF
IC2: ARDUINO2009_2
IC10: ESP32-WROVER
J_L1, J_L2, J_L3, J_L4, J_L5, J_L6, J_L7, J_L7B, J_L8, J_L8B: SJ
J_R6, J_R7, J_R8: SJ
J_VCC: SJ_2
J_VCCOUT: SJ
L: MA08-1
OLED: MA04-1
R: MA08-1
R19, R32, R33, R34, R35, R36, R37: R0805
R30, R44: 100k; R0805
R31: 470; R0805
RPI: MA13-2
SJ2, SJ4: SJ_2
SJ22: SJ
SV24: MA04-2
X1: W237-8P

Connections:
CAM_D0: CAM.16, IC10.IO5
CAM_D1: CAM.15, IC10.IO18
CAM_D2: CAM.14, IC10.IO19
CAM_D3: CAM.13, IC10.IO21
CAM_D4: CAM.12, IC10.SENSOR_VP
CAM_D5: CAM.11, IC10.SENSOR_VN
CAM_D6: CAM.10, IC10.IO34
CAM_D7: CAM.9, IC10.IO35
CAM_HSYNC: CAM.6, IC10.IO23
CAM_PCLK: CAM.7, IC10.IO22
CAM_RESET: CAM.17, IC10.IO32
CAM_SCL: CAM.3, IC10.IO27
CAM_SDA: CAM.4, IC10.IO26
CAM_VSYNC: CAM.5, IC10.IO25
ESP_AEN: C16.2, IC10.EN, R30.2, R31.1, SV24.6
ESP_BOOT: CAM.8, IC10.IO0, R44.1, SV24.4
ESP_RXD: IC10.RXD0, SV24.7
ESP_TXD: IC10.TXD0, SV24.2
ESP_U3.3: IC10.VDD33, R30.1, R44.2, SV24.8
FON1: BUS1_10A.3, BUS1_10B.3
FON2: BUS2_10A.3, BUS2_10B.3
GND: BUS1_6A.6, BUS1_6B.6, BUS1_10A.8, BUS1_10A.10, BUS1_10B.8, BUS1_10B.10, BUS2_6A.6, BUS2_6B.6, BUS2_10A.8, BUS2_10A.10, BUS2_10B.8, BUS2_10B.10, C16.1, IC2.4, IC2.5, IC2.27, IC10.GND, IC10.GND2, IC10.GND3, IC10.GND_2, R.1, RPI.6, RPI.9, RPI.20, RPI.25, SJ2.1, SJ4.1, SV24.1, X1.1, X1.2
INT1: BUS1_6A.1, BUS1_6B.1, BUS1_10A.9, BUS1_10B.9, RPI.7
INT2: BUS2_6A.1, BUS2_6B.1, BUS2_10A.9, BUS2_10B.9
LCD_1: OLED.1, SJ2.2
LCD_2: OLED.2, SJ4.2
unnamed: X1.7, X1.8
unnamed: X1.5, X1.6
unnamed: J_R6.1, R.6
unnamed: J_R7.1, R.7
unnamed: IC10.IO33, SJ22.2
unnamed: J_R8.1, R.8
unnamed: J_L7.2, J_L7B.2, L.7
unnamed: J_L6.2, L.6, R19.1
unnamed: J_L8.2, J_L8B.2, L.8
unnamed: J_L5.2, L.5, R34.1
unnamed: J_L4.2, L.4, R35.1
unnamed: J_L2.2, L.2, R37.1
unnamed: J_L3.2, L.3, R36.1
unnamed: J_L1.2, L.1
RESET1: BUS1_6A.5, BUS1_6B.5, BUS1_10A.5, BUS1_10B.5
RESET2: BUS2_6A.5, BUS2_6B.5, BUS2_10A.5, BUS2_10B.5
SCL1: BUS1_6A.3, BUS1_6B.3, BUS1_10A.7, BUS1_10B.7, RPI.5, SV24.3
SCL2: BUS2_6A.3, BUS2_6B.3, BUS2_10A.7, BUS2_10B.7, OLED.3
SDA1: BUS1_6A.4, BUS1_6B.4, BUS1_10A.1, BUS1_10B.1, RPI.3, SV24.5
SDA2: BUS2_6A.4, BUS2_6B.4, BUS2_10A.1, BUS2_10B.1, OLED.4
SPI_CS: RPI.22, SJ22.1
SPI_MISO: J_L2.1, RPI.21
SPI_MOSI: J_L3.1, RPI.19
U2_BUS: D1.A, J_L1.1, R32.1, R33.1
U3.3: RPI.1, RPI.17
U5: R.4, RPI.2, RPI.4
U33A: J_VCC.3, J_VCCOUT.2, R.2
U33B: J_VCC.1, R.3
U33_B1: BUS1_6A.2, BUS1_6B.2, BUS1_10A.2, BUS1_10B.2, BUS2_6A.2
U33_B2: BUS2_6B.2, BUS2_10A.2, BUS2_10B.2
U50_B1: BUS1_10A.4, BUS1_10B.4
U50_B2: BUS2_10A.4, BUS2_10B.4
UBATSW: BUS1_10A.6, BUS1_10B.6, BUS2_10A.6, BUS2_10B.6
U_OLED: SJ2.3, SJ4.3
VCC: J_VCC.2, R19.2, R32.2, R34.2, R35.2, R36.2, R37.2
