MS71/ROS2Mower/hw/stm32g071_pcb.brd

## EAGLE design hw/stm32g071_pcb.brd (2020-08-21)

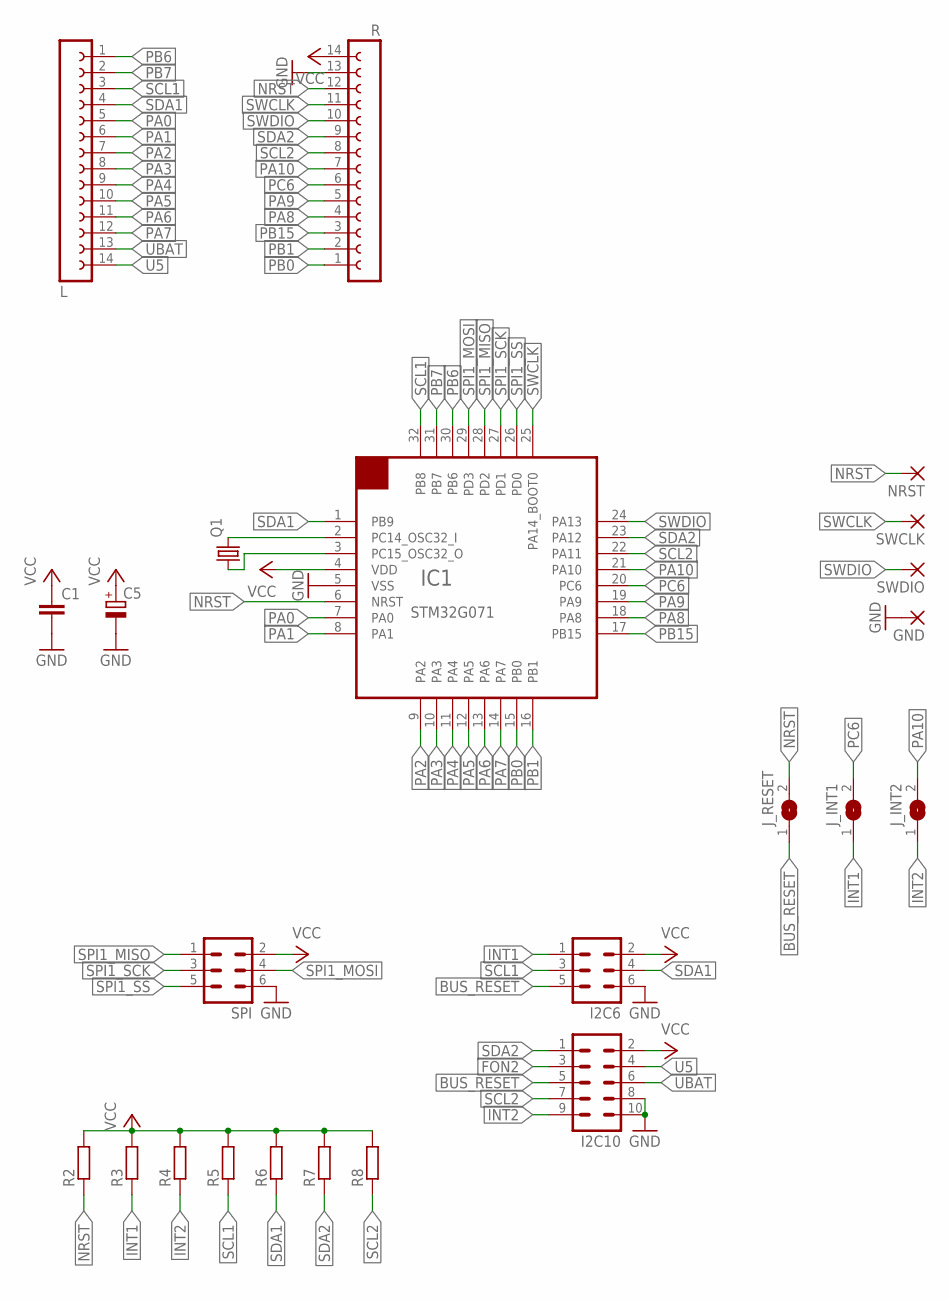
[picture p79: schematic stm32g071_pcb.sch]

Parts:
C1: C-EUC0805; C0805
C5: CPOL-EUB/3528-21W; B/3528-21W
GND: 1,6/0,8
I2C6: ML6
I2C10: ML10
IC1: STM32G071; LQFP-32
J_INT1, J_INT2: SJ
J_RESET: SJ
L: FE14-1; FE14
NRST: 1,6/0,8
Q1: CRYSTALTC26V; TC26V
R: FE14-1; FE14
R2, R3, R4, R5, R6, R7, R8: R-EU_R0805; R0805
SPI: ML6
SWCLK: 1,6/0,8
SWDIO: 1,6/0,8

Connections:
BUS_RESET: I2C6.5, I2C10.5, J_RESET.1
FON2: I2C10.3
GND: C1.2, C5.-, GND.1, I2C6.6, I2C10.8, I2C10.10, IC1.5 (VSS), R.13, SPI.6
INT1: I2C6.1, J_INT1.1, R3.1
INT2: I2C10.9, J_INT2.1, R4.1
unnamed: IC1.2 (PC14_OSC32_I), Q1.2
unnamed: IC1.3 (PC15_OSC32_O), Q1.1
NRST: IC1.6 (NRST), J_RESET.2, NRST.1, R.12, R2.1
PA0: IC1.7 (PA0), L.5
PA1: IC1.8 (PA1), L.6
PA2: IC1.9 (PA2), L.7
PA3: IC1.10 (PA3), L.8
PA4: IC1.11 (PA4), L.9
PA5: IC1.12 (PA5), L.10
PA6: IC1.13 (PA6), L.11
PA7: IC1.14 (PA7), L.12
PA8: IC1.18 (PA8), R.4
PA9: IC1.19 (PA9), R.5
PA10: IC1.21 (PA10), J_INT2.2, R.7
PB0: IC1.15 (PB0), R.1
PB1: IC1.16 (PB1), R.2
PB6: IC1.30 (PB6), L.1
PB7: IC1.31 (PB7), L.2
PB15: IC1.17 (PB15), R.3
PC6: IC1.20 (PC6), J_INT1.2, R.6
SCL1: I2C6.3, IC1.32 (PB8), L.3, R5.1
SCL2: I2C10.7, IC1.22 (PA11), R.8, R8.1
SDA1: I2C6.4, IC1.1 (PB9), L.4, R6.1
SDA2: I2C10.1, IC1.23 (PA12), R.9, R7.1
SPI1_MISO: IC1.28 (PD2), SPI.1
SPI1_MOSI: IC1.29 (PD3), SPI.4
SPI1_SCK: IC1.27 (PD1), SPI.3
SPI1_SS: IC1.26 (PD0), SPI.5
SWCLK: IC1.25 (PA14_BOOT0), R.11, SWCLK.1
SWDIO: IC1.24 (PA13), R.10, SWDIO.1
U5: I2C10.4, L.14
UBAT: I2C10.6, L.13
VCC: C1.1, C5.+, I2C6.2, I2C10.2, IC1.4 (VDD), R.14, R2.2, R3.2, R4.2, R5.2, R6.2, R7.2, R8.2, SPI.2

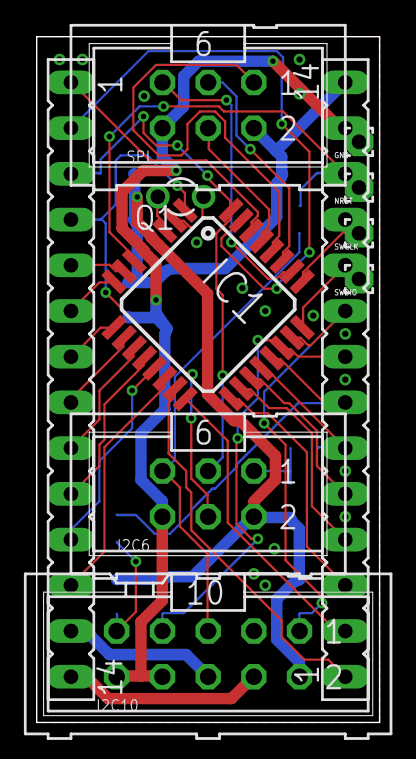
[picture p80: board stm32g071_pcb.brd from above]

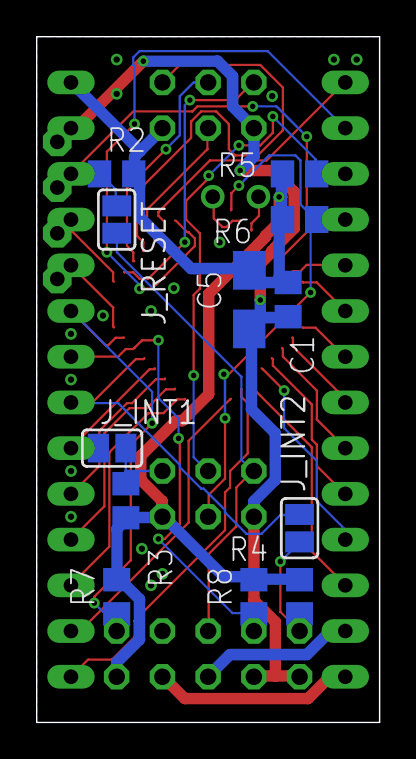
[picture p81: board stm32g071_pcb.brd from below]

Board: 2 copper layers, 19.1 x 38.1 mm, 23 parts (12 on the bottom side), 37 nets.
