MS71/ROS2Mower/hw/spi_node.brd

## EAGLE design hw/spi_node.brd (2020-07-19)

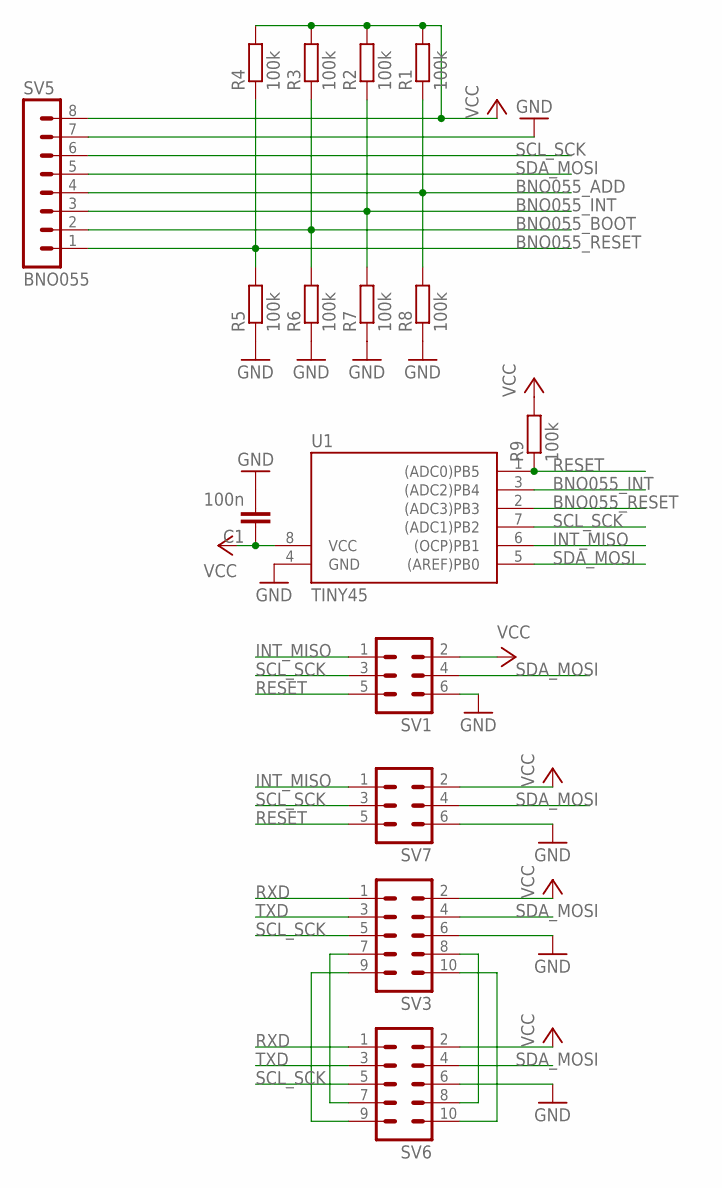
[picture p82: schematic spi_node.sch]

Parts:
C1: 100n; C0805
R1, R2, R3, R4, R5, R6, R7, R8, R9: 100k; M0805
SV1, SV7: ML6
SV3, SV6: ML10
SV5: BNO055; MA08-1
U1: TINY45; SOIC8

Connections:
BNO055_ADD: R1.1, R8.2, SV5.4
BNO055_BOOT: R3.1, R6.2, SV5.2
BNO055_INT: R2.1, R7.2, SV5.3, U1.3 ((ADC2)PB4)
BNO055_RESET: R4.1, R5.2, SV5.1, U1.2 ((ADC3)PB3)
GND: C1.2, R5.1, R6.1, R7.1, R8.1, SV1.6, SV3.6, SV5.7, SV6.6, SV7.6, U1.4 (GND)
INT_MISO: SV1.1, SV7.1, U1.6 ((OCP)PB1)
unnamed: SV3.7, SV6.7
unnamed: SV3.9, SV6.9
unnamed: SV3.8, SV6.8
unnamed: SV3.10, SV6.10
RESET: R9.1, SV1.5, SV7.5, U1.1 ((ADC0)PB5)
RXD: SV3.1, SV6.1
SCL_SCK: SV1.3, SV3.5, SV5.6, SV6.5, SV7.3, U1.7 ((ADC1)PB2)
SDA_MOSI: SV1.4, SV3.4, SV5.5, SV6.4, SV7.4, U1.5 ((AREF)PB0)
TXD: SV3.3, SV6.3
VCC: C1.1, R1.2, R2.2, R3.2, R4.2, R9.2, SV1.2, SV3.2, SV5.8, SV6.2, SV7.2, U1.8 (VCC)

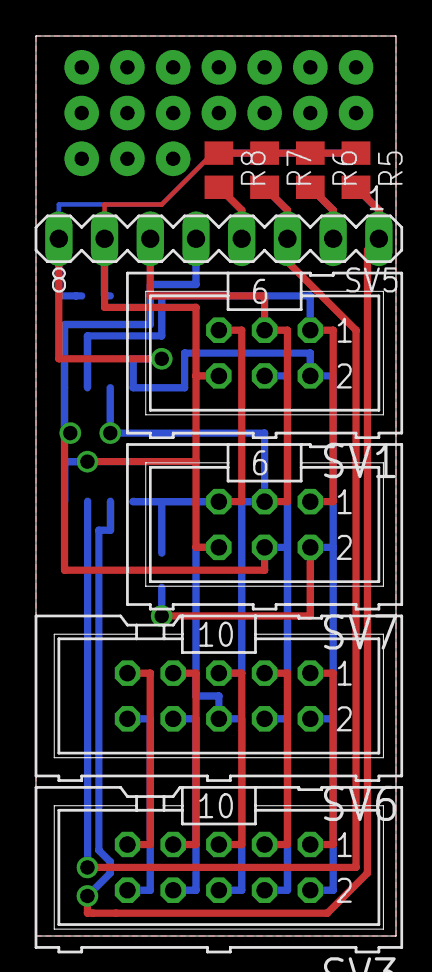
[picture p83: board spi_node.brd from above]

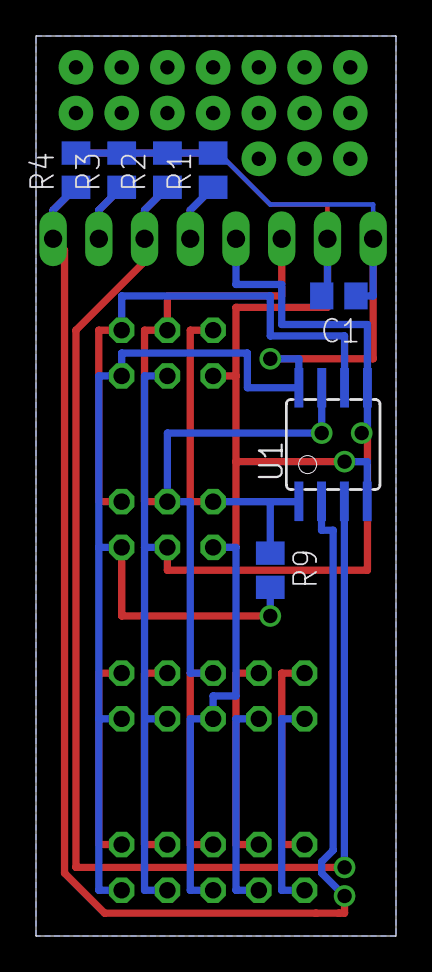
[picture p84: board spi_node.brd from below]

Board: 2 copper layers, 20.0 x 50.0 mm, 16 parts (7 on the bottom side), 16 nets.
