MS71/ROS2Mower/hw/lidar_node.brd

## EAGLE design hw/lidar_node.brd (2020-06-22)

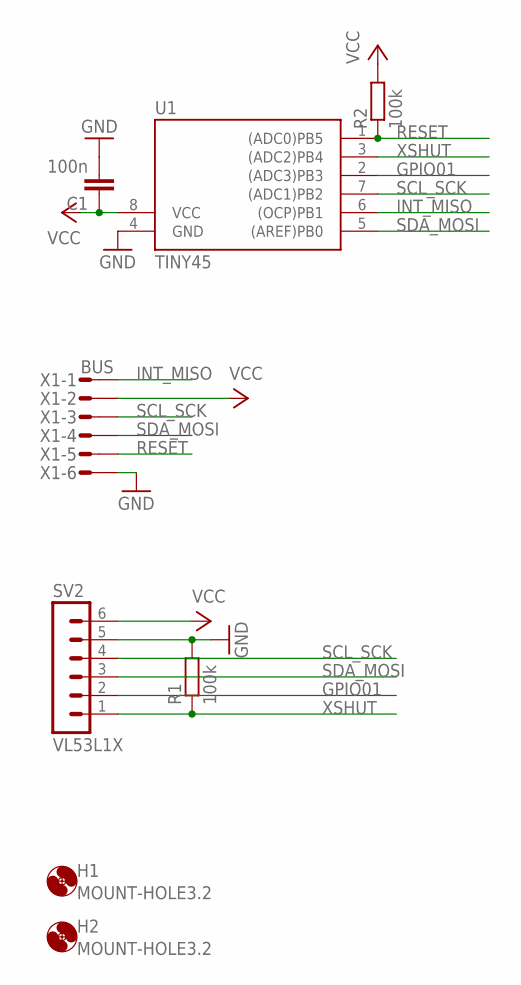
[picture p85: schematic lidar_node.sch]

Parts:
C1: 100n; C0805
H1, H2: MOUNT-HOLE3.2; 3,2
R1, R2: 100k; M0805
SV2: VL53L1X; MA06-1
U1: TINY45; SOIC8
X1: BUS; MICROMATCH-6

Connections:
GND: C1.2, R1.2, SV2.5, U1.4 (GND), X1.6
GPIO01: SV2.2, U1.2 ((ADC3)PB3)
INT_MISO: U1.6 ((OCP)PB1), X1.1
RESET: R2.1, U1.1 ((ADC0)PB5), X1.5
SCL_SCK: SV2.4, U1.7 ((ADC1)PB2), X1.3
SDA_MOSI: SV2.3, U1.5 ((AREF)PB0), X1.4
VCC: C1.1, R2.2, SV2.6, U1.8 (VCC), X1.2
XSHUT: R1.1, SV2.1, U1.3 ((ADC2)PB4)

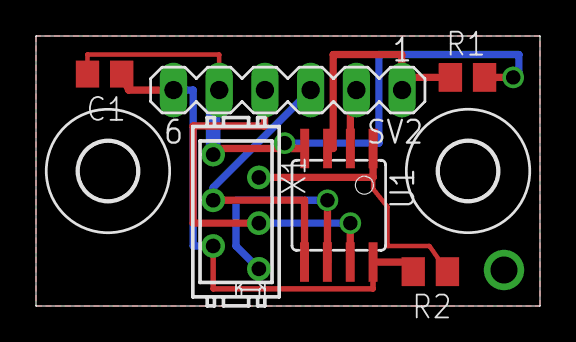
[picture p86: board lidar_node.brd from above]

Board: 2 copper layers, 28.0 x 15.0 mm, 8 parts (0 on the bottom side), 8 nets.
