MS71/ROS2Mower/hw/nutzen_05.brd

## EAGLE design hw/nutzen_05.brd (2020-08-21)

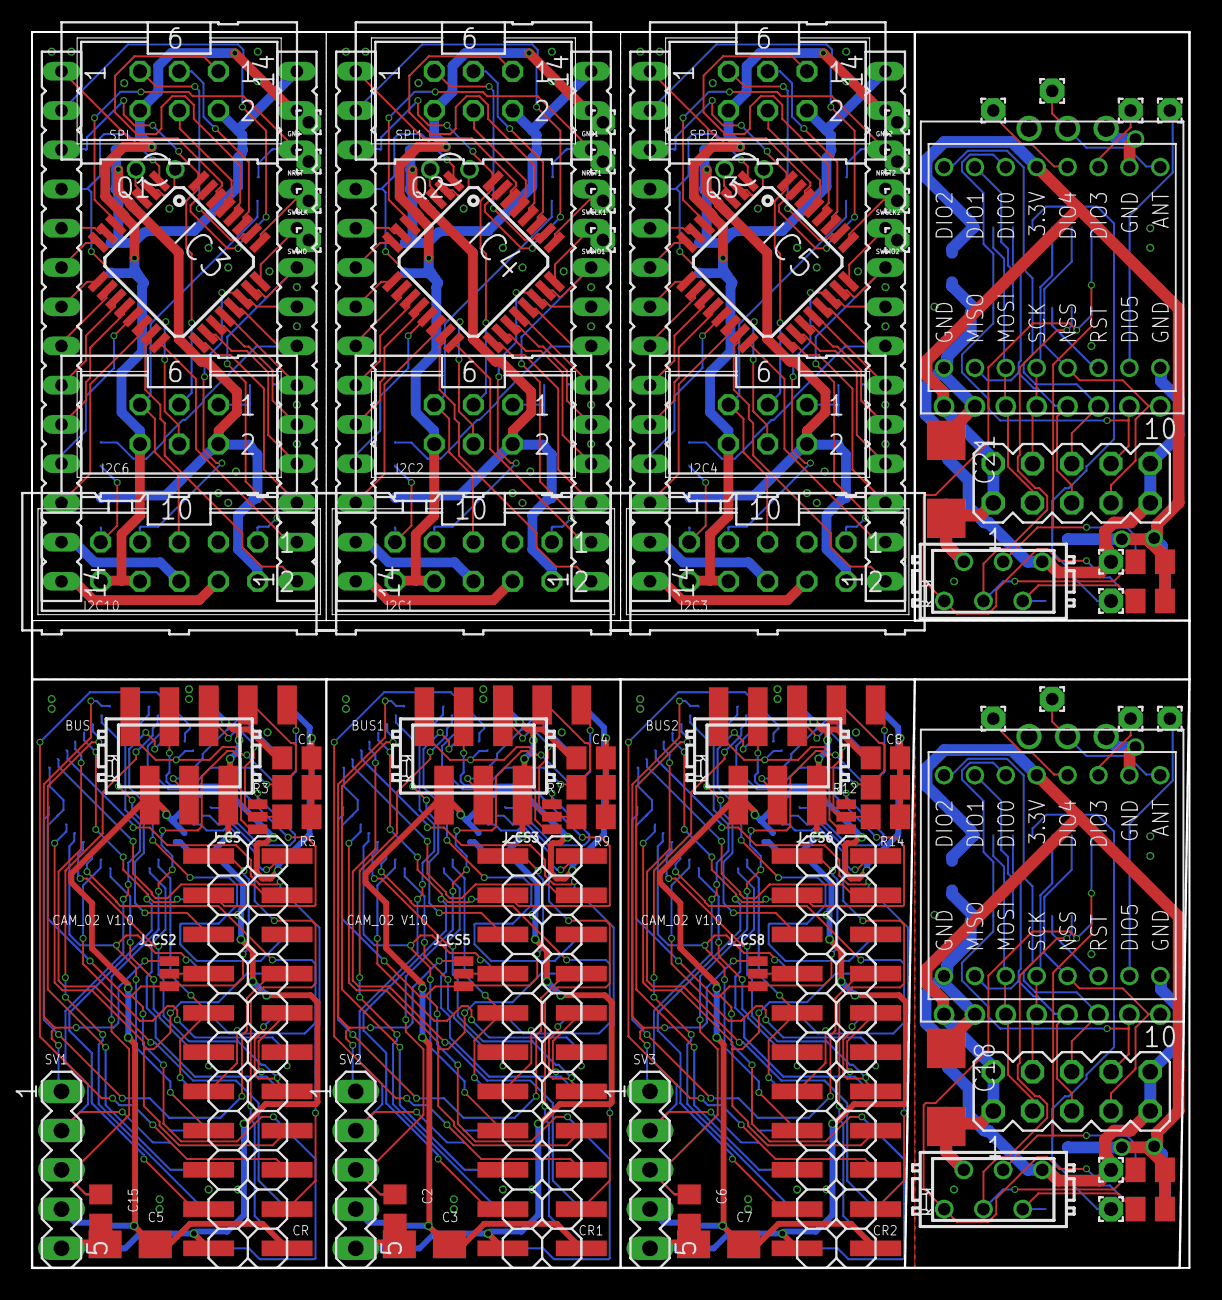
[picture p87: board nutzen_05.brd from above]

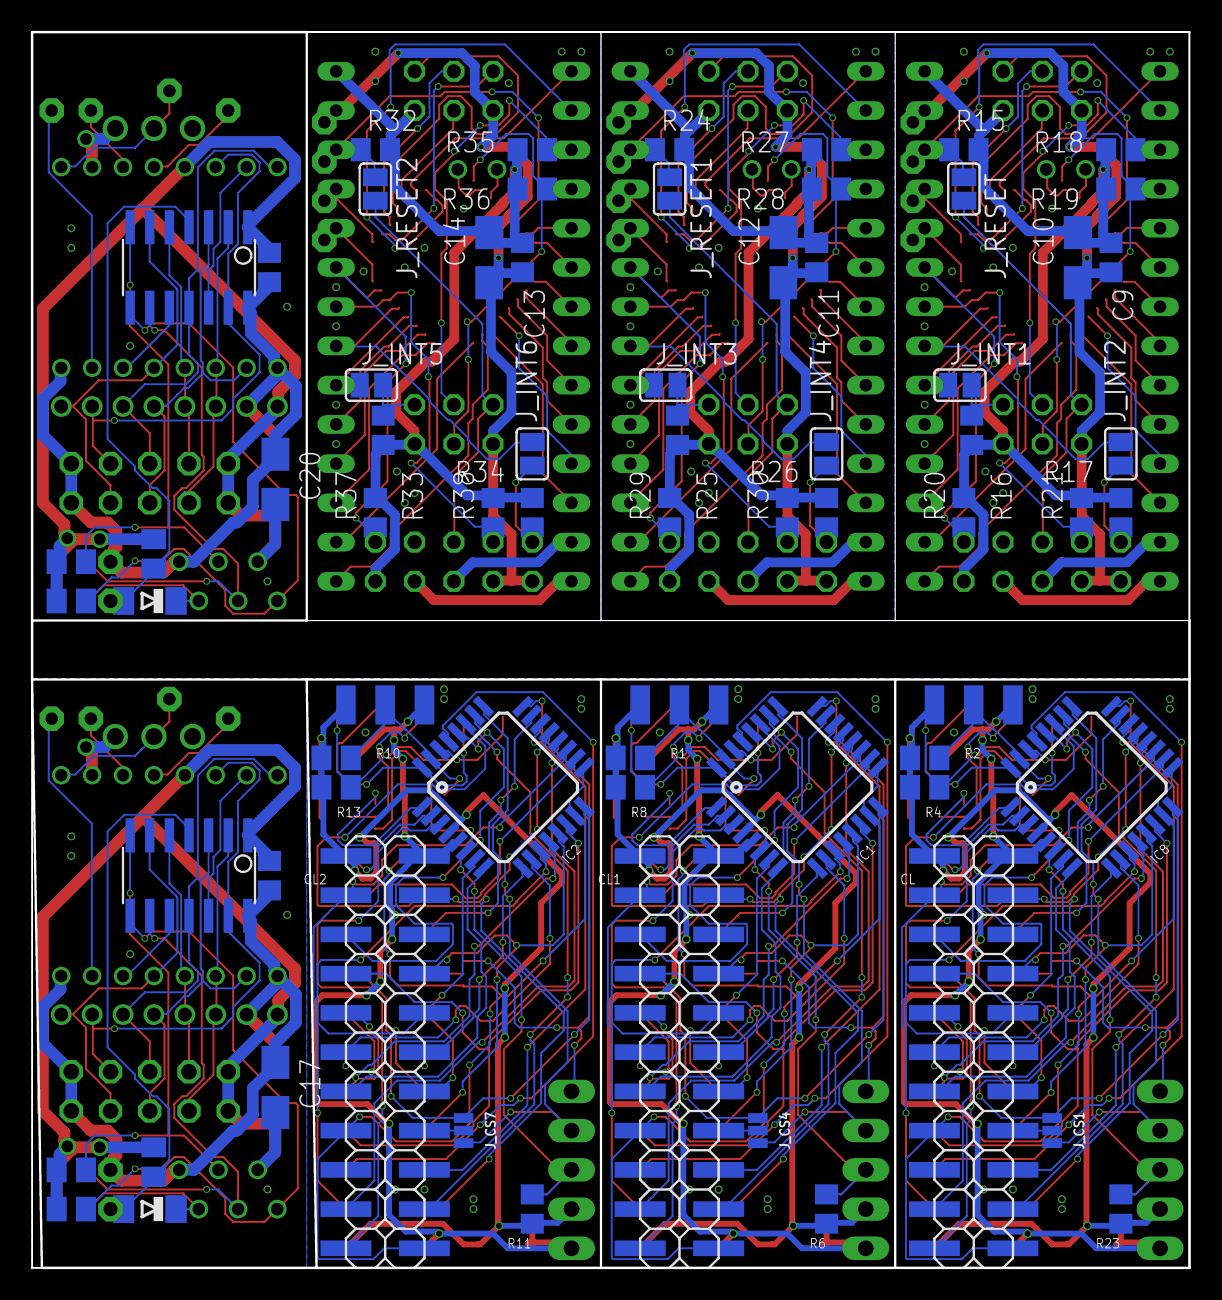
[picture p88: board nutzen_05.brd from below]

Board: 2 copper layers, 74.9 x 80.0 mm, 175 parts (77 on the bottom side), 251 nets.

Parts:
BUS, BUS1, BUS2: MICROMATCH-6SMD
C1, C2, C4, C6, C8, C15: 0.1; C0805
C3, C5, C7, C17, C20: 10u; B/3528-21W
C9, C11, C13: C0805
C10, C12, C14: B/3528-21W
C16, C19: 100n; C0805
C18, C21: C/6032-28R
CL, CL1, CL2: 2X11SMD
CR, CR1, CR2: 2X11SMD
D1, D2: MINIMELF
DW, DW1: 1,6/0,9
GND, GND1, GND2: 1,6/0,8
GND_, GND_1: 1,6/0,9
I2C1, I2C3, I2C10: ML10
I2C2, I2C4, I2C6: ML6
IC1, IC2, IC8: STM32G071KBT6N; LQFP-32
IC3, IC4, IC5: STM32G071; LQFP-32
IC6, IC7: TINY84 or TINY841; SOIC14
J_CS, J_CS1, J_CS2, J_CS3, J_CS4, J_CS5, J_CS6, J_CS7, J_CS8: SMT-JUMPER_3_1-NC_PASTE_NO-SILK
J_INT1, J_INT2, J_INT3, J_INT4, J_INT5, J_INT6: SJ
J_RESET, J_RESET1, J_RESET2: SJ
L, L1, L2: FE14
NRST, NRST1, NRST2: 1,6/0,8
PAD1, PAD2, PAD3, PAD4, PAD5, PAD6, PAD7, PAD8, PAD9, PAD10, PAD11, PAD12, PAD13, PAD14, PAD15, PAD16, PAD17, PAD18: SMD1,27-2,54
PAD19, PAD20, PAD21, PAD22, PAD23, PAD24, PAD25, PAD26: 1,6/0,8
Q1, Q2, Q3: TC26V
R, R22, R31: FE14
R1, R2, R3, R4, R5, R7, R8, R9, R10, R12, R13, R14, R39, R40, R41, R42, R43, R44, R45, R46, R47, R48: 10k; M0805
R6, R11, R23: 100K; R0805
R15, R16, R17, R18, R19, R20, R21, R24, R25, R26, R27, R28, R29, R30, R32, R33, R34, R35, R36, R37, R38: R0805
SPI, SPI1, SPI2: ML6
SV1, SV2, SV3: MA05-1
SV4, SV5: MA05-2
SWCLK, SWCLK1, SWCLK2: 1,6/0,8
SWDIO, SWDIO1, SWDIO2: 1,6/0,8
U$1, U$2: CC1101
U$3, U$4: WIRELESS-LORA-RFM95W#THT
X1, X2: BUS; MICROMATCH-6

Connections:
BUS_INT: IC6.8, R42.2, X1.1
BUS_INT1: IC7.8, R47.2, X2.1
BUS_P1: BUS1.5, J_CS3.2, PAD11.1, R9.2
BUS_P2: BUS2.5, J_CS6.2, PAD17.1, R14.2
BUS_P5: BUS.5, J_CS.2, PAD5.1, R5.2
BUS_RESET: I2C6.5, I2C10.5, J_RESET.1
BUS_RESET1: I2C1.5, I2C2.5, J_RESET1.1
BUS_RESET2: I2C3.5, I2C4.5, J_RESET2.1
BUS_RESET3: D2.C, R43.2, X1.5
BUS_RESET4: D1.C, R48.2, X2.5
BUS_SCL: IC6.9, R41.2, X1.3
BUS_SCL1: IC7.9, R46.2, X2.3
BUS_SDA: IC6.7, R40.2, X1.4
BUS_SDA1: IC7.7, R45.2, X2.4
CL_OE: CL.20, IC8.26
CL_OE1: CL1.20, IC1.26
CL_OE2: CL2.20, IC2.26
CL_PWDN: CL.16, J_CS1.2
CL_PWDN1: CL1.16, J_CS4.2
CL_PWDN2: CL2.16, J_CS7.2
CL_RCK: CL.18, IC8.22
CL_RCK1: CL1.18, IC1.22
CL_RCK2: CL2.18, IC2.22
CL_RST: CL.15, CL.22, CR.22, IC8.15, IC8.17, J_CS2.3
CL_RST1: CL1.15, CL1.22, CR1.22, IC1.15, IC1.17, J_CS5.3
CL_RST2: CL2.15, CL2.22, CR2.22, IC2.15, IC2.17, J_CS8.3
CL_VSYNC: CL.5, IC8.28
CL_VSYNC1: CL1.5, IC1.28
CL_VSYNC2: CL2.5, IC2.28
CL_WR: CL.19, IC8.20
CL_WR1: CL1.19, IC1.20
CL_WR2: CL2.19, IC2.20
CL_WRST: CL.21, IC8.3
CL_WRST1: CL1.21, IC1.3
CL_WRST2: CL2.21, IC2.3
CR_OE: CR.20, IC8.27
CR_OE1: CR1.20, IC1.27
CR_OE2: CR2.20, IC2.27
CR_PWDN: CR.16, J_CS2.2
CR_PWDN1: CR1.16, J_CS5.2
CR_PWDN2: CR2.16, J_CS8.2
CR_RCK: CR.18, IC8.23
CR_RCK1: CR1.18, IC1.23
CR_RCK2: CR2.18, IC2.23
CR_RST: CR.15, IC8.16, J_CS1.3
CR_RST1: CR1.15, IC1.16, J_CS4.3
CR_RST2: CR2.15, IC2.16, J_CS7.3
CR_VSYNC: CR.5, IC8.29
CR_VSYNC1: CR1.5, IC1.29
CR_VSYNC2: CR2.5, IC2.29
CR_WR: CR.19, IC8.18
CR_WR1: CR1.19, IC1.18
CR_WR2: CR2.19, IC2.18
CR_WRST: CR.21, IC8.2
CR_WRST1: CR1.21, IC1.2
CR_WRST2: CR2.21, IC2.2
CS0: IC6.6, SV4.7, U$1.CSN, U$3.A5
CS1: IC7.6, SV5.7, U$2.CSN, U$4.A5
C_D0: CL.14, CR.14, IC8.7
C_D1: CL.13, CR.13, IC8.8
C_D2: CL.12, CR.12, IC8.9
C_D3: CL.11, CR.11, IC8.10
C_D4: CL.10, CR.10, IC8.11
C_D5: CL.9, CR.9, IC8.12
C_D6: CL.8, CR.8, IC8.13
C_D7: CL.7, CR.7, IC8.14
C_D8: CL1.7, CR1.7, IC1.14
C_D9: CL1.8, CR1.8, IC1.13
C_D10: CL1.9, CR1.9, IC1.12
C_D11: CL1.10, CR1.10, IC1.11
C_D12: CL1.11, CR1.11, IC1.10
C_D13: CL1.12, CR1.12, IC1.9
C_D14: CL1.13, CR1.13, IC1.8
C_D15: CL1.14, CR1.14, IC1.7
C_D16: CL2.7, CR2.7, IC2.14
C_D17: CL2.8, CR2.8, IC2.13
C_D18: CL2.9, CR2.9, IC2.12
C_D19: CL2.10, CR2.10, IC2.11
C_D20: CL2.11, CR2.11, IC2.10
C_D21: CL2.12, CR2.12, IC2.9
C_D22: CL2.13, CR2.13, IC2.8
C_D23: CL2.14, CR2.14, IC2.7
DW: D2.A, DW.1, IC6.4, R39.2
DW1: D1.A, DW1.1, IC7.4, R44.2
GND: BUS.6, C1.2, C5.-, C15.2, CL.2, CR.2, IC8.5, PAD6.1, SV1.5
GND1: BUS1.6, C2.2, C3.-, C4.2, CL1.2, CR1.2, IC1.5, PAD12.1, SV2.5
GND2: BUS2.6, C6.2, C7.-, C8.2, CL2.2, CR2.2, IC2.5, PAD18.1, SV3.5
GND3: C9.2, C10.-, GND.1, I2C6.6, I2C10.8, I2C10.10, IC3.5, R.13, SPI.6
GND4: C11.2, C12.-, GND1.1, I2C1.8, I2C1.10, I2C2.6, IC4.5, R22.13, SPI1.6
GND5: C13.2, C14.-, GND2.1, I2C3.8, I2C3.10, I2C4.6, IC5.5, R31.13, SPI2.6
GND6: C16.2, C17.-, C18.-, GND_.1, IC6.14, SV4.9, SV4.10, U$1.GND0, U$1.GND1, U$1.GND2, U$3.A1, U$3.A8, U$3.B7, X1.6
GND7: C19.2, C20.-, C21.-, GND_1.1, IC7.14, SV5.9, SV5.10, U$2.GND0, U$2.GND1, U$2.GND2, U$4.A1, U$4.A8, U$4.B7, X2.6
GPIO0: IC6.13, SV4.8, U$1.GDO0, U$3.B3
GPIO1: IC6.12, U$3.B2
GPIO2: IC6.11, SV4.6, U$1.GDO2, U$3.B1
GPIO3: IC7.13, SV5.8, U$2.GDO0, U$4.B3
GPIO4: IC7.11, SV5.6, U$2.GDO2, U$4.B1
GPIO5: IC7.12, U$4.B2
INT1: I2C6.1, J_INT1.1, R16.1
INT2: I2C10.9, J_INT2.1, R17.1
INT3: I2C2.1, J_INT3.1, R25.1
INT4: I2C1.9, J_INT4.1, R26.1
INT5: I2C4.1, J_INT5.1, R33.1
INT6: I2C3.9, J_INT6.1, R34.1
MISO: IC6.3, SV4.5, U$1.SO, U$3.A2
MISO1: IC7.3, SV5.5, U$2.SO, U$4.A2
MOSI: IC6.2, SV4.3, U$1.SI, U$3.A3
MOSI1: IC7.2, SV5.3, U$2.SI, U$4.A3
unnamed: IC4.2, Q2.2
unnamed: IC4.3, Q2.1
unnamed: IC5.2, Q3.2
unnamed: IC5.3, Q3.1
unnamed: PAD19.1, U$1.ANT, U$3.B8
unnamed: PAD20.1, U$3.B6
unnamed: PAD21.1, U$3.B5
unnamed: PAD22.1, U$3.A7
unnamed: PAD23.1, U$2.ANT, U$4.B8
unnamed: PAD24.1, U$4.B6
unnamed: PAD25.1, U$4.B5
unnamed: PAD26.1, U$4.A7
unnamed: IC3.2, Q1.2
unnamed: IC3.3, Q1.1
NRST: IC3.6, J_RESET.2, NRST.1, R.12, R15.1
NRST1: IC4.6, J_RESET1.2, NRST1.1, R22.12, R24.1
NRST2: IC5.6, J_RESET2.2, NRST2.1, R31.12, R32.1
PA0: IC3.7, L.5
PA1: IC3.8, L.6
PA2: IC3.9, L.7
PA3: IC3.10, L.8
PA4: IC3.11, L.9
PA5: IC3.12, L.10
PA6: IC3.13, L.11
PA7: IC3.14, L.12
PA8: IC3.18, R.4
PA9: IC3.19, R.5
PA10: IC3.21, J_INT2.2, R.7
PA11: IC4.7, L1.5
PA12: IC4.8, L1.6
PA13: IC4.9, L1.7
PA14: IC4.10, L1.8
PA15: IC4.11, L1.9
PA16: IC4.12, L1.10
PA17: IC4.18, R22.4
PA18: IC4.19, R22.5
PA19: IC4.13, L1.11
PA20: IC4.14, L1.12
PA21: IC4.21, J_INT4.2, R22.7
PA22: IC5.7, L2.5
PA23: IC5.8, L2.6
PA24: IC5.9, L2.7
PA25: IC5.10, L2.8
PA26: IC5.11, L2.9
PA27: IC5.12, L2.10
PA28: IC5.18, R31.4
PA29: IC5.19, R31.5
PA30: IC5.13, L2.11
PA31: IC5.14, L2.12
PA32: IC5.21, J_INT6.2, R31.7
PB0: IC3.15, R.1
PB1: IC3.16, R.2
PB2: IC4.16, R22.2
PB3: IC4.17, R22.3
PB4: IC4.30, L1.1
PB5: IC4.15, R22.1
PB6: IC3.30, L.1
PB7: IC3.31, L.2
PB8: IC4.31, L1.2
PB9: IC5.16, R31.2
PB10: IC5.17, R31.3
PB11: IC5.30, L2.1
PB12: IC5.15, R31.1
PB13: IC5.31, L2.2
PB15: IC3.17, R.3
PC1: IC4.20, J_INT3.2, R22.6
PC2: IC5.20, J_INT5.2, R31.6
PC6: IC3.20, J_INT1.2, R.6
RESOUT: IC6.10, U$3.A6
RESOUT1: IC7.10, U$4.A6
SCK: IC6.5, SV4.4, U$1.SCLK, U$3.A4
SCK1: IC7.5, SV5.4, U$2.SCLK, U$4.A4
SCL: CL.3, CR.3, IC8.19
SCL1: CL1.3, CR1.3, IC1.19
SCL2: CL2.3, CR2.3, IC2.19
SCL3: I2C6.3, IC3.32, L.3, R18.1
SCL4: I2C10.7, IC3.22, R.8, R21.1
SCL5: I2C2.3, IC4.32, L1.3, R27.1
SCL6: I2C1.7, IC4.22, R22.8, R30.1
SCL7: I2C4.3, IC5.32, L2.3, R35.1
SCL8: I2C3.7, IC5.22, R31.8, R38.1
SDA: CL.4, CR.4, IC8.21
SDA1: CL1.4, CR1.4, IC1.21
SDA2: CL2.4, CR2.4, IC2.21
SDA3: I2C6.4, IC3.1, L.4, R19.1
SDA4: I2C10.1, IC3.23, R.9, R20.1
SDA5: I2C2.4, IC4.1, L1.4, R28.1
SDA6: I2C1.1, IC4.23, R22.9, R29.1
SDA7: I2C4.4, IC5.1, L2.4, R36.1
SDA8: I2C3.1, IC5.23, R31.9, R37.1
SPI1_MISO: IC3.28, SPI.1
SPI1_MISO1: IC4.28, SPI1.1
SPI1_MISO2: IC5.28, SPI2.1
SPI1_MOSI: IC3.29, SPI.4
SPI1_MOSI1: IC4.29, SPI1.4
SPI1_MOSI2: IC5.29, SPI2.4
SPI1_SCK: IC3.27, SPI.3
SPI1_SCK1: IC4.27, SPI1.3
SPI1_SCK2: IC5.27, SPI2.3
SPI1_SS: IC3.26, SPI.5
SPI1_SS1: IC4.26, SPI1.5
SPI1_SS2: IC5.26, SPI2.5
SPI_CS: IC8.1, J_CS.1
SPI_CS1: IC1.1, J_CS3.1
SPI_CS2: IC2.1, J_CS6.1
SPI_MISO: BUS.1, IC8.30, PAD1.1, R4.2
SPI_MISO1: BUS1.1, IC1.30, PAD7.1, R8.2
SPI_MISO2: BUS2.1, IC2.30, PAD13.1, R13.2
SPI_MOSI: BUS.4, IC8.31, PAD4.1, R2.2
SPI_MOSI1: BUS1.4, IC1.31, PAD10.1, R1.2
SPI_MOSI2: BUS2.4, IC2.31, PAD16.1, R10.2
SPI_SCK: BUS.3, IC8.32, PAD3.1, R3.2
SPI_SCK1: BUS1.3, IC1.32, PAD9.1, R7.2
SPI_SCK2: BUS2.3, IC2.32, PAD15.1, R12.2
SWCLK: IC8.25, J_CS1.1, SV1.2
SWCLK1: IC1.25, J_CS4.1, SV2.2
SWCLK2: IC2.25, J_CS7.1, SV3.2
SWCLK3: IC3.25, R.11, SWCLK.1
SWCLK4: IC4.25, R22.11, SWCLK1.1
SWCLK5: IC5.25, R31.11, SWCLK2.1
SWDIO: IC8.24, J_CS2.1, SV1.1
SWDIO1: IC1.24, J_CS5.1, SV2.1
SWDIO2: IC2.24, J_CS8.1, SV3.1
SWDIO3: IC3.24, R.10, SWDIO.1
SWDIO4: IC4.24, R22.10, SWDIO1.1
SWDIO5: IC5.24, R31.10, SWDIO2.1
SWRES: C15.1, IC8.6, J_CS.3, R23.1, SV1.3
SWRES1: C2.1, IC1.6, J_CS3.3, R6.1, SV2.3
SWRES2: C6.1, IC2.6, J_CS6.3, R11.1, SV3.3
U1: I2C1.4, L1.14
U2: I2C3.4, L2.14
U3.1: BUS1.2, C3.+, C4.1, CL1.1, CR1.1, IC1.4, PAD8.1, R1.1, R6.2, R7.1, R8.1, R9.1, SV2.4
U3.2: BUS2.2, C7.+, C8.1, CL2.1, CR2.1, IC2.4, PAD14.1, R10.1, R11.2, R12.1, R13.1, R14.1, SV3.4
U3.3: BUS.2, C1.1, C5.+, CL.1, CR.1, IC8.4, PAD2.1, R2.1, R3.1, R4.1, R5.1, R23.2, SV1.4
U5: I2C10.4, L.14
UBAT: I2C10.6, L.13
UBAT1: I2C1.6, L1.13
UBAT2: I2C3.6, L2.13
VCC: C9.1, C10.+, I2C6.2, I2C10.2, IC3.4, R.14, R15.2, R16.2, R17.2, R18.2, R19.2, R20.2, R21.2, SPI.2
VCC1: C11.1, C12.+, I2C1.2, I2C2.2, IC4.4, R22.14, R24.2, R25.2, R26.2, R27.2, R28.2, R29.2, R30.2, SPI1.2
VCC2: C13.1, C14.+, I2C3.2, I2C4.2, IC5.4, R31.14, R32.2, R33.2, R34.2, R35.2, R36.2, R37.2, R38.2, SPI2.2
VCC3: C16.1, C17.+, C18.+, IC6.1, R39.1, R40.1, R41.1, R42.1, R43.1, SV4.1, SV4.2, U$1.VCC, U$3.B4, X1.2
VCC4: C19.1, C20.+, C21.+, IC7.1, R44.1, R45.1, R46.1, R47.1, R48.1, SV5.1, SV5.2, U$2.VCC, U$4.B4, X2.2
