MS71/ROS2Mower/hw/nutzen_04.brd

## EAGLE design hw/nutzen_04.brd (2020-08-21)

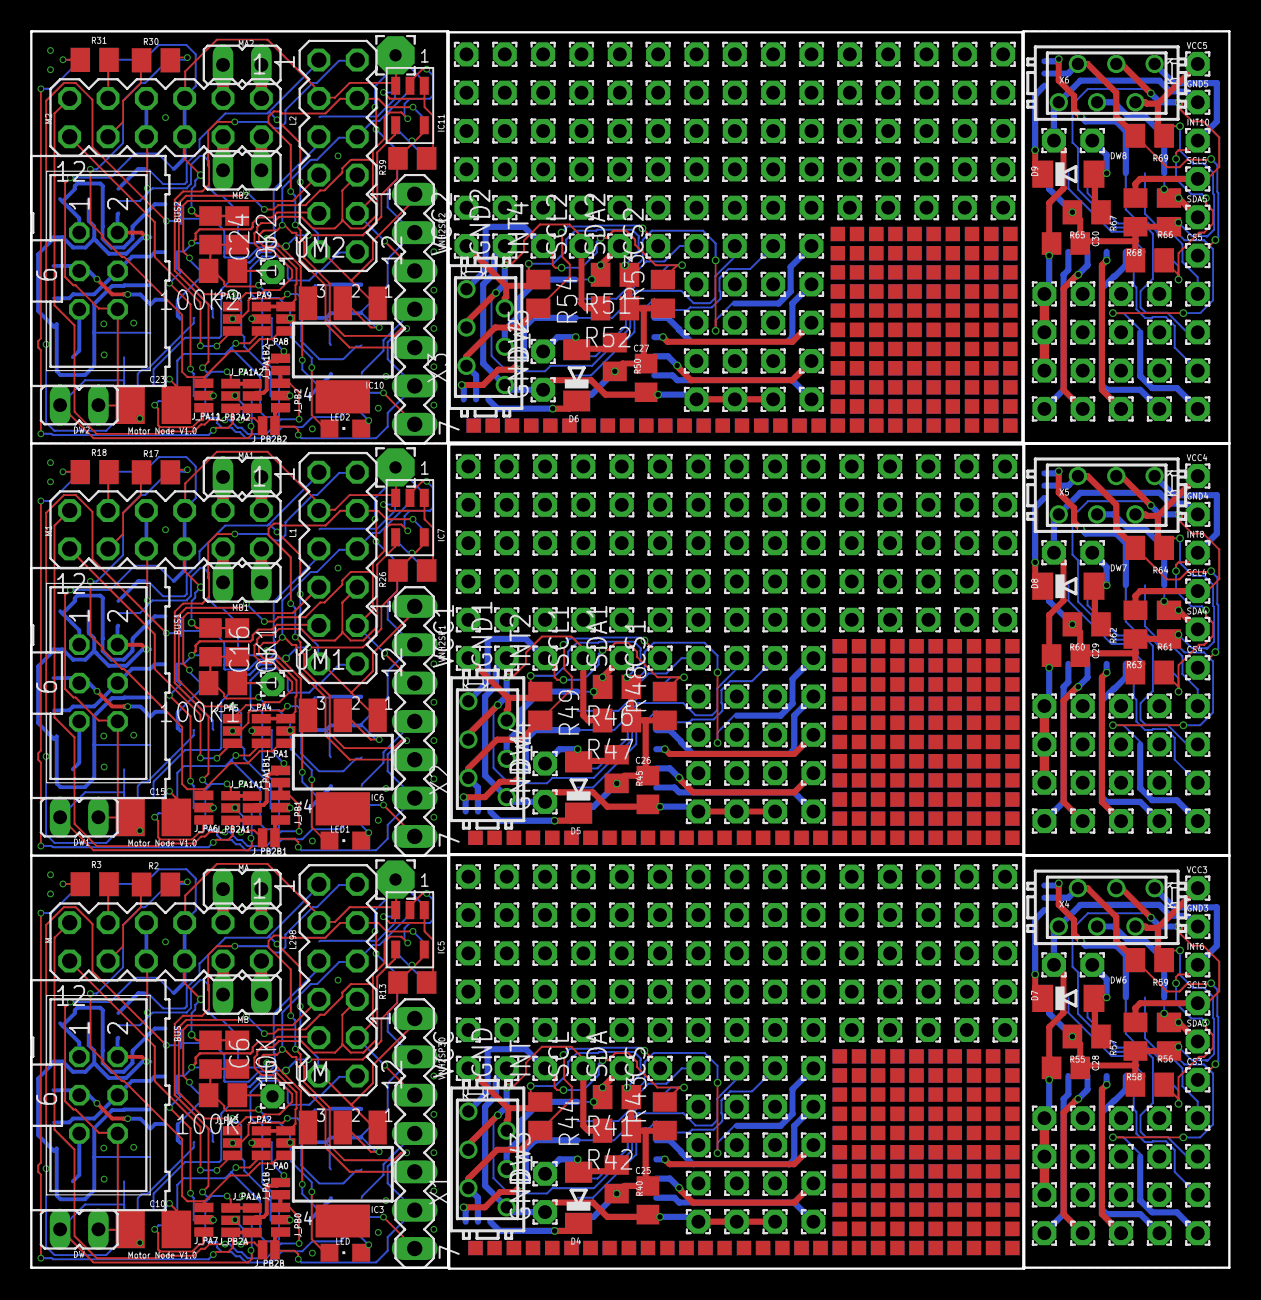
[picture p89: board nutzen_04.brd from above]

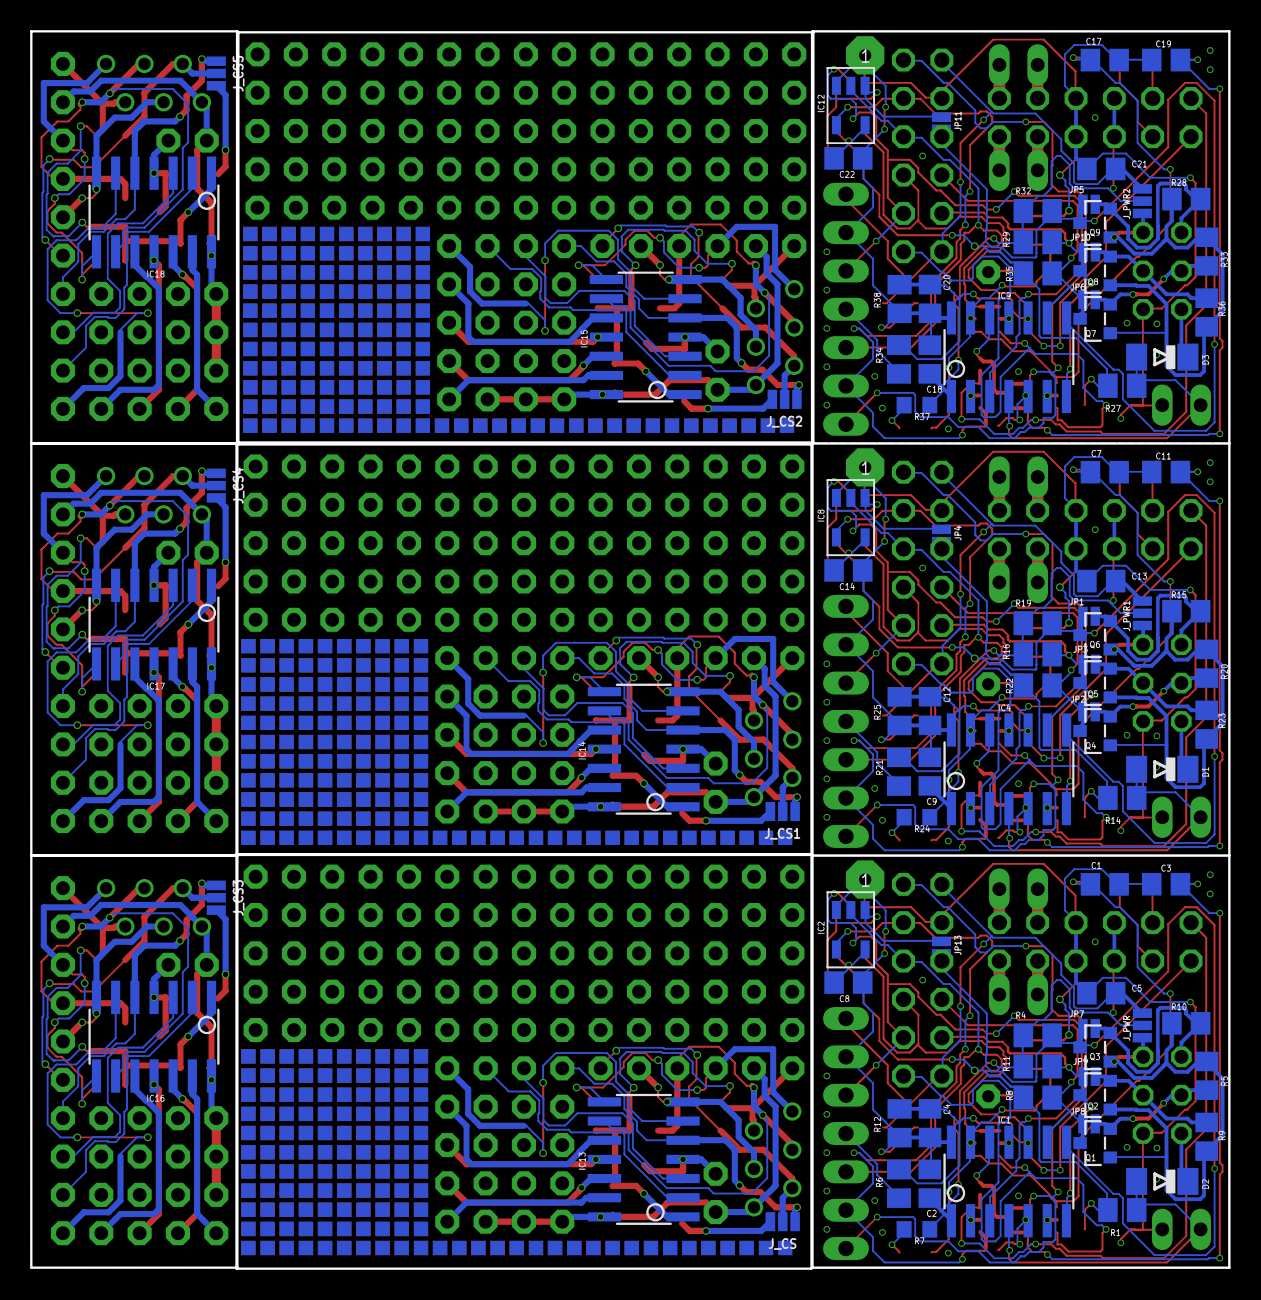
[picture p90: board nutzen_04.brd from below]

Board: 2 copper layers, 79.4 x 81.9 mm, 618 parts (93 on the bottom side), 213 nets.

Parts:
10K, 10K1, 10K2, 100K, 100K1, 100K2: 10k; M0805
BUS, BUS1, BUS2: ML6
C1, C3, C7, C11, C17, C19: 1n; C0805
C2, C4, C6, C9, C12, C16, C18, C20, C24, C25, C26, C27, C28, C29, C30: 100n; C0805
C5, C8, C13, C14, C21, C22: 0.1; C0805
C10, C15, C23: 100uF/6V; B/3528-21R
CS, CS1, CS2, CS3, CS4, CS5: 1,6/0,9
D1, D2, D3, D4, D5, D6, D7, D8, D9: MINIMELF
DW, DW1, DW2: JP1
DW3, DW4, DW5, DW6, DW7, DW8: 1,6/0,9
GND, GND1, GND2, GND3, GND4, GND5: 1,6/0,9
GND_, GND_1, GND_2, GND_3, GND_4, GND_5: 1,6/0,9
IC1, IC4, IC9, IC13, IC14, IC15, IC16, IC17, IC18: TINY84 or TINY841; SOIC14
IC2, IC5, IC7, IC8, IC11, IC12: SOT-23/5
IC3, IC6, IC10: MCP1703DB; SOT223
INT, INT0, INT1, INT2, INT3, INT4, INT5, INT6, INT7, INT8, INT9, INT10: 1,6/0,9
JP1, JP2, JP3, JP5, JP6, JP7, JP8, JP9, JP10: SMT-JUMPER_2_NC_PASTE_NO-SILK
JP4, JP11, JP13: SMT-JUMPER_2_NO_NO-SILK
J_CS, J_CS1, J_CS2, J_CS3, J_CS4, J_CS5: SMT-JUMPER_3_1-NC_PASTE_NO-SILK
J_PA0, J_PA1, J_PA1A, J_PA1A1, J_PA1A2, J_PA2, J_PA3, J_PA4, J_PA5, J_PA6, J_PA7, J_PA8, J_PA9, J_PA10, J_PA11: SMT-JUMPER_3_1-NC_PASTE_NO-SILK
J_PA1B, J_PA1B1, J_PA1B2: SMT-JUMPER_2_NO_NO-SILK
J_PB0, J_PB1, J_PB2, J_PB2A, J_PB2A1, J_PB2A2: SMT-JUMPER_3_1-NC_PASTE_NO-SILK
J_PB2B, J_PB2B1, J_PB2B2: SMT-JUMPER_2_NO_NO-SILK
J_PWR, J_PWR1, J_PWR2: SMT-JUMPER_3_1-NC_PASTE_NO-SILK
L1, L2, L298: MA06-2
LED, LED1, LED2: CHIPLED_0805
M, M1, M2: MA06-2
MA, MA1, MA2: JP1
MB, MB1, MB2: JP1
PA0, PA1, PA2, PA3, PA4, PA5, PA6, PA7, PA8, PA9, PA10, PA11, PA12, PA13, PA14, PA15, PA16, PA17, PA18, PA19, PA20, PA21, PA22, PA23, PA24, PA25, PA26, PA27, PA28, PA29: 1,6/0,9
PAD1, PAD2, PAD3: 2,54/0,8
PAD4, PAD5, PAD6, PAD7, PAD8, PAD9, PAD10, PAD11, PAD12, PAD13, PAD14, PAD15, PAD16, PAD17, PAD18, PAD19, PAD20, PAD21, PAD22, PAD23, PAD24, PAD25, PAD26, PAD27, PAD28, PAD29, PAD30, PAD31, PAD32, PAD33, PAD34, PAD35, PAD36, PAD37, PAD38, PAD39, PAD40, PAD41, PAD42, PAD43, PAD44, PAD45, PAD46, PAD47, PAD48, PAD49, PAD50, PAD51, PAD52, PAD53, PAD54, PAD55, PAD56, PAD57, PAD58, PAD59, PAD60, PAD61, PAD62, PAD63, PAD64, PAD65, PAD66, PAD67, PAD68, PAD69, PAD70, PAD71, PAD72, PAD73, PAD74, PAD75, PAD76, PAD77, PAD78, PAD79, PAD80, PAD81, PAD82, PAD83, PAD84, PAD85, PAD86, PAD87, PAD88, PAD89, PAD90, PAD91, PAD92, PAD93, PAD94, PAD95, PAD96, PAD97, PAD98, PAD99, PAD100, PAD101, PAD102, PAD103, PAD104, PAD105, PAD106, PAD107, PAD108, PAD109, PAD110, PAD111, PAD112, PAD113, PAD114, PAD115, PAD116, PAD117, PAD118, PAD119, PAD120, PAD121, PAD122, PAD123, PAD124, PAD125, PAD126, PAD127, PAD128, PAD129, PAD130, PAD131, PAD132, PAD133, PAD134, PAD135, PAD136, PAD137, PAD138, PAD139, PAD140, PAD141, PAD142, PAD143, PAD144, PAD145, PAD146, PAD147, PAD148, PAD149, PAD150, PAD151, PAD152, PAD153, PAD154, PAD155, PAD156, PAD157, PAD158, PAD159, PAD160, PAD161, PAD162, PAD163, PAD164, PAD165, PAD166, PAD167, PAD168, PAD169, PAD170, PAD171, PAD172, PAD173, PAD174, PAD175, PAD176, PAD177, PAD178, PAD179, PAD180, PAD181, PAD182, PAD183, PAD184, PAD185, PAD186, PAD187, PAD188, PAD189, PAD190, PAD191, PAD192, PAD193, PAD194, PAD195, PAD196, PAD197, PAD198, PAD199, PAD200, PAD201, PAD202, PAD203, PAD204, PAD205, PAD206, PAD207, PAD208, PAD209, PAD210, PAD211, PAD212, PAD213, PAD214, PAD215, PAD216, PAD217, PAD218, PAD219, PAD220, PAD221, PAD222, PAD223, PAD224, PAD225, PAD226, PAD227, PAD228, PAD229, PAD230, PAD231, PAD232, PAD233, PAD234, PAD235, PAD236, PAD237, PAD238, PAD239, PAD240, PAD241, PAD242, PAD243, PAD244, PAD245, PAD246, PAD247, PAD248, PAD249, PAD250, PAD251, PAD252, PAD253, PAD254, PAD255, PAD256, PAD257, PAD258, PAD259, PAD260, PAD261, PAD262, PAD263, PAD264, PAD265, PAD266, PAD267, PAD268, PAD269, PAD270, PAD271, PAD272, PAD273, PAD274, PAD275, PAD276, PAD277, PAD278, PAD279, PAD280, PAD281, PAD282, PAD283, PAD284, PAD285, PAD286, PAD287, PAD288, PAD289, PAD290, PAD291, PAD292, PAD293, PAD294, PAD295, PAD296, PAD297, PAD298, PAD299, PAD300: 1,6/0,9
PB0, PB1, PB2, PB3, PB4, PB5, PB6, PB7, PB8, PB9, PB10, PB11: 1,6/0,9
P_UM, P_UM1, P_UM2: 1,6/0,8
Q1, Q2, Q3, Q4, Q5, Q6, Q7, Q8, Q9: BSS138; SOT23
R1, R4, R6, R8, R11, R12, R14, R16, R19, R21, R22, R25, R27, R29, R32, R34, R35, R38, R40, R41, R42, R43, R44, R45, R46, R47, R48, R49, R50, R51, R52, R53, R54, R55, R56, R57, R58, R59, R60, R61, R62, R63, R64, R65, R66, R67, R68, R69: 10k; M0805
R2, R3, R17, R18, R30, R31: 1k; M0805
R5, R9, R10, R13, R15, R20, R23, R26, R28, R33, R36, R39: 10k; R0805
R7, R24, R37: 1k; R0603
SCL, SCL1, SCL2, SCL3, SCL4, SCL5: 1,6/0,9
SDA, SDA1, SDA2, SDA3, SDA4, SDA5: 1,6/0,9
VCC, VCC1, VCC2, VCC3, VCC4, VCC5: 1,6/0,9
VNH2SP1, VNH2SP2, VNH2SP30: MA07-1
X1, X2, X3, X4, X5, X6: BUS; MICROMATCH-6

Connections:
BUS_INT: BUS.1, JP7.1, Q3.2, R10.2
BUS_INT1: BUS1.1, JP1.1, Q6.2, R15.2
BUS_INT2: BUS2.1, JP5.1, Q9.2, R28.2
BUS_INT3: IC13.8, INT.1, R43.2, X1.1
BUS_INT4: IC14.8, INT2.1, R48.2, X2.1
BUS_INT5: IC15.8, INT4.1, R53.2, X3.1
BUS_INT6: IC16.8, INT6.1, R58.2, X4.1
BUS_INT7: IC17.8, INT8.1, R63.2, X5.1
BUS_INT8: IC18.8, INT10.1, R68.2, X6.1
BUS_P1: CS1.1, J_CS1.2, R49.2, X2.5
BUS_P2: CS2.1, J_CS2.2, R54.2, X3.5
BUS_P3: CS3.1, J_CS3.2, R59.2, X4.5
BUS_P4: CS4.1, J_CS4.2, R64.2, X5.5
BUS_P5: CS.1, J_CS.2, R44.2, X1.5
BUS_P6: CS5.1, J_CS5.2, R69.2, X6.5
BUS_RESET: BUS.5, D2.C
BUS_RESET1: BUS1.5, D1.C
BUS_RESET2: BUS2.5, D3.C
BUS_RESET3: D4.C, J_CS.3
BUS_RESET4: D5.C, J_CS1.3
BUS_RESET5: D6.C, J_CS2.3
BUS_RESET6: D7.C, J_CS3.3
BUS_RESET7: D8.C, J_CS4.3
BUS_RESET8: D9.C, J_CS5.3
BUS_SCL: BUS.3, JP8.1, Q1.2, R5.2
BUS_SCL1: BUS1.3, JP2.1, Q4.2, R20.2
BUS_SCL2: BUS2.3, JP6.1, Q7.2, R33.2
BUS_SCL3: IC13.9, R42.2, SCL.1, X1.3
BUS_SCL4: IC14.9, R47.2, SCL1.1, X2.3
BUS_SCL5: IC15.9, R52.2, SCL2.1, X3.3
BUS_SCL6: IC16.9, R57.2, SCL3.1, X4.3
BUS_SCL7: IC17.9, R62.2, SCL4.1, X5.3
BUS_SCL8: IC18.9, R67.2, SCL5.1, X6.3
BUS_SDA: BUS.4, JP9.1, Q2.2, R9.2
BUS_SDA1: BUS1.4, JP3.1, Q5.2, R23.2
BUS_SDA2: BUS2.4, JP10.1, Q8.2, R36.2
BUS_SDA3: IC13.7, R41.2, SDA.1, X1.4
BUS_SDA4: IC14.7, R46.2, SDA1.1, X2.4
BUS_SDA5: IC15.7, R51.2, SDA2.1, X3.4
BUS_SDA6: IC16.7, R56.2, SDA3.1, X4.4
BUS_SDA7: IC17.7, R61.2, SDA4.1, X5.4
BUS_SDA8: IC18.7, R66.2, SDA5.1, X6.4
DEBUGWIRE: D2.A, DW.1, IC1.4, R1.2
DEBUGWIRE1: D1.A, DW1.1, IC4.4, R14.2
DEBUGWIRE2: D3.A, DW2.1, IC9.4, R27.2
DW: D4.A, DW3.1, IC13.4, R40.2
DW1: D5.A, DW4.1, IC14.4, R45.2
DW2: D6.A, DW5.1, IC15.4, R50.2
DW3: D7.A, DW6.1, IC16.4, R55.2
DW4: D8.A, DW7.1, IC17.4, R60.2
DW5: D9.A, DW8.1, IC18.4, R65.2
GND: 10K.1, BUS.6, C1.1, C2.2, C3.2, C4.1, C5.2, C6.1, C8.2, C10.-, DW.2, IC1.14, IC2.3, IC3.2, IC5.3, L298.3, M.5, M.6, PAD1.1, R12.1, VNH2SP30.2
GND1: 10K1.1, BUS1.6, C7.1, C9.2, C11.2, C12.1, C13.2, C14.2, C15.-, C16.1, DW1.2, IC4.14, IC6.2, IC7.3, IC8.3, L1.3, M1.5, M1.6, PAD2.1, R25.1, VNH2SP1.2
GND2: 10K2.1, BUS2.6, C17.1, C18.2, C19.2, C20.1, C21.2, C22.2, C23.-, C24.1, DW2.2, IC9.14, IC10.2, IC11.3, IC12.3, L2.3, M2.5, M2.6, PAD3.1, R38.1, VNH2SP2.2
GND3: C25.2, GND.1, GND_.1, IC13.14, PAD100.1, PAD101.1, PAD102.1, X1.6
GND4: C26.2, GND1.1, GND_1.1, IC14.14, PAD175.1, PAD176.1, PAD177.1, X2.6
GND5: C27.2, GND2.1, GND_2.1, IC15.14, PAD262.1, PAD263.1, PAD264.1, X3.6
GND6: C28.2, GND3.1, GND_3.1, IC16.14, PAD274.1, PAD275.1, PAD276.1, X4.6
GND7: C29.2, GND4.1, GND_4.1, IC17.14, PAD286.1, PAD287.1, PAD288.1, X5.6
GND8: C30.2, GND5.1, GND_5.1, IC18.14, PAD298.1, PAD299.1, PAD300.1, X6.6
INT0: IC13.5, INT0.1, J_CS.1
INT1: IC14.5, INT1.1, J_CS1.1
INT2: IC15.5, INT3.1, J_CS2.1
INT3: IC16.5, INT5.1, J_CS3.1
INT4: IC17.5, INT7.1, J_CS4.1
INT5: IC18.5, INT9.1, J_CS5.1
INT_MISO: IC1.8, JP7.2, JP13.1, L298.5, Q3.3, R4.1
INT_MISO1: IC4.8, JP1.2, JP4.1, L1.5, Q6.3, R19.1
INT_MISO2: IC9.8, JP5.2, JP11.1, L2.5, Q9.3, R32.1
MA_A: IC2.2, J_PA0.1, J_PA2.3, L298.6, VNH2SP30.5
MA_A1: IC8.2, J_PA1.1, J_PA4.3, L1.6, VNH2SP1.5
MA_A2: IC12.2, J_PA8.1, J_PA9.3, L2.6, VNH2SP2.5
MA_B: IC2.4, J_PB0.3, J_PB2B.1, L298.4, VNH2SP30.6
MA_B1: IC8.4, J_PB1.3, J_PB2B1.1, L1.4, VNH2SP1.6
MA_B2: IC12.4, J_PB2.3, J_PB2B2.1, L2.4, VNH2SP2.6
MA_CS: R6.1, VNH2SP30.4
MA_CS1: R21.1, VNH2SP1.4
MA_CS2: R34.1, VNH2SP2.4
MA_CS_: C4.2, IC1.10, J_PA3.2, R6.2, R12.2
MA_CS_1: C12.2, IC4.10, J_PA5.2, R21.2, R25.2
MA_CS_2: C20.2, IC9.10, J_PA10.2, R34.2, R38.2
MA_E1: M.9, R3.2
MA_E1_: C3.1, J_PA1A.3, J_PB2A.1, R3.1
MA_E1_1: C11.1, J_PA1A1.3, J_PB2A1.1, R18.1
MA_E1_2: C19.1, J_PA1A2.3, J_PB2A2.1, R31.1
MA_E2: J_PA1B.2, J_PB0.1, M.11
MA_E3: M1.9, R18.2
MA_E4: J_PA1B1.2, J_PB1.1, M1.11
MA_E5: M2.9, R31.2
MA_E6: J_PA1B2.2, J_PB2.1, M2.11
MA_EN__MB_A: IC1.3, IC5.2, L298.10, VNH2SP30.3
MA_EN__MB_A1: IC4.3, IC7.2, L1.10, VNH2SP1.3
MA_EN__MB_A2: IC9.3, IC11.2, L2.10, VNH2SP2.3
MA_N: M.3, MA.1
MA_N1: M1.3, MA1.1
MA_N2: M2.3, MA2.1
MA_P: M.1, MA.2
MA_P1: M1.1, MA1.2
MA_P2: M2.1, MA2.2
MA_PWM: J_PA1A.1, J_PB2A.3, L298.2, VNH2SP30.7
MA_PWM1: J_PA1A1.1, J_PB2A1.3, L1.2, VNH2SP1.7
MA_PWM2: J_PA1A2.1, J_PB2A2.3, L2.2, VNH2SP2.7
MB_B: IC5.4, J_PA3.3, L298.8
MB_B1: IC7.4, J_PA5.3, L1.8
MB_B2: IC11.4, J_PA10.3, L2.8
MB_E1: M.10, R2.2
MB_E1_: C1.2, J_PA0.3, J_PA7.1, R2.1
MB_E1_1: C7.2, J_PA1.3, J_PA6.1, R17.1
MB_E1_2: C17.2, J_PA8.3, J_PA11.1, R30.1
MB_E2: J_PA3.1, M.12
MB_E3: J_PA5.1, M1.12
MB_E4: M1.10, R17.2
MB_E5: J_PA10.1, M2.12
MB_E6: M2.10, R30.2
MB_N: M.4, MB.2
MB_N1: M1.4, MB1.2
MB_N2: M2.4, MB2.2
MB_P: M.2, MB.1
MB_P1: M1.2, MB1.1
MB_P2: M2.2, MB2.1
MB_PWM: J_PA2.1, J_PA7.3, L298.12
MB_PWM1: J_PA4.1, J_PA6.3, L1.12
MB_PWM2: J_PA9.1, J_PA11.3, L2.12
unnamed: LED1.A, R24.1
unnamed: 100K.1, P_UM.1
unnamed: IC7.1, IC8.1, JP4.2, R26.1
unnamed: IC2.1, IC5.1, JP13.2, R13.1
unnamed: 100K1.1, P_UM1.1
unnamed: LED.A, R7.1
unnamed: LED2.A, R37.1
unnamed: IC11.1, IC12.1, JP11.2, R39.1
unnamed: 100K2.1, P_UM2.1
PA0: 10K.2, 100K.2, C6.2, IC1.13, J_PA0.2, LED.C
PA1: IC1.12, J_PA1A.2, J_PA1B.1
PA2: IC1.11, J_PA2.2
PA3: 10K1.2, 100K1.2, C16.2, IC4.13, J_PA1.2, LED1.C
PA4: IC4.12, J_PA1A1.2, J_PA1B1.1
PA5: IC4.11, J_PA4.2
PA6: IC4.6, J_PA6.2
PA7: IC1.6, J_PA7.2
PA8: 10K2.2, 100K2.2, C24.2, IC9.13, J_PA8.2, LED2.C
PA9: IC9.12, J_PA1A2.2, J_PA1B2.1
PA10: IC9.11, J_PA9.2
PA11: IC9.6, J_PA11.2
PA12: IC13.13, PA0.1
PA13: IC13.6, PA7.1
PA14: IC13.10, PA3.1
PA15: IC13.11, PA2.1
PA16: IC13.12, PA1.1
PA17: IC14.13, PA4.1
PA18: IC14.6, PA9.1
PA19: IC14.10, PA8.1
PA20: IC14.11, PA6.1
PA21: IC14.12, PA5.1
PA22: IC15.13, PA10.1
PA23: IC15.6, PA14.1
PA24: IC15.10, PA13.1
PA25: IC15.11, PA12.1
PA26: IC15.12, PA11.1
PA27: IC16.13, PA15.1
PA28: IC16.6, PA19.1
PA29: IC16.10, PA18.1
PA30: IC16.11, PA17.1
PA31: IC16.12, PA16.1
PA32: IC17.13, PA20.1
PA33: IC17.6, PA24.1
PA34: IC17.10, PA23.1
PA35: IC17.11, PA22.1
PA36: IC17.12, PA21.1
PA37: IC18.13, PA25.1
PA38: IC18.6, PA29.1
PA39: IC18.10, PA28.1
PA40: IC18.11, PA27.1
PA41: IC18.12, PA26.1
PB0: IC1.2, J_PB0.2
PB1: IC4.2, J_PB1.2
PB2: IC1.5, J_PB2A.2, J_PB2B.2
PB3: IC4.5, J_PB2A1.2, J_PB2B1.2
PB4: IC9.2, J_PB2.2
PB5: IC9.5, J_PB2A2.2, J_PB2B2.2
PB6: IC13.3, PB1.1
PB7: IC13.2, PB0.1
PB8: IC14.3, PB3.1
PB9: IC14.2, PB2.1
PB10: IC15.3, PB5.1
PB11: IC15.2, PB4.1
PB12: IC16.3, PB7.1
PB13: IC16.2, PB6.1
PB14: IC17.3, PB9.1
PB15: IC17.2, PB8.1
PB16: IC18.3, PB11.1
PB17: IC18.2, PB10.1
SCL_SCK: IC1.9, JP8.2, L298.7, Q1.3, R8.1
SCL_SCK1: IC4.9, JP2.2, L1.7, Q4.3, R22.1
SCL_SCK2: IC9.9, JP6.2, L2.7, Q7.3, R35.1
SDA_MOSI: IC1.7, JP9.2, L298.9, Q2.3, R11.1
SDA_MOSI1: IC4.7, JP3.2, L1.9, Q5.3, R16.1
SDA_MOSI2: IC9.7, JP10.2, L2.9, Q8.3, R29.1
U1: C13.1, IC6.1, J_PWR1.1, L1.1, L1.11, VNH2SP1.1
U2: C21.1, IC10.1, J_PWR2.1, L2.1, L2.11, VNH2SP2.1
U5: C5.1, IC3.1, J_PWR.1, L298.1, L298.11, VNH2SP30.1
U_BUS: BUS.2, J_PWR.3, Q1.1, Q2.1, Q3.1, R5.1, R9.1, R10.1
U_BUS1: BUS1.2, J_PWR1.3, Q4.1, Q5.1, Q6.1, R15.1, R20.1, R23.1
U_BUS2: BUS2.2, J_PWR2.3, Q7.1, Q8.1, Q9.1, R28.1, R33.1, R36.1
VCC: C2.1, C8.1, C10.+, IC1.1, IC2.5, IC3.3, IC5.5, J_PWR.2, M.7, M.8, R1.1, R4.2, R7.2, R8.2, R11.2, R13.2
VCC1: C9.1, C14.1, C15.+, IC4.1, IC6.3, IC7.5, IC8.5, J_PWR1.2, M1.7, M1.8, R14.1, R16.2, R19.2, R22.2, R24.2, R26.2
VCC2: C18.1, C22.1, C23.+, IC9.1, IC10.3, IC11.5, IC12.5, J_PWR2.2, M2.7, M2.8, R27.1, R29.2, R32.2, R35.2, R37.2, R39.2
VCC3: C25.1, IC13.1, R40.1, R41.1, R42.1, R43.1, R44.1, VCC.1, X1.2
VCC4: C26.1, IC14.1, R45.1, R46.1, R47.1, R48.1, R49.1, VCC1.1, X2.2
VCC5: C27.1, IC15.1, R50.1, R51.1, R52.1, R53.1, R54.1, VCC2.1, X3.2
VCC6: C28.1, IC16.1, R55.1, R56.1, R57.1, R58.1, R59.1, VCC3.1, X4.2
VCC7: C29.1, IC17.1, R60.1, R61.1, R62.1, R63.1, R64.1, VCC4.1, X5.2
VCC8: C30.1, IC18.1, R65.1, R66.1, R67.1, R68.1, R69.1, VCC5.1, X6.2
