MS71/ROS2Mower/hw/nutzen_06.brd

## EAGLE design hw/nutzen_06.brd (2020-08-21)

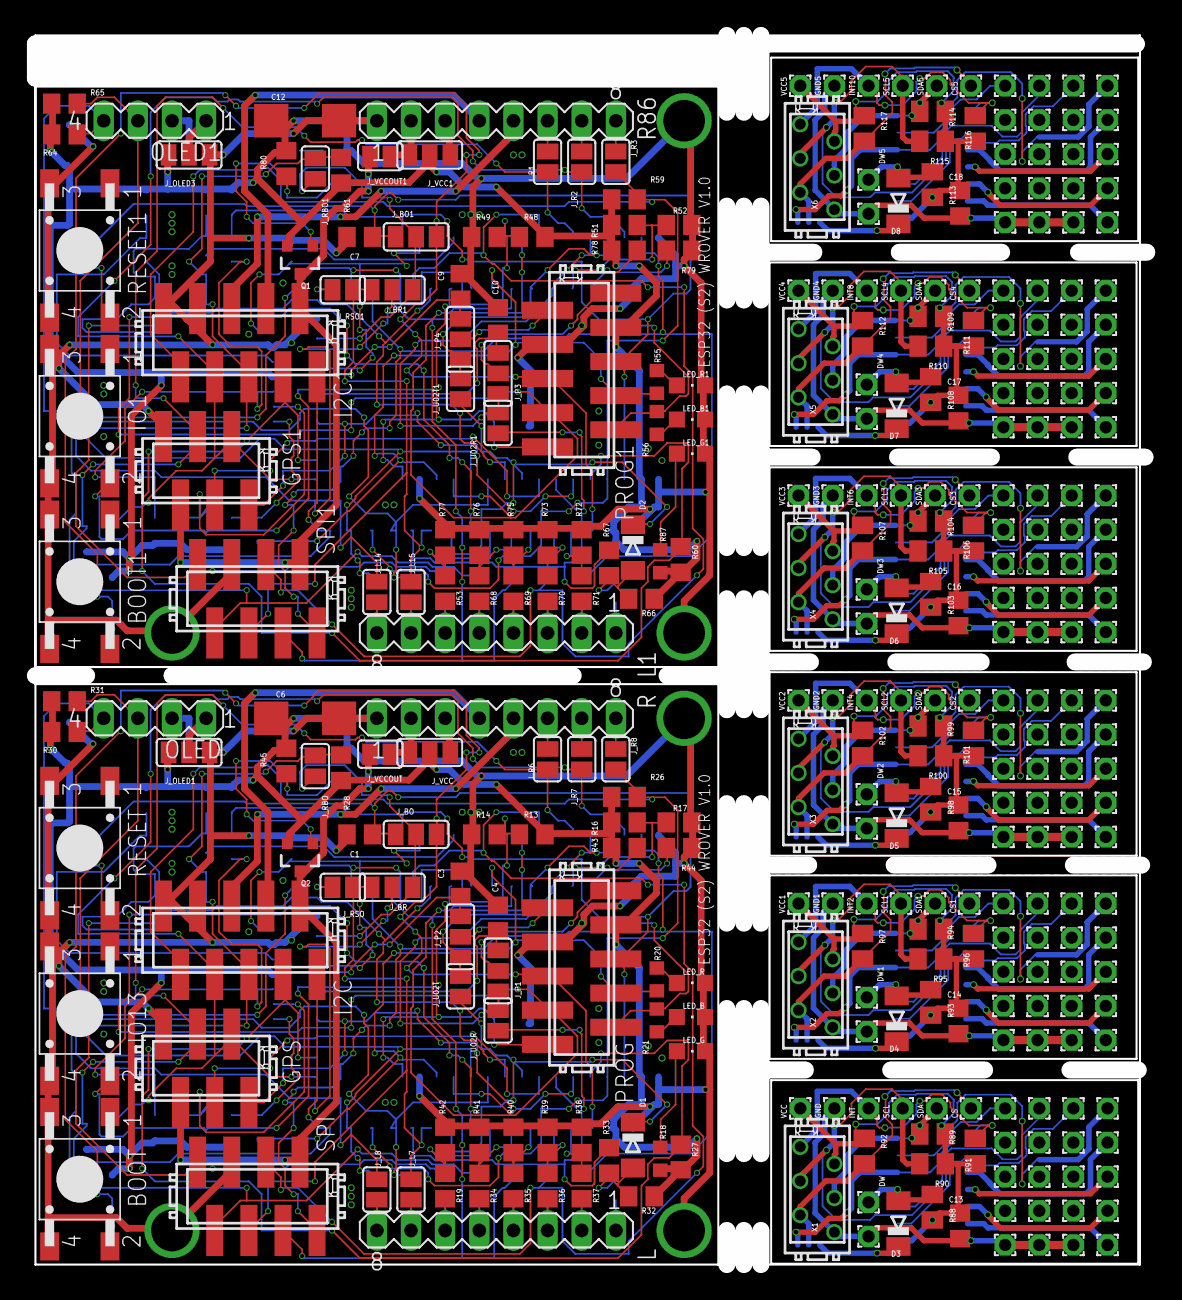
[picture p91: board nutzen_06.brd from above]

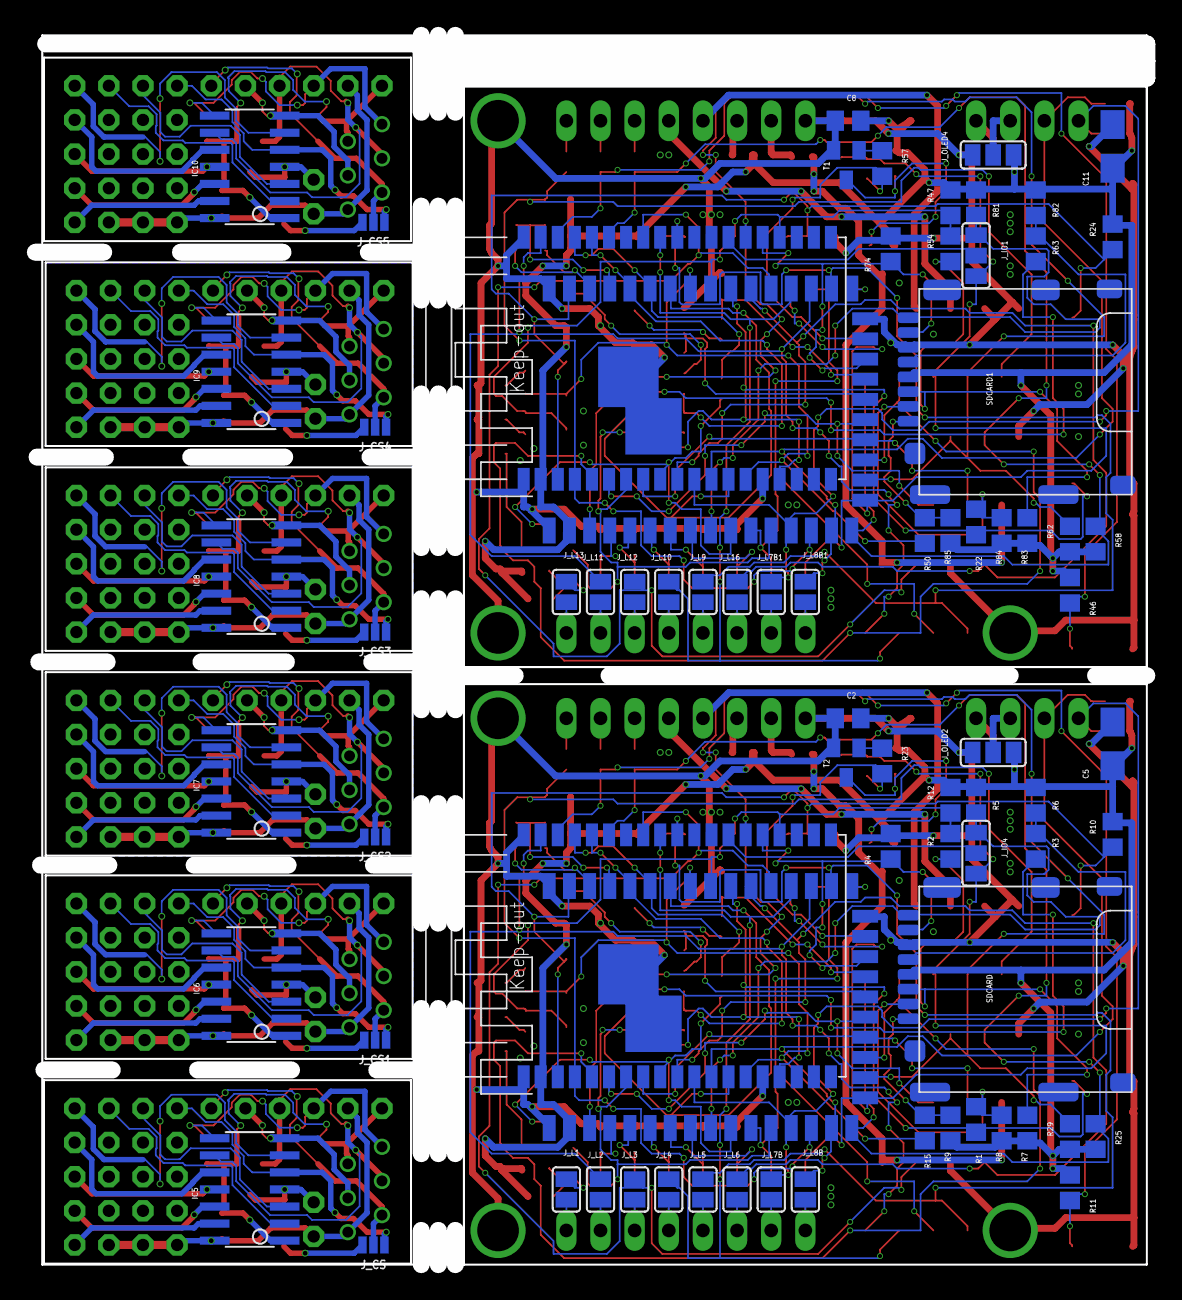
[picture p92: board nutzen_06.brd from below]

Board: 2 copper layers, 82.7 x 91.4 mm, 416 parts (76 on the bottom side), 238 nets.

Parts:
BOOT, BOOT1: TASTER-9314_SMD
C1, C2, C7, C8: 0.1; C0805
C3, C4, C9, C10: 22p; C0805
C5, C11: 10u; B/3528-21W
C6, C12: C/6032-28R
C13, C14, C15, C16, C17, C18: 100n; C0805
CS, CS1, CS2, CS3, CS4, CS5: 1,6/0,9
D1, D2: 4148; MINIMELF
D3, D4, D5, D6, D7, D8: MINIMELF
DW, DW1, DW2, DW3, DW4, DW5: 1,6/0,9
GND, GND1, GND2, GND3, GND4, GND5: 1,6/0,9
GND_, GND_1, GND_2, GND_3, GND_4, GND_5: 1,6/0,9
GPS, GPS1: GPS; MICROMATCH-6SMD
I2C, I2C1: I2CBUS; MICROMATCH-10SMD
IC1, IC3: ESP32-S2_WROVER; ESP32-S2-WROVER
IC2, IC4: ESP32-WROVER
IC5, IC6, IC7, IC8, IC9, IC10: TINY84 or TINY841; SOIC14
INT, INT0, INT1, INT2, INT3, INT4, INT5, INT6, INT7, INT8, INT9, INT10: 1,6/0,9
IO1, IO13: TASTER-9314_SMD
J_BO, J_BO1: SJ_2
J_BR, J_BR1: SJ_2
J_CS, J_CS1, J_CS2, J_CS3, J_CS4, J_CS5: SMT-JUMPER_3_1-NC_PASTE_NO-SILK
J_IO1, J_IO4: SJ_2
J_L1, J_L2, J_L3, J_L4, J_L5, J_L6, J_L7, J_L7B, J_L7B1, J_L8, J_L8B, J_L8B1, J_L9, J_L10, J_L11, J_L12, J_L13, J_L14, J_L15, J_L16: SJ
J_OLED1, J_OLED2, J_OLED3, J_OLED4: SJ_2
J_P1, J_P2, J_P3, J_P4: SJ_2
J_R1, J_R2, J_R3, J_R6, J_R7, J_R8: SJ
J_RBO, J_RBO1: SJ
J_RSO, J_RSO1: SJ
J_U02R, J_U02R1, J_U02T, J_U02T1: SJ
J_VCC, J_VCC1: SJ_2
J_VCCOUT, J_VCCOUT1: SJ
L, L1: MA08-1
LED_B, LED_B1: G; CHIPLED_0805
LED_G, LED_G1: G; CHIPLED_0805
LED_R, LED_R1: R; CHIPLED_0805
OLED, OLED1: MA04-1
PA0, PA1, PA2, PA3, PA4, PA5, PA6, PA7, PA8, PA9, PA10, PA11, PA12, PA13, PA14, PA15, PA16, PA17, PA18, PA19, PA20, PA21, PA22, PA23, PA24, PA25, PA26, PA27, PA28, PA29: 1,6/0,9
PAD1, PAD2, PAD3, PAD4, PAD5, PAD6, PAD7, PAD8, PAD9, PAD10, PAD11, PAD12, PAD13, PAD14, PAD15, PAD16, PAD17, PAD18, PAD19, PAD20, PAD21, PAD22, PAD23, PAD24, PAD25, PAD26, PAD27, PAD28, PAD29, PAD30, PAD31, PAD32, PAD33, PAD34, PAD35, PAD36, PAD37, PAD38, PAD39, PAD40, PAD41, PAD42, PAD43, PAD44, PAD45, PAD46, PAD47, PAD48, PAD49, PAD50, PAD51, PAD52, PAD53, PAD54, PAD55, PAD56, PAD57, PAD58, PAD59, PAD60, PAD89, PAD90, PAD91, PAD94, PAD95, PAD96, PAD97, PAD98, PAD99, PAD100, PAD101, PAD102: 1,6/0,9
PB0, PB1, PB2, PB3, PB4, PB5, PB6, PB7, PB8, PB9, PB10, PB11: 1,6/0,9
PROG, PROG1: I2CBUS; MICROMATCH-10SMD
Q1, Q2: IRLML2244; SOT23-3
R, R86: MA08-1
R1, R2, R3, R4, R5, R6, R7, R8, R9, R15, R19, R22, R25, R26, R27, R28, R29, R30, R31, R32, R33, R34, R35, R36, R37, R38, R39, R40, R41, R42, R50, R53, R54, R58, R59, R60, R61, R62, R63, R64, R65, R66, R67, R68, R69, R70, R71, R72, R73, R74, R75, R76, R77, R81, R82, R83, R84, R85: R0805
R10, R11, R12, R13, R14, R16, R17, R23, R24, R43, R44, R45, R46, R47, R48, R49, R51, R52, R57, R78, R79, R80: 10k; R0805
R18, R20, R21, R55, R56, R87: R0603
R88, R89, R90, R91, R92, R93, R94, R95, R96, R97, R98, R99, R100, R101, R102, R103, R104, R105, R106, R107, R108, R109, R110, R111, R112, R113, R114, R115, R116, R117: 10k; M0805
RESET, RESET1: TASTER-9314_SMD
SCL, SCL1, SCL2, SCL3, SCL4, SCL5: 1,6/0,9
SDA, SDA1, SDA2, SDA3, SDA4, SDA5: 1,6/0,9
SDCARD, SDCARD1: MICROSD_SD_MODE; MICRO_SD_CONNECTOR
SPI, SPI1: SPIBUS; MICROMATCH-8-SMD
T1, T2: SOT23-BEC
VCC, VCC1, VCC2, VCC3, VCC4, VCC5: 1,6/0,9
X1, X2, X3, X4, X5, X6: BUS; MICROMATCH-6

Connections:
BOOT: BOOT.2, IC1.3, IC2.IO0, J_BO.1, PROG.6, R11.1
BOOT1: BOOT1.2, IC3.3, IC4.IO0, J_BO1.1, PROG1.6, R46.1
BUS_FON: I2C.3, IC1.19, IC2.SENSOR_VN, R27.2
BUS_FON1: I2C1.3, IC3.19, IC4.SENSOR_VN, R60.2
BUS_INT: I2C.9, IC1.14, IC2.SENSOR_VP, J_R8.2, R26.2
BUS_INT1: I2C1.9, IC3.14, IC4.SENSOR_VP, J_R3.2, R59.2
BUS_INT2: IC5.8, INT.1, R91.2, X1.1
BUS_INT3: IC6.8, INT2.1, R96.2, X2.1
BUS_INT4: IC7.8, INT4.1, R101.2, X3.1
BUS_INT5: IC8.8, INT6.1, R106.2, X4.1
BUS_INT6: IC9.8, INT8.1, R111.2, X5.1
BUS_INT7: IC10.8, INT10.1, R116.2, X6.1
BUS_ON: IC1.25, J_BO.2, J_BR.1, J_RBO.2, R23.1
BUS_ON1: IC3.25, J_BO1.2, J_BR1.1, J_RBO1.2, R57.1
BUS_P1: CS1.1, J_CS1.2, R97.2, X2.5
BUS_P2: CS2.1, J_CS2.2, R102.2, X3.5
BUS_P3: CS3.1, J_CS3.2, R107.2, X4.5
BUS_P4: CS4.1, J_CS4.2, R112.2, X5.5
BUS_P5: CS.1, J_CS.2, R92.2, X1.5
BUS_P6: CS5.1, J_CS5.2, R117.2, X6.5
BUS_RESET: I2C.5, IC1.17, J_BR.2, J_IO4.3, J_L8.1, J_RBO.1, R28.2
BUS_RESET1: I2C1.5, IC3.17, J_BR1.2, J_IO1.3, J_L14.1, J_RBO1.1, R61.2
BUS_RESET2: D3.C, J_CS.3
BUS_RESET3: D4.C, J_CS1.3
BUS_RESET4: D5.C, J_CS2.3
BUS_RESET5: D6.C, J_CS3.3
BUS_RESET6: D7.C, J_CS4.3
BUS_RESET7: D8.C, J_CS5.3
BUS_SCL: GPS.2, I2C.7, IC1.18, IC2.IO22, J_R7.2, R29.2
BUS_SCL1: GPS1.2, I2C1.7, IC3.18, IC4.IO22, J_R2.2, R62.2
BUS_SCL2: IC5.9, R90.2, SCL.1, X1.3
BUS_SCL3: IC6.9, R95.2, SCL1.1, X2.3
BUS_SCL4: IC7.9, R100.2, SCL2.1, X3.3
BUS_SCL5: IC8.9, R105.2, SCL3.1, X4.3
BUS_SCL6: IC9.9, R110.2, SCL4.1, X5.3
BUS_SCL7: IC10.9, R115.2, SCL5.1, X6.3
BUS_SDA: GPS.4, I2C.1, IC1.16, IC2.IO21, J_R6.2, R25.2
BUS_SDA1: GPS1.4, I2C1.1, IC3.16, IC4.IO21, J_R1.2, R58.2
BUS_SDA2: IC5.7, R89.2, SDA.1, X1.4
BUS_SDA3: IC6.7, R94.2, SDA1.1, X2.4
BUS_SDA4: IC7.7, R99.2, SDA2.1, X3.4
BUS_SDA5: IC8.7, R104.2, SDA3.1, X4.4
BUS_SDA6: IC9.7, R109.2, SDA4.1, X5.4
BUS_SDA7: IC10.7, R114.2, SDA5.1, X6.4
DW: D3.A, DW.1, IC5.4, R88.2
DW1: D4.A, DW1.1, IC6.4, R93.2
DW2: D5.A, DW2.1, IC7.4, R98.2
DW3: D6.A, DW3.1, IC8.4, R103.2
DW4: D7.A, DW4.1, IC9.4, R108.2
DW5: D8.A, DW5.1, IC10.4, R113.2
EN: C1.1, IC1.41, IC2.EN, J_BO.3, PROG.5, R10.1, RESET.2
EN1: C7.1, IC3.41, IC4.EN, J_BO1.3, PROG1.5, R24.1, RESET1.2
GND: BOOT.3, BOOT.4, C1.2, C2.2, C3.2, C4.2, C5.-, C6.-, GPS.6, I2C.8, I2C.10, IC1.1, IC1.26, IC1.42, IC1.43, IC2.GND, IC2.GND2, IC2.GND3, IC2.GND_2, IO13.3, IO13.4, J_OLED1.1, J_OLED2.1, LED_B.C, LED_G.C, LED_R.C, PROG.4, R.1, R4.1, R14.1, R17.1, R38.2, R39.2, R40.2, R41.2, R42.2, R44.1, RESET.3, RESET.4, SDCARD.6, SPI.6, T2.E
GND1: BOOT1.3, BOOT1.4, C7.2, C8.2, C9.2, C10.2, C11.-, C12.-, GPS1.6, I2C1.8, I2C1.10, IC3.1, IC3.26, IC3.42, IC3.43, IC4.GND, IC4.GND2, IC4.GND3, IC4.GND_2, IO1.3, IO1.4, J_OLED3.1, J_OLED4.1, LED_B1.C, LED_G1.C, LED_R1.C, PROG1.4, R49.1, R52.1, R72.2, R73.2, R74.1, R75.2, R76.2, R77.2, R79.1, R86.1, RESET1.3, RESET1.4, SDCARD1.6, SPI1.6, T1.E
GND2: C13.2, GND.1, GND_.1, IC5.14, PAD100.1, PAD101.1, PAD102.1, X1.6
GND3: C14.2, GND1.1, GND_1.1, IC6.14, PAD10.1, PAD11.1, PAD12.1, X2.6
GND4: C15.2, GND2.1, GND_2.1, IC7.14, PAD22.1, PAD23.1, PAD24.1, X3.6
GND5: C16.2, GND3.1, GND_3.1, IC8.14, PAD34.1, PAD35.1, PAD36.1, X4.6
GND6: C17.2, GND4.1, GND_4.1, IC9.14, PAD46.1, PAD47.1, PAD48.1, X5.6
GND7: C18.2, GND5.1, GND_5.1, IC10.14, PAD58.1, PAD59.1, PAD60.1, X6.6
INT0: IC5.5, INT0.1, J_CS.1
INT1: IC6.5, INT1.1, J_CS1.1
INT2: IC7.5, INT3.1, J_CS2.1
INT3: IC8.5, INT5.1, J_CS3.1
INT4: IC9.5, INT7.1, J_CS4.1
INT5: IC10.5, INT9.1, J_CS5.1
LCD_1: J_OLED1.2, OLED.1
LCD_2: J_OLED2.2, OLED.2
LCD_3: J_OLED3.2, OLED1.1
LCD_4: J_OLED4.2, OLED1.2
MTCK: IC1.33, IC2.IO13, IO13.2, PROG.10, R1.2
MTCK1: IC3.33, IC4.IO13, IO1.2, PROG1.10, R22.2
MTDI: IC1.35, IC2.IO12, PROG.7, R15.2, R20.2
MTDI1: IC3.35, IC4.IO12, PROG1.7, R50.2, R55.2
MTDO: IC1.34, IC2.IO15, PROG.9, R2.2, R12.1, R21.2
MTDO1: IC3.34, IC4.IO15, PROG1.9, R47.1, R54.2, R56.2
MTMS: IC1.36, IC2.IO14, PROG.8, R3.2
MTMS1: IC3.36, IC4.IO14, PROG1.8, R63.2
unnamed: IC2.IO4, J_IO4.2
unnamed: Q2.1, R45.2, T2.C
unnamed: J_R6.1, R.6
unnamed: LED_G.A, R18.1
unnamed: J_R7.1, R.7
unnamed: J_P1.2, PROG.1
unnamed: LED_R1.A, R55.1
unnamed: LED_B1.A, R56.1
unnamed: J_L7B1.2, J_L15.2, L1.7
unnamed: J_L16.2, L1.6, R53.1
unnamed: J_L9.2, L1.5, R68.1
unnamed: J_R8.1, R.8
unnamed: J_L10.2, L1.4, R69.1
unnamed: J_L11.2, L1.2, R71.1
unnamed: J_L12.2, L1.3, R70.1
unnamed: J_L13.2, L1.1
unnamed: J_L8B1.2, J_L14.2, L1.8
unnamed: R23.2, T2.B
unnamed: J_P4.2, PROG1.2
unnamed: LED_R.A, R20.1
unnamed: LED_B.A, R21.1
unnamed: IC4.IO4, J_IO1.2
unnamed: Q1.1, R80.2, T1.C
unnamed: J_L7.2, J_L7B.2, L.7
unnamed: J_L6.2, L.6, R19.1
unnamed: R57.2, T1.B
unnamed: J_L8.2, J_L8B.2, L.8
unnamed: J_L5.2, L.5, R34.1
unnamed: J_L4.2, L.4, R35.1
unnamed: J_L2.2, L.2, R37.1
unnamed: J_L3.2, L.3, R36.1
unnamed: J_L1.2, L.1
unnamed: J_R1.1, R86.6
unnamed: J_P2.2, PROG.2
unnamed: J_R2.1, R86.7
unnamed: J_R3.1, R86.8
unnamed: LED_G1.A, R87.1
unnamed: J_P3.2, PROG1.1
OLED_SCL: IC1.15, IC2.IO27, J_L8B.1, OLED.3, R31.2
OLED_SCL1: IC3.15, IC4.IO27, J_L8B1.1, OLED1.3, R65.2
OLED_SDA: IC1.13, IC2.IO26, J_L7B.1, OLED.4, R30.2
OLED_SDA1: IC3.13, IC4.IO26, J_L7B1.1, OLED1.4, R64.2
PA0: IC5.13, PA0.1
PA1: IC5.12, PA1.1
PA2: IC5.11, PA2.1
PA3: IC5.10, PA3.1
PA4: IC6.13, PA4.1
PA5: IC6.6, PA9.1
PA6: IC6.10, PA8.1
PA7: IC5.6, PA7.1
PA8: IC6.11, PA6.1
PA9: IC6.12, PA5.1
PA10: IC7.13, PA10.1
PA11: IC7.6, PA14.1
PA12: IC7.10, PA13.1
PA13: IC7.11, PA12.1
PA14: IC7.12, PA11.1
PA15: IC8.13, PA15.1
PA16: IC8.6, PA19.1
PA17: IC8.10, PA18.1
PA18: IC8.11, PA17.1
PA19: IC8.12, PA16.1
PA20: IC9.13, PA20.1
PA21: IC9.6, PA24.1
PA22: IC9.10, PA23.1
PA23: IC9.11, PA22.1
PA24: IC9.12, PA21.1
PA25: IC10.13, PA25.1
PA26: IC10.6, PA29.1
PA27: IC10.10, PA28.1
PA28: IC10.11, PA27.1
PA29: IC10.12, PA26.1
PB0: IC5.2, PB0.1
PB1: IC5.3, PB1.1
PB2: IC6.3, PB3.1
PB3: IC6.2, PB2.1
PB4: IC7.3, PB5.1
PB5: IC7.2, PB4.1
PB6: IC8.3, PB7.1
PB7: IC8.2, PB6.1
PB8: IC9.3, PB9.1
PB9: IC9.2, PB8.1
PB10: IC10.3, PB11.1
PB11: IC10.2, PB10.1
S2_IO1: IC1.4, R37.2, R38.1
S2_IO2: IC1.5, R36.2, R39.1
S2_IO3: IC1.6, R35.2, R40.1
S2_IO4: IC1.7, R34.2, R41.1
S2_IO5: IC1.8, R19.2, R42.1
S2_IO6: IC3.8, R53.2, R77.1
S2_IO7: IC3.7, R68.2, R76.1
S2_IO8: IC3.6, R69.2, R75.1
S2_IO9: IC3.5, R70.2, R73.1
S2_IO10: IC3.4, R71.2, R72.1
S2_IO11: IC3.39, R51.1, R52.2
S2_IO12: IC3.40, R78.1, R79.2
S2_IO45: IC1.39, R16.1, R17.2
S2_IO46: IC1.40, R43.1, R44.2
SD_CLK: R3.1, R6.2, SDCARD.5
SD_CLK1: R63.1, R82.2, SDCARD1.5
SD_CMD: R2.1, R7.2, SDCARD.3
SD_CMD1: R54.1, R83.2, SDCARD1.3
SD_D0: IC1.24, IC2.IO2, R4.2, SDCARD.7
SD_D1: IC1.9, J_IO4.1, R5.2, SDCARD.8
SD_D2: R9.2, R15.1, SDCARD.1
SD_D3: R1.1, R8.2, SDCARD.2
SD_D4: IC3.9, J_IO1.1, R81.2, SDCARD1.8
SD_D5: IC3.24, IC4.IO2, R74.2, SDCARD1.7
SD_D6: R22.1, R84.2, SDCARD1.2
SD_D7: R50.1, R85.2, SDCARD1.1
SPI_CS0: IC1.28, IC2.IO5, J_L5.1, R13.1, R14.2, SPI.7
SPI_CS1: IC1.32, IC2.IO25, J_L6.1, SPI.8
SPI_CS2: IC3.32, IC4.IO25, J_L16.1, SPI1.8
SPI_CS3: IC3.28, IC4.IO5, J_L9.1, R48.1, R49.2, SPI1.7
SPI_MISO: IC1.29, IC2.IO23, J_L2.1, SPI.1
SPI_MISO1: IC3.29, IC4.IO23, J_L11.1, SPI1.1
SPI_MOSI: IC1.31, IC2.IO19, J_L3.1, SPI.4
SPI_MOSI1: IC3.31, IC4.IO19, J_L12.1, SPI1.4
SPI_ON: IC1.27, J_RSO.2
SPI_ON1: IC3.27, J_RSO1.2
SPI_RESET: IC1.11, J_BR.3, J_L7.1, J_RSO.1, SPI.5
SPI_RESET1: IC3.11, J_BR1.3, J_L15.1, J_RSO1.1, SPI1.5
SPI_SCK: IC1.30, IC2.IO18, J_L4.1, SPI.3
SPI_SCK1: IC3.30, IC4.IO18, J_L10.1, SPI1.3
U0RXD: IC1.38, IC2.RXD0, J_P1.3, J_U02R.1
U0RXD1: IC3.38, IC4.RXD0, J_P3.3, J_U02R1.1
U0TXD: IC1.37, IC2.TXD0, J_P2.3, J_U02T.1
U0TXD1: IC3.37, IC4.TXD0, J_P4.3, J_U02T1.1
U1: I2C1.4, R86.4
U1RXD: GPS.1, IC1.21, IC2.IO34
U1RXD1: GPS1.1, IC3.21, IC4.IO34
U1TXD: GPS.3, IC1.20, IC2.IO32
U1TXD1: GPS1.3, IC3.20, IC4.IO32
U2RXD: IC1.12, IC2.IO35, J_U02R.2, R33.2
U2RXD1: IC3.12, IC4.IO35, J_U02R1.2, R67.2
U2TXD: D1.C, IC1.10, IC2.IO33, J_U02T.2
U2TXD1: D2.C, IC3.10, IC4.IO33, J_U02T1.2
U2_BUS: D1.A, J_L1.1, R32.1, R33.1
U2_BUS1: D2.A, J_L13.1, R66.1, R67.1
U5: I2C.4, R.4
U33A: J_VCC.3, J_VCCOUT.2, R.2
U33A1: J_VCC1.3, J_VCCOUT1.2, R86.2
U33B: J_VCC.1, R.3
U33B1: J_VCC1.1, R86.3
UBAT: I2C.6, R.5
UBAT1: I2C1.6, R86.5
UBUS: GPS.5, I2C.2, J_VCCOUT.1, Q2.3, SPI.2
UBUS1: GPS1.5, I2C1.2, J_VCCOUT1.1, Q1.3, SPI1.2
USBN: C4.1, IC1.22, J_P1.1
USBN1: C10.1, IC3.22, J_P3.1
USBP: C3.1, IC1.23, J_P2.1
USBP1: C9.1, IC3.23, J_P4.1
VCC: C2.1, C5.+, C6.+, IC1.2, IC2.VDD33, J_OLED1.3, J_OLED2.3, J_VCC.2, PROG.3, Q2.2, R5.1, R6.1, R7.1, R8.1, R9.1, R10.2, R11.2, R12.2, R13.2, R16.2, R18.2, R25.1, R26.1, R27.1, R28.1, R29.1, R30.1, R31.1, R32.2, R43.2, R45.1, SDCARD.4
VCC1: C8.1, C11.+, C12.+, IC3.2, IC4.VDD33, J_OLED3.3, J_OLED4.3, J_VCC1.2, PROG1.3, Q1.2, R24.2, R46.2, R47.2, R48.2, R51.2, R58.1, R59.1, R60.1, R61.1, R62.1, R64.1, R65.1, R66.2, R78.2, R80.1, R81.1, R82.1, R83.1, R84.1, R85.1, R87.2, SDCARD1.4
VCC2: C13.1, IC5.1, R88.1, R89.1, R90.1, R91.1, R92.1, VCC.1, X1.2
VCC3: C14.1, IC6.1, R93.1, R94.1, R95.1, R96.1, R97.1, VCC1.1, X2.2
VCC4: C15.1, IC7.1, R98.1, R99.1, R100.1, R101.1, R102.1, VCC2.1, X3.2
VCC5: C16.1, IC8.1, R103.1, R104.1, R105.1, R106.1, R107.1, VCC3.1, X4.2
VCC6: C17.1, IC9.1, R108.1, R109.1, R110.1, R111.1, R112.1, VCC4.1, X5.2
VCC7: C18.1, IC10.1, R113.1, R114.1, R115.1, R116.1, R117.1, VCC5.1, X6.2
