MS71/ROS2Mower/hw/nutzen_01.brd

## EAGLE design hw/nutzen_01.brd (2020-06-22)

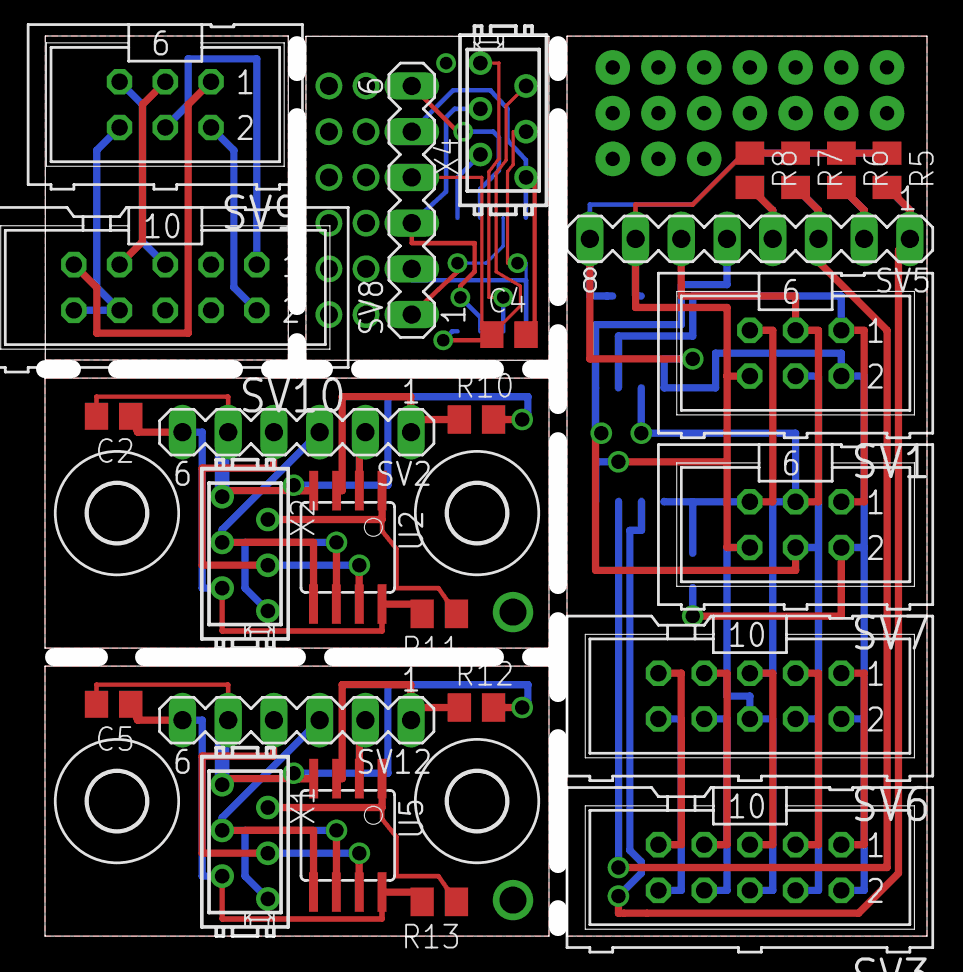
[picture p93: board nutzen_01.brd from above]

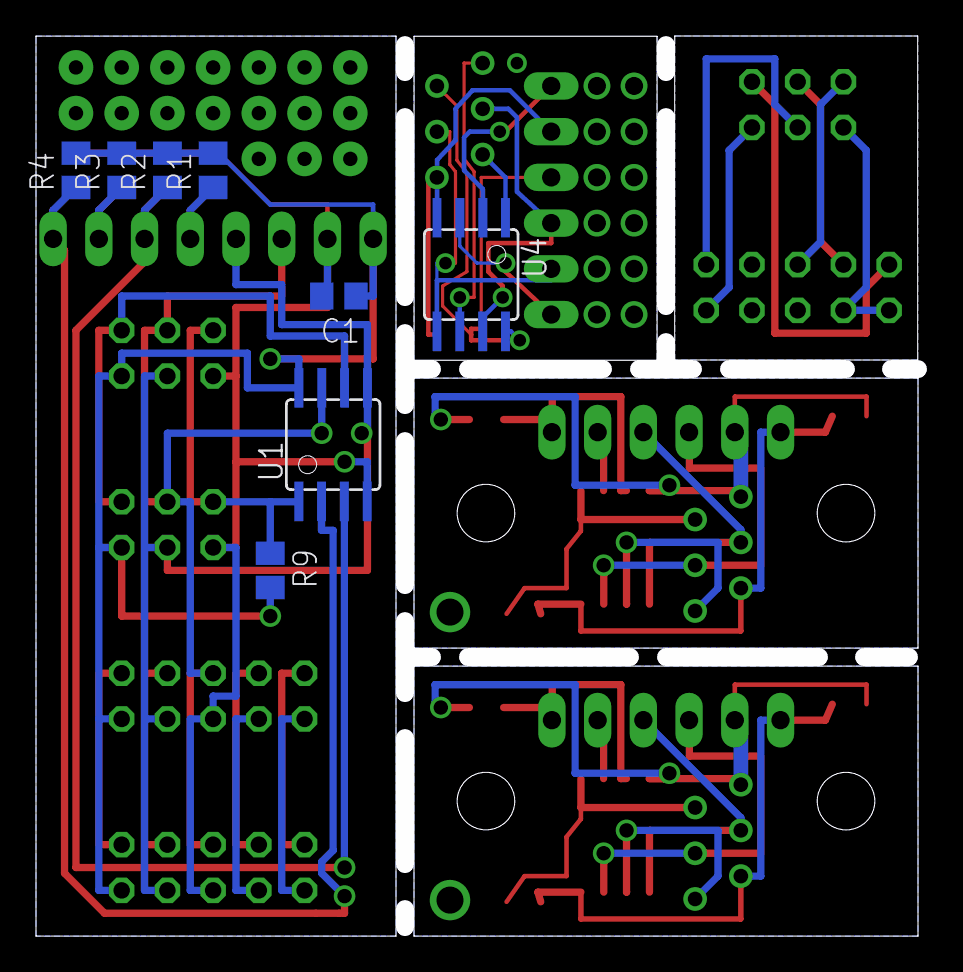
[picture p94: board nutzen_01.brd from below]

Board: 2 copper layers, 49.0 x 50.0 mm, 38 parts (8 on the bottom side), 46 nets.

Parts:
C1, C2, C4, C5: 100n; C0805
H1, H2, H11, H12: MOUNT-HOLE3.2; 3,2
R1, R2, R3, R4, R5, R6, R7, R8, R9, R10, R11, R12, R13: 100k; M0805
SV1, SV7, SV9: ML6
SV2, SV12: VL53L1X; MA06-1
SV3, SV6, SV10: ML10
SV5: BNO055; MA08-1
SV8: MA06-1
U1, U2, U4, U5: TINY45; SOIC8
X1, X2, X4: BUS; MICROMATCH-6

Connections:
BNO055_ADD: R1.1, R8.2, SV5.4
BNO055_BOOT: R3.1, R6.2, SV5.2
BNO055_INT: R2.1, R7.2, SV5.3, U1.3
BNO055_RESET: R4.1, R5.2, SV5.1, U1.2
GND: C1.2, R5.1, R6.1, R7.1, R8.1, SV1.6, SV3.6, SV5.7, SV6.6, SV7.6, U1.4
GND1: C2.2, R10.2, SV2.5, U2.4, X2.6
GND3: C4.2, SV8.5, U4.4, X4.6
GND4: C5.2, R12.2, SV12.5, U5.4, X1.6
GND5: SV9.6, SV10.8, SV10.10
GPIO01: SV2.2, U2.2
GPIO04: SV12.2, U5.2
INT: SV9.1, SV10.9
INT_MISO: SV1.1, SV7.1, U1.6
INT_MISO1: U2.6, X2.1
INT_MISO3: U4.6, X4.1
INT_MISO4: U5.6, X1.1
unnamed: SV3.7, SV6.7
unnamed: SV3.9, SV6.9
unnamed: SV3.8, SV6.8
unnamed: SV3.10, SV6.10
PB1: SV8.6, U4.2
PB2: SV8.1, U4.3
RESET: R9.1, SV1.5, SV7.5, U1.1
RESET1: R11.1, U2.1, X2.5
RESET3: U4.1, X4.5
RESET4: R13.1, U5.1, X1.5
RESET5: SV9.5, SV10.5
RXD: SV3.1, SV6.1
SCL: SV9.3, SV10.7
SCL_SCK: SV1.3, SV3.5, SV5.6, SV6.5, SV7.3, U1.7
SCL_SCK1: SV2.4, U2.7, X2.3
SCL_SCK3: SV8.3, U4.7, X4.3
SCL_SCK4: SV12.4, U5.7, X1.3
SDA: SV9.4, SV10.1
SDA_MOSI: SV1.4, SV3.4, SV5.5, SV6.4, SV7.4, U1.5
SDA_MOSI1: SV2.3, U2.5, X2.4
SDA_MOSI3: SV8.2, U4.5, X4.4
SDA_MOSI4: SV12.3, U5.5, X1.4
TXD: SV3.3, SV6.3
U33: SV9.2, SV10.2
VCC: C1.1, R1.2, R2.2, R3.2, R4.2, R9.2, SV1.2, SV3.2, SV5.8, SV6.2, SV7.2, U1.8
VCC1: C2.1, R11.2, SV2.6, U2.8, X2.2
VCC3: C4.1, SV8.4, U4.8, X4.2
VCC4: C5.1, R13.2, SV12.6, U5.8, X1.2
XSHUT1: R10.1, SV2.1, U2.3
XSHUT3: R12.1, SV12.1, U5.3
