MS71/ROS2Mower/(commit log)

2020-05-26 esp32 added
    [partitions.csv]
2020-06-22 ros2 added
    [imu_node.brd, imu_node.sch, lidar_node.brd, lidar_node.sch, nutzen_01.brd, spi_cam.sch, split_node.brd, split_node.sch]
2020-06-27 some improvements on ros2node and motor driver
2020-06-29 i2c problem solved
2020-07-04 motor_node added
    [motor_node.brd, motor_node.sch]
2020-07-11 SD card and SPI added
    [partitions.csv]
2020-07-19 work in progress
    [main_node.sch, spi_node.brd, spi_node.sch]
2020-07-19 i2cstress added
2020-07-19 some PCBs added
    [esp32_module.brd, esp32_module.sch, main_node.sch, spi_node.brd, spi_node.sch, stm32g071_pcb.brd, stm32g071_pcb.sch]
2020-08-04 pid bug fixed
2020-08-09 stabi thread added
    [motorchassis_01.scad]
2020-08-21 some files updated
    [main_node.sch, motor_node.brd, stm32g071_pcb.brd, uni_node.brd]
2020-08-21 minior monification
    [motorchassis_01.scad]
2020-09-03 support for new pcbs added
2020-09-12 rebase to microros app
    [partitions.csv]
2020-11-13 current sw
