MS71/ROS2Mower/(notices)

Notices in the files:
parts and their libraries:
inductor-sumida: Copyright (C) 2008, Bob Starr
User-Submitted: Licensing: Creative Commons ShareAlike 4.0 International - https://creativecommons.org/licenses/by-sa/4.0
modules: Released under the Creative Commons Attribution 4.0 International License: http://creativecommons.org/licenses/by/4.0
